clasicus/Diplom/0001.jpg

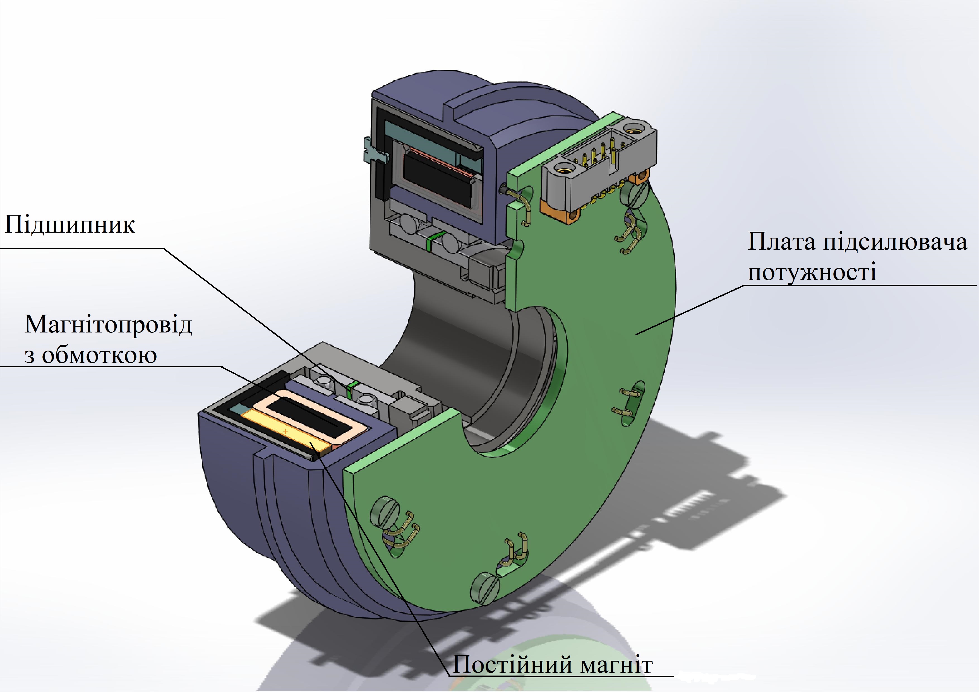
0001.jpg
