clasicus/Diplom/ВЕДОМОСТЬ.docx

ВІДОМІСТЬ ДИПЛОМНОГО ПРОЕКТУ

№ з/п | Формат | | Позначення | | | Найменування | | | Кількість листів | | Примітка
1 | А4 | | | | | Завдання на дипломний проект | | | 3
2 | А4 | | ДК61с.466452.001 ПЗ | | | Автоматична фотометрична система. Пояснювальна записка | | | 75
3 | А3 | | ДК61с.466452.001 Є1 | | | Автоматична фотометрична система. Схема ділення структурна | | | 1
4 | А2 | | ДК61с.466345.001 Е1 | | | Блок вимірювання. Схема електрична структурна | | | 1
5 | А2 | | ДК61с.466345.001 Е3 | | | Блок вимірювання. Схема електрична принципова | | | 1
6 | А4 | | ДК61с.466345.001 ПЕ3 | | | Блок вимірювання. Перелік елементів | | | 3
7 | А3 | | ДК61с.466449.001 Е3 | | | Блок керування. Схема електрична принципова | | | 1
8 | А4 | | ДК61с.466449.001 ПЕ3 | | | Блок керування. Перелік елементів | | | 1
9 | А1 | | ДК61с.758735.001 | | | Плата друкована | | | 1
10 | А1 | | ДК61с.758723.001 | | | Плата друкована | | | 1
11 | А1 | | ДК61с.750706.001 СК | | | Плата. Складальне креслення | | | 1
12 | А4 | | ДК61с.750706.001 СП | | | Плата. Специфікація | | | 3
13 | А1 | | ДК61с.750706.002 СК | | | Плата. Складальне креслення | | | 1
14 | А4 | | ДК61с.750706.002 СП | | | Плата. Специфікація | | | 1
15 | А1 | | ДК61с.735591.001 | | | Кришка | | | 1
16 | А1 | | ДК61с.741124.001 | | | Деталь | | | 1
17 | А1 | | ДК61с.750706.003 СК | | | Корпус. Складальне креслення. | | | 1
18 | А4 | | ДК61с.750706.003 СП | | | Корпус. Специфікація | | | 1
| | ПІБ | | Підп. | Дата
Розробн. | | Адаменко І.О. | | | | | Відомість дипломного проекту | Лист | | Листів
Керівн. | | Губар В.Г. | | | | | | 1 | | 1
Консульт. | | | | | | | | НТУУ «КПІ ім. І.Сікорського» Каф. КЕОА Гр. ДК-61с
Н.контр. | | Лисенко О.І.
