clasicus/Diplom/ДИПЛОМ/Altium/Документация/ecs-3961_3963.pdf

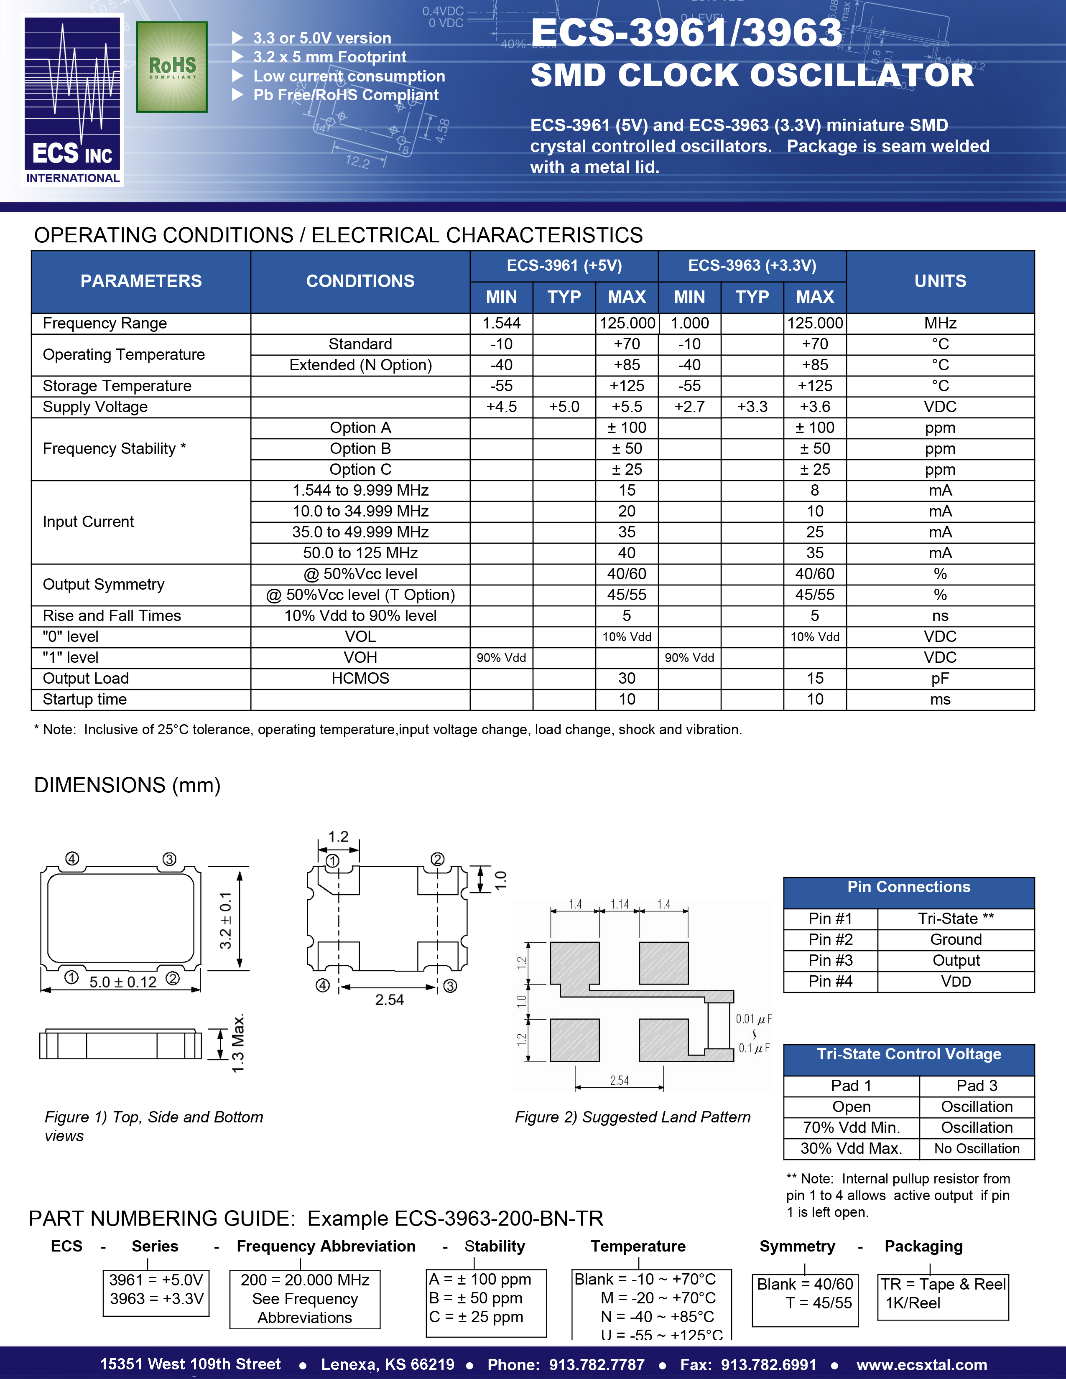
[picture p29: page 1]
