clasicus/Diplom/ДИПЛОМ/Altium/Документация/Папка/АЧАД.524656.003АСК_2/АЧАД.52хххх.ххх_Э3.pdf

Лист Инв.№ подл. Подп.и дата Взам.инв.№ Инв.№ дубл. Справ.№ Перв.примен. | Лит. | Масштаб Подп. и дата

Формат A4

| | | | | АЧАД.52хххх.ххх Э3
| | | | | Двигун СХЕМА ЕЛЕКТРИЧНА ПРИНЦИПОВА | | Масса
Изм. | Лист | № докум. | Подп. | Дата
Разраб. | | Ільницька ЛЛ
| | Пров. | Бондарчук ПС
Т.контр. | | | | | | Листов 1
Нач.сект. | | | | | ТОВ "Радіонікс"
Н.контр.
Утв.

### 1 АЧАД.52хххх.ххх

Копировал

Коло | Конт.
XS1 | A
+ | MA1

Поз.
обозна- | Наименование
чение
Кол. | Примечание
