clasicus/Diplom/ААЭД.521366.002 СБ Двигун.JPG

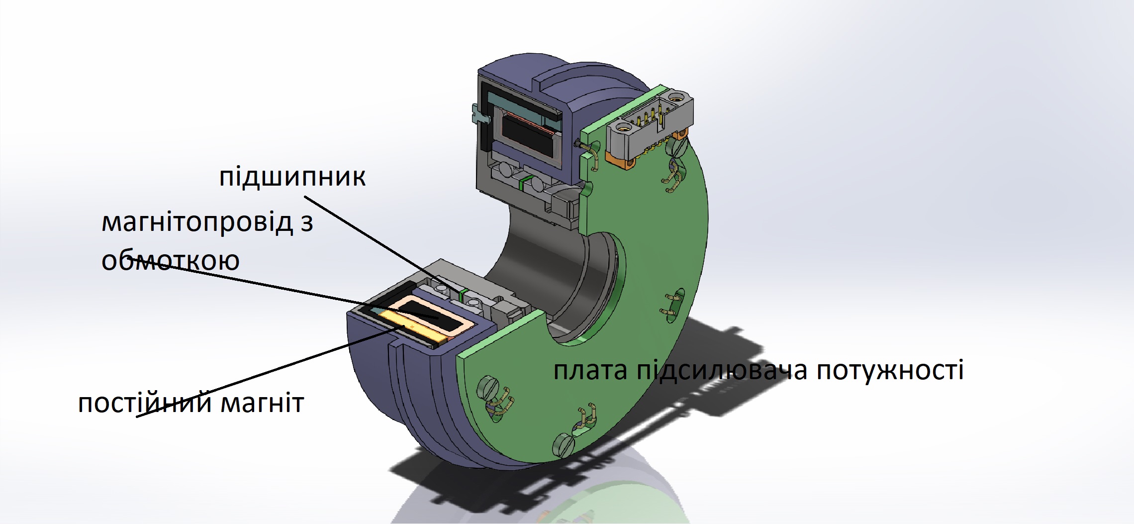
ААЭД.521366.002 СБ Двигун.JPG
