clasicus/Diplom/ДИПЛОМ/Структурка.jpg

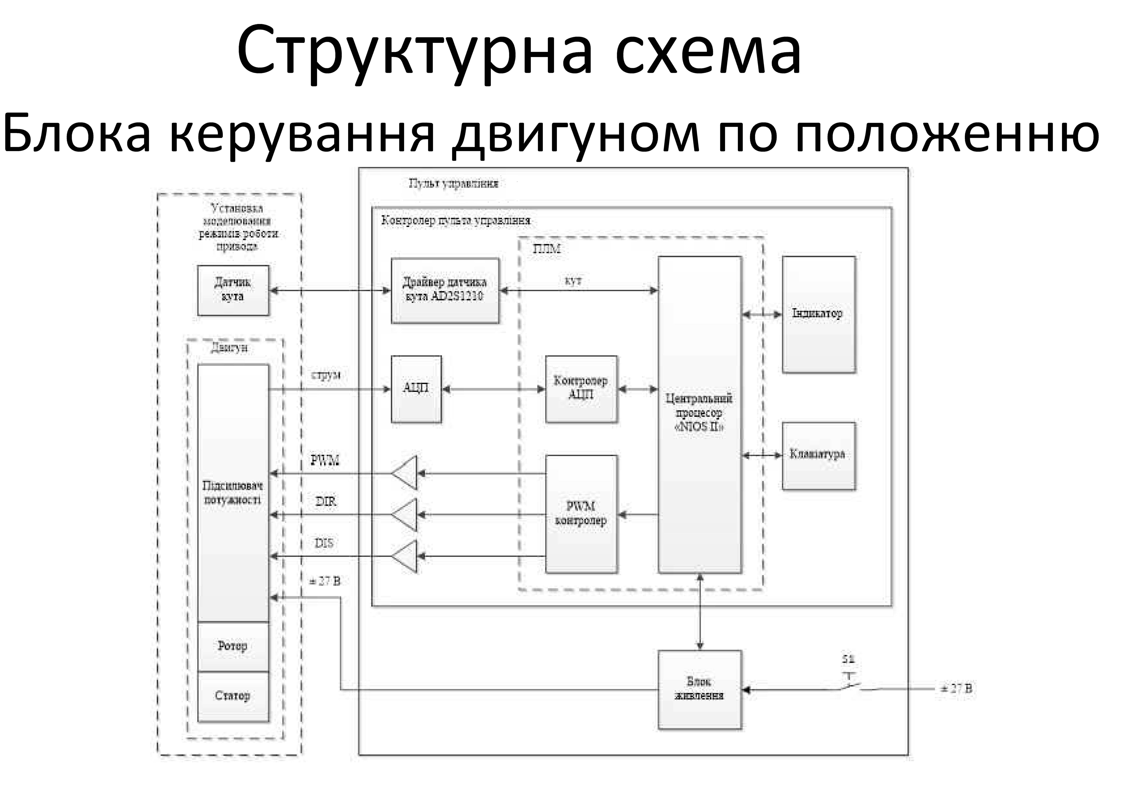
ДИПЛОМ/Структурка.jpg
