clasicus/Diplom/лак.jpg

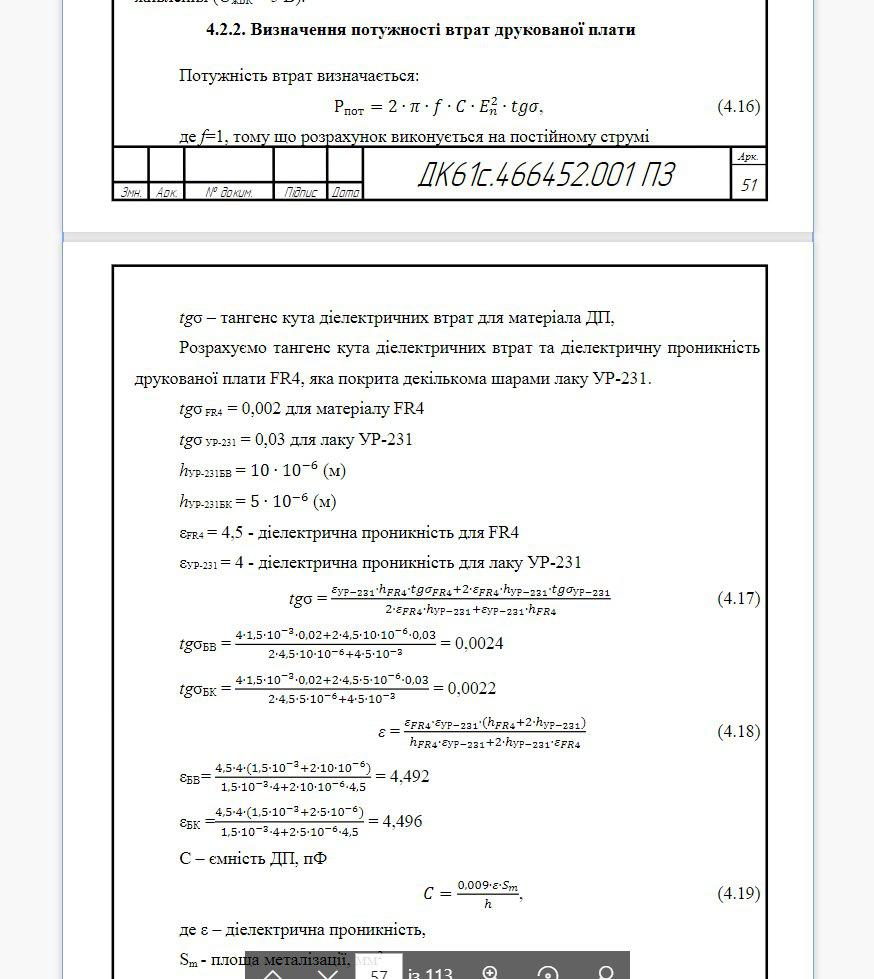
лак.jpg
