clasicus/Diplom/Структура.jpg

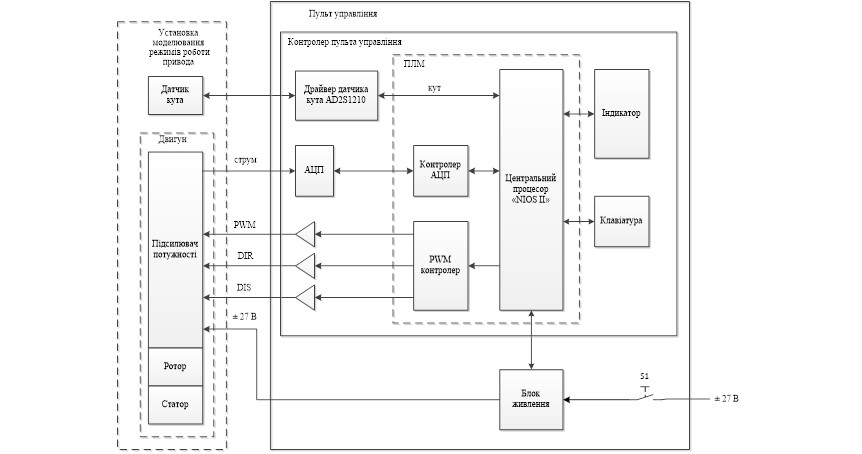
Структура.jpg
