clasicus/Diplom/ДИПЛОМ/Altium/step/B2B-XH-A.STEP

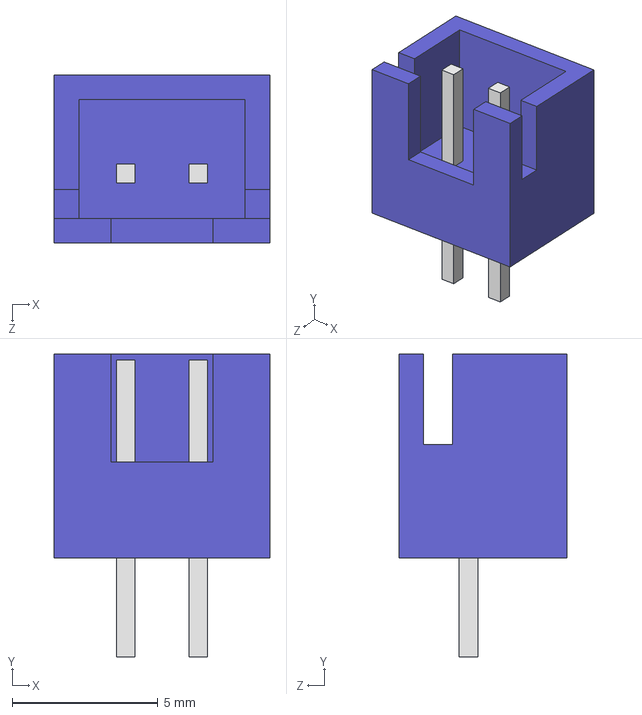
[picture p34: CAD file, 2018-06-04]
ДИПЛОМ/Altium/step/B2B-XH-A.STEP
7.40 x 10.4 x 5.75 mm
