clasicus/Diplom/ДИПЛОМ/Altium/step/CONN_5747845-4.step

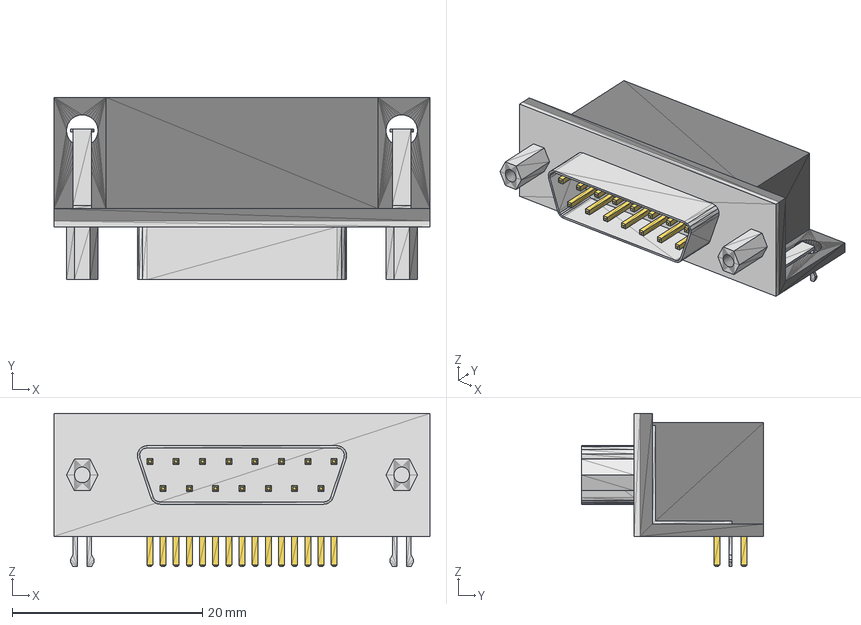
[picture p35: CAD file, 2018-06-04]
ДИПЛОМ/Altium/step/CONN_5747845-4.step
39.5 x 19.2 x 16.1 mm
