clasicus/Diplom/ДИПЛОМ/Altium/step/connector_a-df_09_a_kg-t2.stp

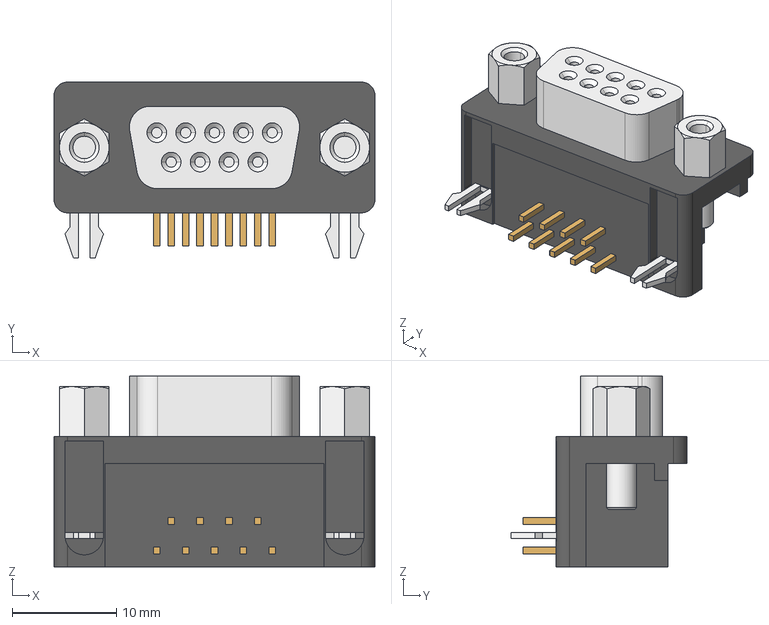
[picture p36: CAD file, 2018-06-04]
ДИПЛОМ/Altium/step/connector_a-df_09_a_kg-t2.stp
30.8 x 16.9 x 18.3 mm
