clasicus/Diplom/ДИПЛОМ/Altium/step/m80-5101042_asm.stp

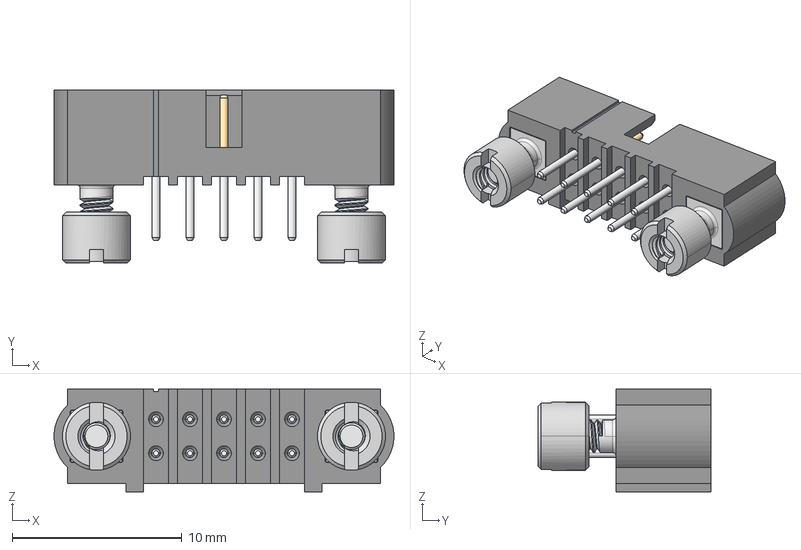
[picture p37: CAD file, 2018-06-04]
ДИПЛОМ/Altium/step/m80-5101042_asm.stp
20.0 x 10.2 x 6.05 mm
M80-2702098
M80-0200049 x 10
M80-211 x 2
M80-213 x 2
