clasicus/Diplom/(list of files, cad)

Other CAD files:
ДИПЛОМ/ДК41.758726.001 Плата друкована.dwg
ДИПЛОМ/Структурка.dwg
ДИПЛОМ/ДК41.750706.001 СК Плата. Складальне креслення.dwg
ДИПЛОМ/Сборка.DWG
Controller_ASK2/AD7687/simulation/modelsim/altera_reserved_qsys_cpu_ASK2/altera_avalon_sc_fifo/verilog.psm
Controller_ASK2/AD7687/simulation/modelsim/altera_reserved_qsys_cpu_ASK2/altera_merlin_arb_adder/verilog.psm
Controller_ASK2/AD7687/simulation/modelsim/altera_reserved_qsys_cpu_ASK2/altera_merlin_arbitrator/verilog.psm
Controller_ASK2/AD7687/simulation/modelsim/altera_reserved_qsys_cpu_ASK2/altera_merlin_burst_uncompressor/verilog.psm
Controller_ASK2/AD7687/simulation/modelsim/altera_reserved_qsys_cpu_ASK2/altera_merlin_master_agent/verilog.psm
Controller_ASK2/AD7687/simulation/modelsim/altera_reserved_qsys_cpu_ASK2/altera_merlin_master_translator/verilog.psm
Controller_ASK2/AD7687/simulation/modelsim/altera_reserved_qsys_cpu_ASK2/altera_merlin_slave_agent/verilog.psm
Controller_ASK2/AD7687/simulation/modelsim/altera_reserved_qsys_cpu_ASK2/altera_merlin_slave_translator/verilog.psm
Controller_ASK2/AD7687/simulation/modelsim/altera_reserved_qsys_cpu_ASK2/altera_merlin_traffic_limiter/verilog.psm
Controller_ASK2/AD7687/simulation/modelsim/altera_reserved_qsys_cpu_ASK2/altera_reset_controller/verilog.psm
Controller_ASK2/AD7687/simulation/modelsim/altera_reserved_qsys_cpu_ASK2/altera_reset_synchronizer/verilog.psm
Controller_ASK2/AD7687/simulation/modelsim/altera_reserved_qsys_cpu_ASK2/cpu_@a@s@k2/verilog.psm
Controller_ASK2/AD7687/simulation/modelsim/altera_reserved_qsys_cpu_ASK2/cpu_@a@s@k2_addr_router/verilog.psm
Controller_ASK2/AD7687/simulation/modelsim/altera_reserved_qsys_cpu_ASK2/cpu_@a@s@k2_addr_router_001/verilog.psm
Controller_ASK2/AD7687/simulation/modelsim/altera_reserved_qsys_cpu_ASK2/cpu_@a@s@k2_addr_router_001_default_decode/verilog.psm
Controller_ASK2/AD7687/simulation/modelsim/altera_reserved_qsys_cpu_ASK2/cpu_@a@s@k2_addr_router_default_decode/verilog.psm
Controller_ASK2/AD7687/simulation/modelsim/altera_reserved_qsys_cpu_ASK2/cpu_@a@s@k2_cmd_xbar_demux/verilog.psm
Controller_ASK2/AD7687/simulation/modelsim/altera_reserved_qsys_cpu_ASK2/cpu_@a@s@k2_cmd_xbar_demux_001/verilog.psm
Controller_ASK2/AD7687/simulation/modelsim/altera_reserved_qsys_cpu_ASK2/cpu_@a@s@k2_cmd_xbar_mux/verilog.psm
Controller_ASK2/AD7687/simulation/modelsim/altera_reserved_qsys_cpu_ASK2/cpu_@a@s@k2_id_router/verilog.psm
Controller_ASK2/AD7687/simulation/modelsim/altera_reserved_qsys_cpu_ASK2/cpu_@a@s@k2_id_router_002/verilog.psm
Controller_ASK2/AD7687/simulation/modelsim/altera_reserved_qsys_cpu_ASK2/cpu_@a@s@k2_id_router_002_default_decode/verilog.psm
Controller_ASK2/AD7687/simulation/modelsim/altera_reserved_qsys_cpu_ASK2/cpu_@a@s@k2_id_router_default_decode/verilog.psm
Controller_ASK2/AD7687/simulation/modelsim/altera_reserved_qsys_cpu_ASK2/cpu_@a@s@k2_irq_mapper/verilog.psm
Controller_ASK2/AD7687/simulation/modelsim/altera_reserved_qsys_cpu_ASK2/cpu_@a@s@k2_jtag_uart_0/verilog.psm
Controller_ASK2/AD7687/simulation/modelsim/altera_reserved_qsys_cpu_ASK2/cpu_@a@s@k2_jtag_uart_0_scfifo_r/verilog.psm
Controller_ASK2/AD7687/simulation/modelsim/altera_reserved_qsys_cpu_ASK2/cpu_@a@s@k2_jtag_uart_0_scfifo_w/verilog.psm
Controller_ASK2/AD7687/simulation/modelsim/altera_reserved_qsys_cpu_ASK2/cpu_@a@s@k2_jtag_uart_0_sim_scfifo_r/verilog.psm
Controller_ASK2/AD7687/simulation/modelsim/altera_reserved_qsys_cpu_ASK2/cpu_@a@s@k2_jtag_uart_0_sim_scfifo_w/verilog.psm
Controller_ASK2/AD7687/simulation/modelsim/altera_reserved_qsys_cpu_ASK2/cpu_@a@s@k2_onchip_memory2_0/verilog.psm
Controller_ASK2/AD7687/simulation/modelsim/altera_reserved_qsys_cpu_ASK2/cpu_@a@s@k2_pio_@a1_@a0/verilog.psm
Controller_ASK2/AD7687/simulation/modelsim/altera_reserved_qsys_cpu_ASK2/cpu_@a@s@k2_pio_@i_max/verilog.psm
Controller_ASK2/AD7687/simulation/modelsim/altera_reserved_qsys_cpu_ASK2/cpu_@a@s@k2_pio_@s@d@o_@a@d@c/verilog.psm
Controller_ASK2/AD7687/simulation/modelsim/altera_reserved_qsys_cpu_ASK2/cpu_@a@s@k2_pio_angle/verilog.psm
Controller_ASK2/AD7687/simulation/modelsim/altera_reserved_qsys_cpu_ASK2/cpu_@a@s@k2_pio_keyboard_@s@w6_@s@w1/verilog.psm
Controller_ASK2/AD7687/simulation/modelsim/altera_reserved_qsys_cpu_ASK2/cpu_@a@s@k2_pio_lcd_control/verilog.psm
Controller_ASK2/AD7687/simulation/modelsim/altera_reserved_qsys_cpu_ASK2/cpu_@a@s@k2_pio_lcd_data/verilog.psm
Controller_ASK2/AD7687/simulation/modelsim/altera_reserved_qsys_cpu_ASK2/cpu_@a@s@k2_pio_res_n@s@o@e/verilog.psm
Controller_ASK2/AD7687/simulation/modelsim/altera_reserved_qsys_cpu_ASK2/cpu_@a@s@k2_pio_res_n@wr/verilog.psm
Controller_ASK2/AD7687/simulation/modelsim/altera_reserved_qsys_cpu_ASK2/cpu_@a@s@k2_rsp_xbar_demux/verilog.psm
Controller_ASK2/AD7687/simulation/modelsim/altera_reserved_qsys_cpu_ASK2/cpu_@a@s@k2_rsp_xbar_demux_002/verilog.psm
Controller_ASK2/AD7687/simulation/modelsim/altera_reserved_qsys_cpu_ASK2/cpu_@a@s@k2_rsp_xbar_mux/verilog.psm
Controller_ASK2/AD7687/simulation/modelsim/altera_reserved_qsys_cpu_ASK2/cpu_@a@s@k2_rsp_xbar_mux_001/verilog.psm
Controller_ASK2/AD7687/simulation/modelsim/altera_reserved_qsys_cpu_ASK2/cpu_@a@s@k2_sysid_qsys_0/verilog.psm
Controller_ASK2/AD7687/simulation/modelsim/rtl_work/@a@d7687/verilog.psm
Controller_ASK2/AD7687/simulation/modelsim/rtl_work/@a@d7687_vlg_tst/verilog.psm
Controller_ASK2/AD7687/simulation/modelsim/rtl_work/@r@e@s@t_@global/verilog.psm
Controller_ASK2/AD7687/simulation/modelsim/rtl_work/pll0/syn.psm
Controller_ASK2/AD7687/simulation/modelsim/rtl_work/pll0_altpll/verilog.psm
Controller_ASK2/AD7687/simulation/modelsim/rtl_work/pwm_ver/verilog.psm
Controller_ASK2/PWM_ver/simulation/modelsim/rtl_work/pwm_ver/verilog.psm
Controller_ASK2/PWM_ver/simulation/modelsim/rtl_work/pwm_ver_vlg_tst/verilog.psm
Controller_ASK2/SYS_REST/simulation/modelsim/rtl_work/@s@y@s_@r@e@s@t/verilog.psm
Controller_ASK2/SYS_REST/simulation/modelsim/rtl_work/@s@y@s_@r@e@s@t_vlg_tst/verilog.psm
Controller_ASK2/simulation/modelsim/gate_work/@a@d7687_vlg_tst/verilog.psm
ДИПЛОМ/ДК41.750706.001 СК Плата.Складальне креслення.dwg
