clasicus/Diplom/Controller_ASK2/test_bsp/summary.html

### BSP Description

BSP Type: | hal
SOPC Design File: | D:\work\RADIONIX\KOORDINATOR\ALTERA_13\Controller_ASK2\cpu_ASK2.sopcinfo
Quartus JDI File: | default
CPU: | nios2_qsys_0
BSP Settings File: | .\settings.bsp
BSP Version: | default
BSP Generated On: | 17.05.2018 15:47:44
BSP Generated Timestamp: | 1526561264469
BSP Generated Location: | D:\work\RADIONIX\KOORDINATOR\ALTERA_13\Controller_ASK2\test_bsp

### Nios II Memory Map

Slave Descriptor | Address Range | Size | Attributes
jtag_uart_0 | 0x000050E8 - 0x000050EF | 8 | printable
sysid_qsys_0 | 0x000050E0 - 0x000050E7 | 8
pio_angle | 0x000050D0 - 0x000050DF | 16
pio_lcd_data | 0x000050C0 - 0x000050CF | 16
pio_lcd_control | 0x000050B0 - 0x000050BF | 16
pio_res_nWr | 0x000050A0 - 0x000050AF | 16
pio_res_nRd | 0x00005090 - 0x0000509F | 16
pio_res_nSample | 0x00005080 - 0x0000508F | 16
pio_res_nSOE | 0x00005070 - 0x0000507F | 16
pio_res_nCS | 0x00005060 - 0x0000506F | 16
pio_A1_A0 | 0x00005050 - 0x0000505F | 16
pio_keyboard_SW6_SW1 | 0x00005040 - 0x0000504F | 16
pio_SDO_ADC | 0x00005030 - 0x0000503F | 16
pio_I_max | 0x00005020 - 0x0000502F | 16
pio_PWM_IN | 0x00005010 - 0x0000501F | 16
pio_LED2_LED1 | 0x00005000 - 0x0000500F | 16
onchip_memory2_0 | 0x00002000 - 0x00003F9F | 8096 | memory

### Linker Regions

Region | Address Range | Size | Memory | Offset

### Linker Section Mappings

Section | Region
.text | onchip_memory2_0
.rodata | onchip_memory2_0
.rwdata | onchip_memory2_0
.bss | onchip_memory2_0
.heap | onchip_memory2_0
.stack | onchip_memory2_0

### Settings

Setting Name: | altera_avalon_jtag_uart_driver.enable_jtag_uart_ignore_fifo_full_error
Identifier: | ALTERA_AVALON_JTAG_UART_IGNORE_FIFO_FULL_ERROR
Default Value: | false
Value: | false
Type: | BooleanDefineOnly
Destination: | public_mk_define
Description: | Enable JTAG UART driver to recover when host is inactive causing buffer to full without returning error. Printf will not fail with this recovery.
Restrictions: | none

Setting Name: | altera_avalon_jtag_uart_driver.enable_small_driver
Identifier: | ALTERA_AVALON_JTAG_UART_SMALL
Default Value: | false
Value: | false
Type: | BooleanDefineOnly
Destination: | public_mk_define
Description: | Small-footprint (polled mode) driver
Restrictions: | none

Setting Name: | hal.custom_newlib_flags
Identifier: | CUSTOM_NEWLIB_FLAGS
Default Value: | none
Value: | none
Type: | UnquotedString
Destination: | public_mk_define
Description: | Build a custom version of newlib with the specified space-separated compiler flags.
Restrictions: | The custom newlib build will be placed in the &lt;bsp root>/newlib directory, and will be used only for applications that utilize this BSP.

Setting Name: | hal.enable_c_plus_plus
Identifier: | ALT_NO_C_PLUS_PLUS
Default Value: | 1
Value: | 0
Type: | Boolean
Destination: | public_mk_define
Description: | Enable support for a subset of the C++ language. This option increases code footprint by adding support for C++ constructors. Certain features, such as multiple inheritance and exceptions are not supported. If false, adds -DALT_NO_C_PLUS_PLUS to ALT_CPPFLAGS in public.mk, and reduces code footprint.
Restrictions: | none

Setting Name: | hal.enable_clean_exit
Identifier: | ALT_NO_CLEAN_EXIT
Default Value: | 1
Value: | 0
Type: | Boolean
Destination: | public_mk_define
Description: | When your application exits, close file descriptors, call C++ destructors, etc. Code footprint can be reduced by disabling clean exit. If disabled, adds -DALT_NO_CLEAN_EXIT to ALT_CPPFLAGS and -Wl,--defsym, exit=_exit to ALT_LDFLAGS in public.mk.
Restrictions: | none

Setting Name: | hal.enable_exit
Identifier: | ALT_NO_EXIT
Default Value: | 1
Value: | 0
Type: | Boolean
Destination: | public_mk_define
Description: | Add exit() support. This option increases code footprint if your "main()" routine does "return" or call "exit()". If false, adds -DALT_NO_EXIT to ALT_CPPFLAGS in public.mk, and reduces footprint
Restrictions: | none

Setting Name: | hal.enable_gprof
Identifier: | ALT_PROVIDE_GMON
Default Value: | 0
Value: | 0
Type: | Boolean
Destination: | public_mk_define
Description: | Causes code to be compiled with gprof profiling enabled and the application ELF to be linked with the GPROF library. If true, adds -DALT_PROVIDE_GMON to ALT_CPPFLAGS and -pg to ALT_CFLAGS in public.mk.
Restrictions: | none

Setting Name: | hal.enable_instruction_related_exceptions_api
Identifier: | ALT_INCLUDE_INSTRUCTION_RELATED_EXCEPTION_API
Default Value: | false
Value: | false
Type: | BooleanDefineOnly
Destination: | system_h_define
Description: | Enables API for registering handlers to service instruction-related exceptions. Enabling this setting increases the size of the exception entry code.
Restrictions: | These exception types can be generated if various processor options are enabled, such as the MMU, MPU, or other advanced exception types.

Setting Name: | hal.enable_lightweight_device_driver_api
Identifier: | ALT_USE_DIRECT_DRIVERS
Default Value: | 0
Value: | 1
Type: | Boolean
Destination: | public_mk_define
Description: | Enables lightweight device driver API. This reduces code and data footprint by removing the HAL layer that maps device names (e.g. /dev/uart0) to file descriptors. Instead, driver routines are called directly. The open(), close(), and lseek() routines will always fail if called. The read(), write(), fstat(), ioctl(), and isatty() routines only work for the stdio devices. If true, adds -DALT_USE_DIRECT_DRIVERS to ALT_CPPFLAGS in public.mk.
Restrictions: | The Altera Host and read-only ZIP file systems can't be used if hal.enable_lightweight_device_driver_api is true.

Setting Name: | hal.enable_mul_div_emulation
Identifier: | ALT_NO_INSTRUCTION_EMULATION
Default Value: | 0
Value: | 0
Type: | Boolean
Destination: | public_mk_define
Description: | Adds code to emulate multiply and divide instructions in case they are executed but aren't present in the CPU. Normally this isn't required because the compiler won't use multiply and divide instructions that aren't present in the CPU. If false, adds -DALT_NO_INSTRUCTION_EMULATION to ALT_CPPFLAGS in public.mk.
Restrictions: | none

Setting Name: | hal.enable_reduced_device_drivers
Identifier: | ALT_USE_SMALL_DRIVERS
Default Value: | 0
Value: | 1
Type: | Boolean
Destination: | public_mk_define

Description:

Certain drivers are compiled with reduced functionality to reduce code footprint. Not all drivers observe this setting. The altera_avalon_uart and altera_avalon_jtag_uart drivers switch from interrupt-driven to polled operation. CAUTION: Several device drivers are disabled entirely. These include the altera_avalon_cfi_flash, altera_avalon_epcs_flash_controller, and altera_avalon_lcd_16207 drivers. This can result in certain API (HAL flash access routines) to fail. You can define a symbol provided by each driver to prevent it from being removed. If true, adds -DALT_USE_SMALL_DRIVERS to ALT_CPPFLAGS in public.mk.
Restrictions: | none

Setting Name: | hal.enable_runtime_stack_checking
Identifier: | ALT_STACK_CHECK
Default Value: | 0
Value: | 0
Type: | Boolean
Destination: | public_mk_define
Description: | Turns on HAL runtime stack checking feature. Enabling this setting causes additional code to be placed into each subroutine call to generate an exception if a stack collision occurs with the heap or statically allocated data. If true, adds -DALT_STACK_CHECK and -mstack-check to ALT_CPPFLAGS in public.mk.
Restrictions: | none

Setting Name: | hal.enable_sim_optimize
Identifier: | ALT_SIM_OPTIMIZE
Default Value: | 0
Value: | 0
Type: | Boolean
Destination: | public_mk_define
Description: | The BSP is compiled with optimizations to speedup HDL simulation such as initializing the cache, clearing the .bss section, and skipping long delay loops. If true, adds -DALT_SIM_OPTIMIZE to ALT_CPPFLAGS in public.mk.
Restrictions: | When this setting is true, the BSP shouldn't be used to build applications that are expected to run real hardware.

Setting Name: | hal.enable_small_c_library
Identifier: | NONE
Default Value: | 0
Value: | 1
Type: | Boolean
Destination: | public_mk_define
Description: | Causes the small newlib (C library) to be used. This reduces code and data footprint at the expense of reduced functionality. Several newlib features are removed such as floating-point support in printf(), stdin input routines, and buffered I/O. The small C library is not compatible with Micrium MicroC/OS-II. If true, adds -msmallc to ALT_LDFLAGS in public.mk.
Restrictions: | none

Setting Name: | hal.enable_sopc_sysid_check
Identifier: | NONE
Default Value: | 1
Value: | 1
Type: | Boolean
Destination: | public_mk_define

Description:

Enable SOPC Builder System ID. If a System ID SOPC Builder component is connected to the CPU associated with this BSP, it will be enabled in the creation of command-line arguments to download an ELF to the target. Otherwise, system ID and timestamp values are left out of public.mk for application Makefile "download-elf" target definition. With the system ID check disabled, the Nios II EDS tools will not automatically ensure that the application .elf file (and BSP it is linked against) corresponds to the hardware design on the target. If false, adds --accept-bad-sysid to SOPC_SYSID_FLAG in public.mk.
Restrictions: | none

Setting Name: | hal.linker.allow_code_at_reset
Identifier: | ALT_ALLOW_CODE_AT_RESET
Default Value: | 0
Value: | 1
Type: | Boolean
Destination: | none
Description: | Indicates if initialization code is allowed at the reset address. If true, defines the macro ALT_ALLOW_CODE_AT_RESET in linker.h.
Restrictions: | If true, defines the macro ALT_ALLOW_CODE_AT_RESET in linker.h. This setting is typically false if an external bootloader (e.g. flash bootloader) is present.

Setting Name: | hal.linker.enable_alt_load
Identifier: | NONE
Default Value: | 0
Value: | 1
Type: | Boolean
Destination: | none
Description: | Enables the alt_load() facility. The alt_load() facility copies sections from the .text memory into RAM. If true, this setting sets up the VMA/LMA of sections in linker.x to allow them to be loaded into the .text memory.
Restrictions: | This setting is typically false if an external bootloader (e.g. flash bootloader) is present.

Setting Name: | hal.linker.enable_alt_load_copy_exceptions
Identifier: | NONE
Default Value: | 0
Value: | 0
Type: | Boolean
Destination: | none
Description: | Causes the alt_load() facility to copy the .exceptions section. If true, this setting defines the macro ALT_LOAD_COPY_EXCEPTIONS in linker.h.
Restrictions: | none

Setting Name: | hal.linker.enable_alt_load_copy_rodata
Identifier: | NONE
Default Value: | 0
Value: | 0
Type: | Boolean
Destination: | none
Description: | Causes the alt_load() facility to copy the .rodata section. If true, this setting defines the macro ALT_LOAD_COPY_RODATA in linker.h.
Restrictions: | none

Setting Name: | hal.linker.enable_alt_load_copy_rwdata
Identifier: | NONE
Default Value: | 0
Value: | 1
Type: | Boolean
Destination: | none
Description: | Causes the alt_load() facility to copy the .rwdata section. If true, this setting defines the macro ALT_LOAD_COPY_RWDATA in linker.h.
Restrictions: | none

Setting Name: | hal.linker.enable_exception_stack
Identifier: | NONE
Default Value: | 0
Value: | 0
Type: | Boolean
Destination: | none
Description: | Enables use of a separate exception stack. If true, defines the macro ALT_EXCEPTION_STACK in linker.h, adds a memory region called exception_stack to linker.x, and provides the symbols __alt_exception_stack_pointer and __alt_exception_stack_limit in linker.x.
Restrictions: | The hal.linker.exception_stack_size and hal.linker.exception_stack_memory_region_name settings must also be valid. This setting must be false for MicroC/OS-II BSPs. The exception stack can be used to improve interrupt and other exception performance if the EIC is *not* used.

Setting Name: | hal.linker.enable_interrupt_stack
Identifier: | NONE
Default Value: | 0
Value: | 0
Type: | Boolean
Destination: | none
Description: | Enables use of a separate interrupt stack. If true, defines the macro ALT_INTERRUPT_STACK in linker.h, adds a memory region called interrupt_stack to linker.x, and provides the symbols __alt_interrupt_stack_pointer and __alt_interrupt_stack_limit in linker.x.
Restrictions: | The hal.linker.interrupt_stack_size and hal.linker.interrupt_stack_memory_region_name settings must also be valid. This setting must be false for MicroC/OS-II BSPs. Only enable if the EIC is used exclusively. The exception stack can be used to improve interrupt and other exception performance if the EIC is *not* used.

Setting Name: | hal.linker.exception_stack_memory_region_name
Identifier: | NONE
Default Value: | none
Value: | onchip_memory2_0
Type: | UnquotedString
Destination: | none
Description: | Name of the existing memory region that will be divided up to create the 'exception_stack' memory region. The selected region name will be adjusted automatically when the BSP is generated to create the 'exception_stack' memory region.
Restrictions: | Only used if hal.linker.enable_exception_stack is true.

Setting Name: | hal.linker.exception_stack_size
Identifier: | NONE
Default Value: | 1024
Value: | 1024
Type: | DecimalNumber
Destination: | none
Description: | Size of the exception stack in bytes.
Restrictions: | Only used if hal.linker.enable_exception_stack is true.

Setting Name: | hal.linker.interrupt_stack_memory_region_name
Identifier: | NONE
Default Value: | none
Value: | onchip_memory2_0
Type: | UnquotedString
Destination: | none
Description: | Name of the existing memory region that will be divided up to create the 'interrupt_stack' memory region. The selected region name will be adjusted automatically when the BSP is generated to create the 'interrupt_stack' memory region.
Restrictions: | Only used if hal.linker.enable_interrupt_stack is true.

Setting Name: | hal.linker.interrupt_stack_size
Identifier: | NONE
Default Value: | 1024
Value: | 1024
Type: | DecimalNumber
Destination: | none
Description: | Size of the interrupt stack in bytes.
Restrictions: | Only used if hal.linker.enable_interrupt_stack is true.

Setting Name: | hal.log_flags
Identifier: | ALT_LOG_FLAGS
Default Value: | 0
Value: | 0
Type: | DecimalNumber
Destination: | public_mk_define
Description: | The value is assigned to ALT_LOG_FLAGS in the generated public.mk. See hal.log_port setting description. Values can be -1 through 3.
Restrictions: | hal.log_port must be set for this to be used.

Setting Name: | hal.log_port
Identifier: | NONE
Default Value: | none
Value: | none
Type: | UnquotedString
Destination: | public_mk_define
Description: | Slave descriptor of debug logging character-mode device. If defined, it enables extra debug messages in the HAL source. This setting is used by the ALT_LOG_PORT family of defines in system.h.
Restrictions: | none

Setting Name: | hal.make.ar
Identifier: | AR
Default Value: | nios2-elf-ar
Value: | nios2-elf-ar
Type: | UnquotedString
Destination: | makefile_variable
Description: | Archiver command. Creates library files.
Restrictions: | none

Setting Name: | hal.make.ar_post_process
Identifier: | AR_POST_PROCESS
Default Value: | none
Value: | none
Type: | UnquotedString
Destination: | makefile_variable
Description: | Command executed after archiver execution.
Restrictions: | none

Setting Name: | hal.make.ar_pre_process
Identifier: | AR_PRE_PROCESS
Default Value: | none
Value: | none
Type: | UnquotedString
Destination: | makefile_variable
Description: | Command executed before archiver execution.
Restrictions: | none

Setting Name: | hal.make.as
Identifier: | AS
Default Value: | nios2-elf-gcc
Value: | nios2-elf-gcc
Type: | UnquotedString
Destination: | makefile_variable
Description: | Assembler command. Note that CC is used for .S files.
Restrictions: | none

Setting Name: | hal.make.as_post_process
Identifier: | AS_POST_PROCESS
Default Value: | none
Value: | none
Type: | UnquotedString
Destination: | makefile_variable
Description: | Command executed after each assembly file is compiled.
Restrictions: | none

Setting Name: | hal.make.as_pre_process
Identifier: | AS_PRE_PROCESS
Default Value: | none
Value: | none
Type: | UnquotedString
Destination: | makefile_variable
Description: | Command executed before each assembly file is compiled.
Restrictions: | none

Setting Name: | hal.make.bsp_arflags
Identifier: | BSP_ARFLAGS
Default Value: | -src
Value: | -src
Type: | UnquotedString
Destination: | makefile_variable
Description: | Custom flags only passed to the archiver. This content of this variable is directly passed to the archiver rather than the more standard "ARFLAGS". The reason for this is that GNU Make assumes some default content in ARFLAGS. This setting defines the value of BSP_ARFLAGS in Makefile.
Restrictions: | none

Setting Name: | hal.make.bsp_asflags
Identifier: | BSP_ASFLAGS
Default Value: | -Wa,-gdwarf2
Value: | -Wa,-gdwarf2
Type: | UnquotedString
Destination: | makefile_variable
Description: | Custom flags only passed to the assembler. This setting defines the value of BSP_ASFLAGS in Makefile.
Restrictions: | none

Setting Name: | hal.make.bsp_cflags_debug
Identifier: | BSP_CFLAGS_DEBUG
Default Value: | -g
Value: | -g
Type: | UnquotedString
Destination: | makefile_variable
Description: | C/C++ compiler debug level. '-g' provides the default set of debug symbols typically required to debug a typical application. Omitting '-g' removes debug symbols from the ELF. This setting defines the value of BSP_CFLAGS_DEBUG in Makefile.
Restrictions: | none

Setting Name: | hal.make.bsp_cflags_defined_symbols
Identifier: | BSP_CFLAGS_DEFINED_SYMBOLS
Default Value: | none
Value: | none
Type: | UnquotedString
Destination: | makefile_variable
Description: | Preprocessor macros to define. A macro definition in this setting has the same effect as a "#define" in source code. Adding "-DALT_DEBUG" to this setting has the same effect as "#define ALT_DEBUG" in a souce file. Adding "-DFOO=1" to this setting is equivalent to the macro "#define FOO 1" in a source file. Macros defined with this setting are applied to all .S, .c, and C++ files in the BSP. This setting defines the value of BSP_CFLAGS_DEFINED_SYMBOLS in the BSP Makefile.
Restrictions: | none

Setting Name: | hal.make.bsp_cflags_optimization
Identifier: | BSP_CFLAGS_OPTIMIZATION
Default Value: | -O0
Value: | '-Os'
Type: | UnquotedString
Destination: | makefile_variable
Description: | C/C++ compiler optimization level. "-O0" = no optimization,"-O2" = "normal" optimization, etc. "-O0" is recommended for code that you want to debug since compiler optimization can remove variables and produce non-sequential execution of code while debugging. This setting defines the value of BSP_CFLAGS_OPTIMIZATION in Makefile.
Restrictions: | none

Setting Name: | hal.make.bsp_cflags_undefined_symbols
Identifier: | BSP_CFLAGS_UNDEFINED_SYMBOLS
Default Value: | none
Value: | none
Type: | UnquotedString
Destination: | makefile_variable
Description: | Preprocessor macros to undefine. Undefined macros are similar to defined macros, but replicate the "#undef" directive in source code. To undefine the macro FOO use the syntax "-u FOO" in this setting. This is equivalent to "#undef FOO" in a source file. Note: the syntax differs from macro definition (there is a space, i.e. "-u FOO" versus "-DFOO"). Macros defined with this setting are applied to all .S, .c, and C++ files in the BSP. This setting defines the value of BSP_CFLAGS_UNDEFINED_SYMBOLS in the BSP Makefile.
Restrictions: | none

Setting Name: | hal.make.bsp_cflags_user_flags
Identifier: | BSP_CFLAGS_USER_FLAGS
Default Value: | none
Value: | none
Type: | UnquotedString
Destination: | makefile_variable
Description: | Custom flags passed to the compiler when compiling C, C++, and .S files. This setting defines the value of BSP_CFLAGS_USER_FLAGS in Makefile.
Restrictions: | none

Setting Name: | hal.make.bsp_cflags_warnings
Identifier: | BSP_CFLAGS_WARNINGS
Default Value: | -Wall
Value: | -Wall
Type: | UnquotedString
Destination: | makefile_variable
Description: | C/C++ compiler warning level. "-Wall" is commonly used.This setting defines the value of BSP_CFLAGS_WARNINGS in Makefile.
Restrictions: | none

Setting Name: | hal.make.bsp_cxx_flags
Identifier: | BSP_CXXFLAGS
Default Value: | none
Value: | none
Type: | UnquotedString
Destination: | makefile_variable
Description: | Custom flags only passed to the C++ compiler. This setting defines the value of BSP_CXXFLAGS in Makefile.
Restrictions: | none

Setting Name: | hal.make.bsp_inc_dirs
Identifier: | BSP_INC_DIRS
Default Value: | none
Value: | none
Type: | UnquotedString
Destination: | makefile_variable
Description: | Space separated list of extra include directories to scan for header files. Directories are relative to the top-level BSP directory. The -I prefix's added by the makefile so don't add it here. This setting defines the value of BSP_INC_DIRS in Makefile.
Restrictions: | none

Setting Name: | hal.make.build_post_process
Identifier: | BUILD_POST_PROCESS
Default Value: | none
Value: | none
Type: | UnquotedString
Destination: | makefile_variable
Description: | Command executed after BSP built.
Restrictions: | none

Setting Name: | hal.make.build_pre_process
Identifier: | BUILD_PRE_PROCESS
Default Value: | none
Value: | none
Type: | UnquotedString
Destination: | makefile_variable
Description: | Command executed before BSP built.
Restrictions: | none

Setting Name: | hal.make.cc
Identifier: | CC
Default Value: | nios2-elf-gcc -xc
Value: | nios2-elf-gcc -xc
Type: | UnquotedString
Destination: | makefile_variable
Description: | C compiler command.
Restrictions: | none

Setting Name: | hal.make.cc_post_process
Identifier: | CC_POST_PROCESS
Default Value: | none
Value: | none
Type: | UnquotedString
Destination: | makefile_variable
Description: | Command executed after each .c/.S file is compiled.
Restrictions: | none

Setting Name: | hal.make.cc_pre_process
Identifier: | CC_PRE_PROCESS
Default Value: | none
Value: | none
Type: | UnquotedString
Destination: | makefile_variable
Description: | Command executed before each .c/.S file is compiled.
Restrictions: | none

Setting Name: | hal.make.cxx
Identifier: | CXX
Default Value: | nios2-elf-gcc -xc++
Value: | nios2-elf-gcc -xc++
Type: | UnquotedString
Destination: | makefile_variable
Description: | C++ compiler command.
Restrictions: | none

Setting Name: | hal.make.cxx_post_process
Identifier: | CXX_POST_PROCESS
Default Value: | none
Value: | none
Type: | UnquotedString
Destination: | makefile_variable
Description: | Command executed before each C++ file is compiled.
Restrictions: | none

Setting Name: | hal.make.cxx_pre_process
Identifier: | CXX_PRE_PROCESS
Default Value: | none
Value: | none
Type: | UnquotedString
Destination: | makefile_variable
Description: | Command executed before each C++ file is compiled.
Restrictions: | none

Setting Name: | hal.make.ignore_system_derived.big_endian
Identifier: | NONE
Default Value: | 0
Value: | 0
Type: | Boolean
Destination: | public_mk_define
Description: | Enable BSP generation to query if SOPC system is big endian. If true ignores export of 'ALT_CFLAGS += -EB' to public.mk if big endian system. If true ignores export of 'ALT_CFLAGS += -EL' if little endian system.
Restrictions: | none

Setting Name: | hal.make.ignore_system_derived.debug_core_present
Identifier: | NONE
Default Value: | 0
Value: | 0
Type: | Boolean
Destination: | public_mk_define
Description: | Enable BSP generation to query if SOPC system has a debug core present. If true ignores export of 'CPU_HAS_DEBUG_CORE = 1' to public.mk if a debug core is found in the system. If true ignores export of 'CPU_HAS_DEBUG_CORE = 0' if no debug core is found in the system.
Restrictions: | none

Setting Name: | hal.make.ignore_system_derived.fpu_present
Identifier: | NONE
Default Value: | 0
Value: | 0
Type: | Boolean
Destination: | public_mk_define
Description: | Enable BSP generation to query if SOPC system has FPU present. If true ignores export of 'ALT_CFLAGS += -mhard-float' to public.mk if FPU is found in the system. If true ignores export of 'ALT_CFLAGS += -mhard-soft' if FPU is not found in the system.
Restrictions: | none

Setting Name: | hal.make.ignore_system_derived.hardware_divide_present
Identifier: | NONE
Default Value: | 0
Value: | 0
Type: | Boolean
Destination: | public_mk_define
Description: | Enable BSP generation to query if SOPC system has hardware divide present. If true ignores export of 'ALT_CFLAGS += -mno-hw-div' to public.mk if no division is found in system. If true ignores export of 'ALT_CFLAGS += -mhw-div' if division is found in the system.
Restrictions: | none

Setting Name: | hal.make.ignore_system_derived.hardware_fp_cust_inst_divider_present
Identifier: | NONE
Default Value: | 0
Value: | 0
Type: | Boolean
Destination: | public_mk_define
Description: | Enable BSP generation to query if SOPC system floating point custom instruction with a divider is present. If true ignores export of 'ALT_CFLAGS += -mcustom-fpu-cfg=60-2' and 'ALT_LDFLAGS += -mcustom-fpu-cfg=60-2' to public.mk if the custom instruction is found in the system.
Restrictions: | none

Setting Name: | hal.make.ignore_system_derived.hardware_fp_cust_inst_no_divider_present
Identifier: | NONE
Default Value: | 0
Value: | 0
Type: | Boolean
Destination: | public_mk_define
Description: | Enable BSP generation to query if SOPC system floating point custom instruction without a divider is present. If true ignores export of 'ALT_CFLAGS += -mcustom-fpu-cfg=60-1' and 'ALT_LDFLAGS += -mcustom-fpu-cfg=60-1' to public.mk if the custom instruction is found in the system.
Restrictions: | none

Setting Name: | hal.make.ignore_system_derived.hardware_multiplier_present
Identifier: | NONE
Default Value: | 0
Value: | 0
Type: | Boolean
Destination: | public_mk_define
Description: | Enable BSP generation to query if SOPC system has multiplier present. If true ignores export of 'ALT_CFLAGS += -mno-hw-mul' to public.mk if no multiplier is found in the system. If true ignores export of 'ALT_CFLAGS += -mhw-mul' if multiplier is found in the system.
Restrictions: | none

Setting Name: | hal.make.ignore_system_derived.hardware_mulx_present
Identifier: | NONE
Default Value: | 0
Value: | 0
Type: | Boolean
Destination: | public_mk_define
Description: | Enable BSP generation to query if SOPC system has hardware mulx present. If true ignores export of 'ALT_CFLAGS += -mno-hw-mulx' to public.mk if no mulx is found in the system. If true ignores export of 'ALT_CFLAGS += -mhw-mulx' if mulx is found in the system.
Restrictions: | none

Setting Name: | hal.make.ignore_system_derived.sopc_simulation_enabled
Identifier: | NONE
Default Value: | 0
Value: | 0
Type: | Boolean
Destination: | public_mk_define
Description: | Enable BSP generation to query if SOPC system has simulation enabled. If true ignores export of 'ELF_PATCH_FLAG += --simulation_enabled' to public.mk.
Restrictions: | none

Setting Name: | hal.make.ignore_system_derived.sopc_system_base_address
Identifier: | NONE
Default Value: | 0
Value: | 0
Type: | Boolean
Destination: | public_mk_define
Description: | Enable BSP generation to query SOPC system for system ID base address. If true ignores export of 'SOPC_SYSID_FLAG += --sidp=<address>' and 'ELF_PATCH_FLAG += --sidp=<address>' to public.mk.
Restrictions: | none

Setting Name: | hal.make.ignore_system_derived.sopc_system_id
Identifier: | NONE
Default Value: | 0
Value: | 0
Type: | Boolean
Destination: | public_mk_define
Description: | Enable BSP generation to query SOPC system for system ID. If true ignores export of 'SOPC_SYSID_FLAG += --id=<sysid>' and 'ELF_PATCH_FLAG += --id=<sysid>' to public.mk.
Restrictions: | none

Setting Name: | hal.make.ignore_system_derived.sopc_system_timestamp
Identifier: | NONE
Default Value: | 0
Value: | 0
Type: | Boolean
Destination: | public_mk_define
Description: | Enable BSP generation to query SOPC system for system timestamp. If true ignores export of 'SOPC_SYSID_FLAG += --timestamp=<timestamp>' and 'ELF_PATCH_FLAG += --timestamp=<timestamp>' to public.mk.
Restrictions: | none

Setting Name: | hal.make.rm
Identifier: | RM
Default Value: | rm -f
Value: | rm -f
Type: | UnquotedString
Destination: | makefile_variable
Description: | Command used to remove files during 'clean' target.
Restrictions: | none

Setting Name: | hal.max_file_descriptors
Identifier: | ALT_MAX_FD
Default Value: | 32
Value: | 4
Type: | DecimalNumber
Destination: | system_h_define
Description: | Determines the number of file descriptors statically allocated. This setting defines the value of ALT_MAX_FD in system.h.
Restrictions: | If hal.enable_lightweight_device_driver_api is true, there are no file descriptors so this setting is ignored. If hal.enable_lightweight_device_driver_api is false, this setting must be at least 4 because HAL needs a file descriptor for /dev/null, /dev/stdin, /dev/stdout, and /dev/stderr.

Setting Name: | hal.stderr
Identifier: | NONE
Default Value: | none
Value: | jtag_uart_0
Type: | UnquotedString
Destination: | system_h_define
Description: | Slave descriptor of STDERR character-mode device. This setting is used by the ALT_STDERR family of defines in system.h.
Restrictions: | none

Setting Name: | hal.stdin
Identifier: | NONE
Default Value: | none
Value: | jtag_uart_0
Type: | UnquotedString
Destination: | system_h_define
Description: | Slave descriptor of STDIN character-mode device. This setting is used by the ALT_STDIN family of defines in system.h.
Restrictions: | none

Setting Name: | hal.stdout
Identifier: | NONE
Default Value: | none
Value: | jtag_uart_0
Type: | UnquotedString
Destination: | system_h_define
Description: | Slave descriptor of STDOUT character-mode device. This setting is used by the ALT_STDOUT family of defines in system.h.
Restrictions: | none

Setting Name: | hal.sys_clk_timer
Identifier: | ALT_SYS_CLK
Default Value: | none
Value: | none
Type: | UnquotedString
Destination: | system_h_define
Description: | Slave descriptor of the system clock timer device. This device provides a periodic interrupt ("tick") and is typically required for RTOS use. This setting defines the value of ALT_SYS_CLK in system.h.
Restrictions: | none

Setting Name: | hal.timestamp_timer
Identifier: | ALT_TIMESTAMP_CLK
Default Value: | none
Value: | none
Type: | UnquotedString
Destination: | system_h_define
Description: | Slave descriptor of timestamp timer device. This device is used by Altera HAL timestamp drivers for high-resolution time measurement. This setting defines the value of ALT_TIMESTAMP_CLK in system.h.
Restrictions: | none
