clasicus/Diplom/ДИПЛОМ/ДК41.468224.001 Е3 Блок керування двигуном.pdf

## FPGA

## FPGA

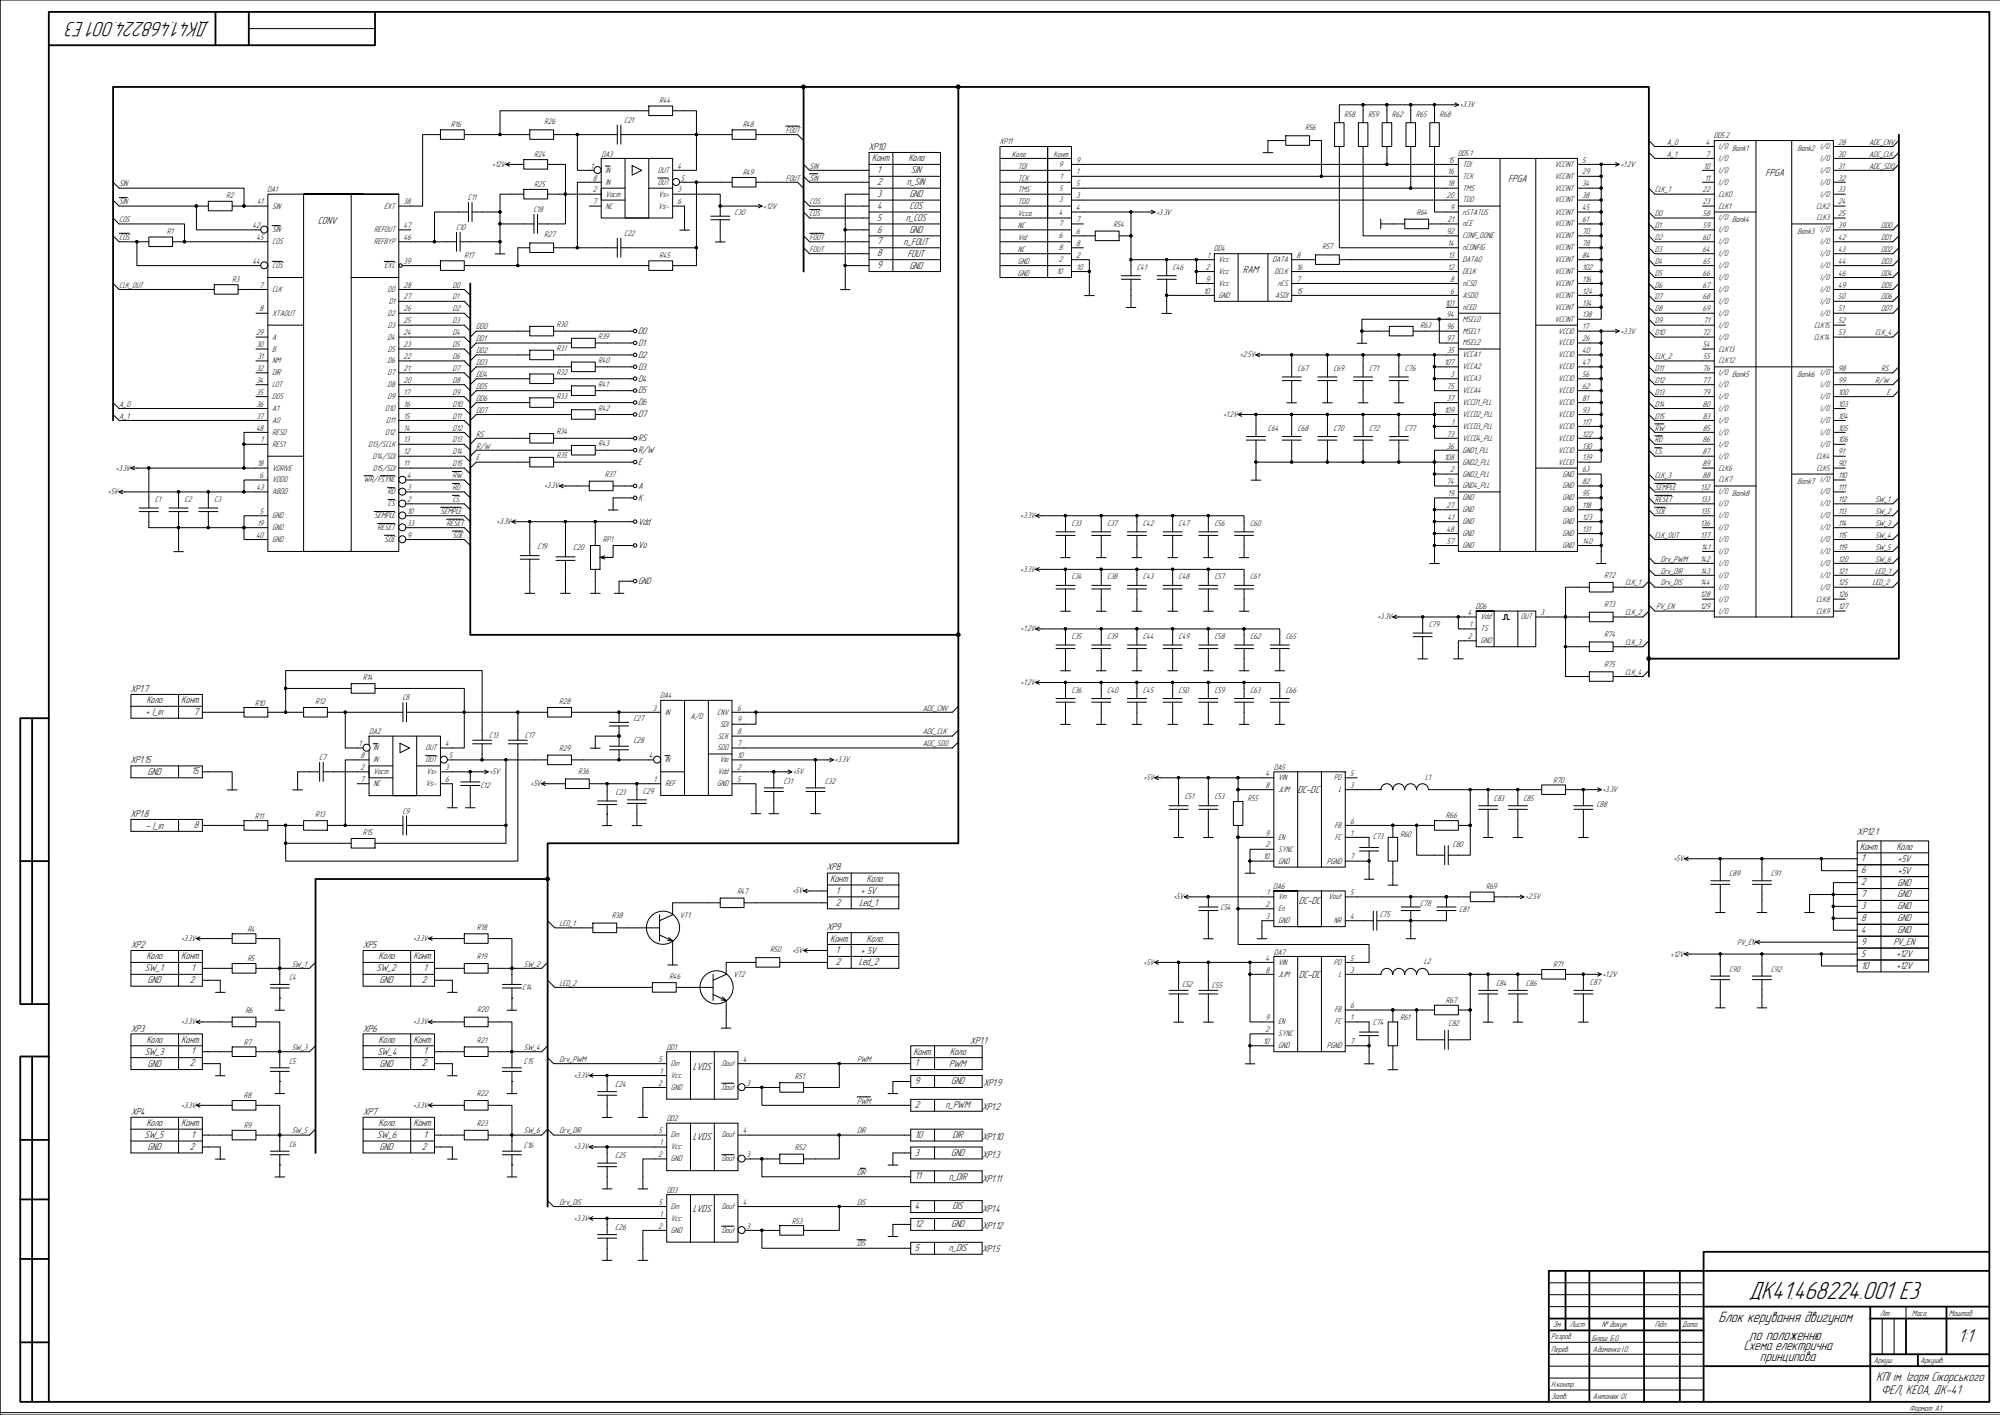
[picture p38: page 1]

6 | +5V
2 | GND

4 | GND

КПІ ім. Ігоря Сікорського
ФЕЛ, КЕОА, ДК-41
