clasicus/Diplom/ДИПЛОМ/Altium/Документация/Папка/АСК_2/АСК_2/АСК_2.PDF

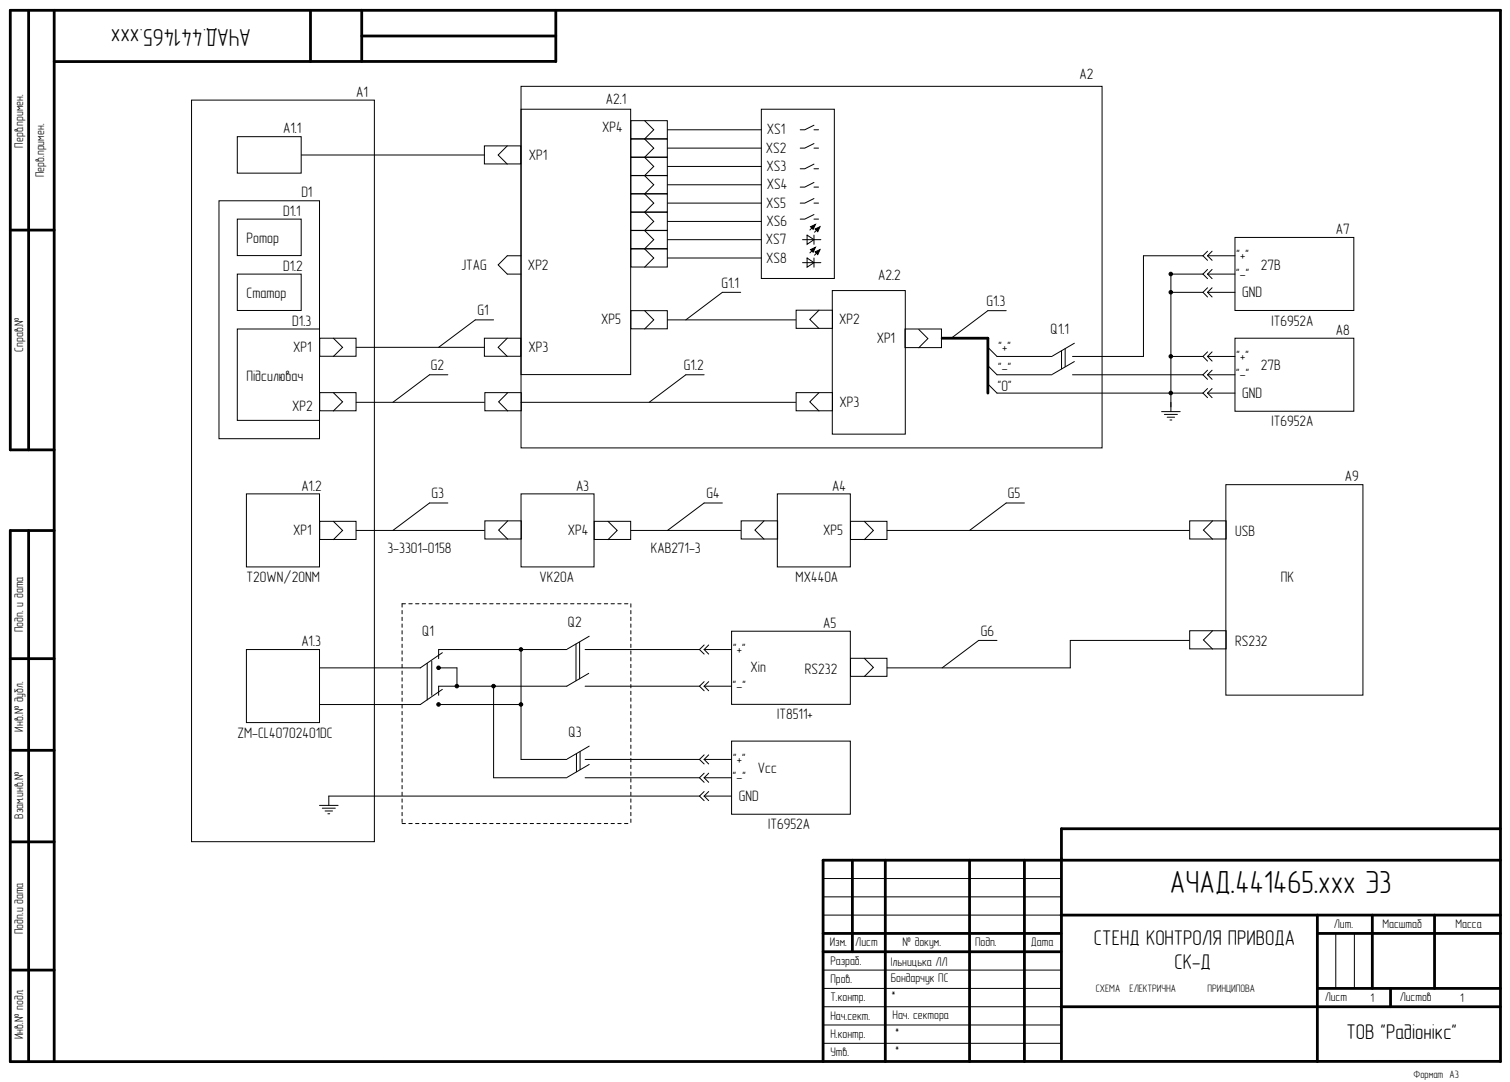
[picture p39: page 1]

Инв.№ подл. Подп.и дата Взам.инв.№ Инв.№ дубл. Подп. и дата

АЧАД.441465.ххх Э3

СТЕНД КОНТРОЛЯ ПРИВОДА СК-Д СХЕМА ЕЛЕКТРИЧНА ПРИНЦИПОВА | Лит. | Масштаб | Масса
Изм. | Лист | № докум. | Подп. | Дата
Разраб. | | Ільницька ЛЛ
Пров. | | Бондарчук ПС
Т.контр. | * | | | | Лист | Листов
Нач.сект. | Нач. сектора | | | | ТОВ "Радіонікс"
Н.контр.
Утв.

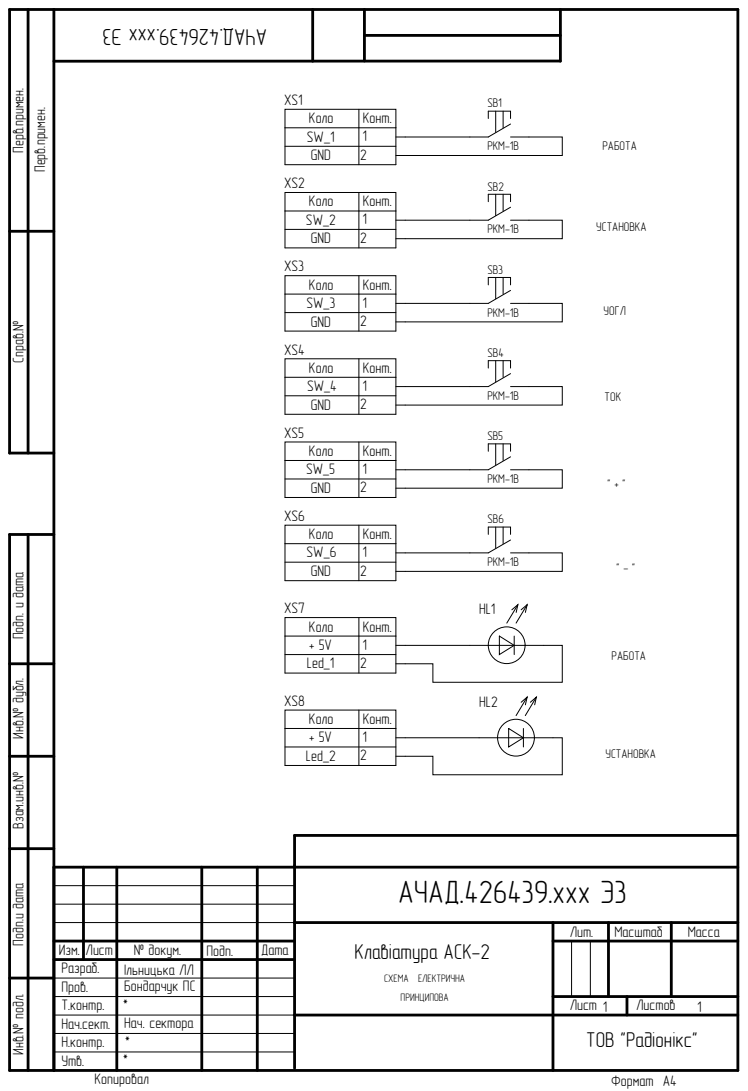
[picture p40: page 2]

Инв.№ подл. Подп.и дата Взам.инв.№ Инв.№ дубл. Справ.№ Перв.примен.

Коло | Конт.
SW_1 | 1
GND | 2

SW_2 | 1

SW_3 | 1

SW_4 | 1

SW_5 | 1

SW_6 | 1

+ 5V | 1
Led_1 | 2

Led_2 | 2

АЧАД.426439.xxx Э3

Клавіатура АСК-2 СХЕМА ЕЛЕКТРИЧНА ПРИНЦИПОВА | Лит. | Масштаб | Масса
Изм. | Лист | № докум. | Подп. | Дата
Разраб. | | Ільницька ЛЛ
Пров. | Бондарчук ПС
Т.контр.
Нач.сект. | Нач. сектора | | | | ТОВ "Радіонікс"

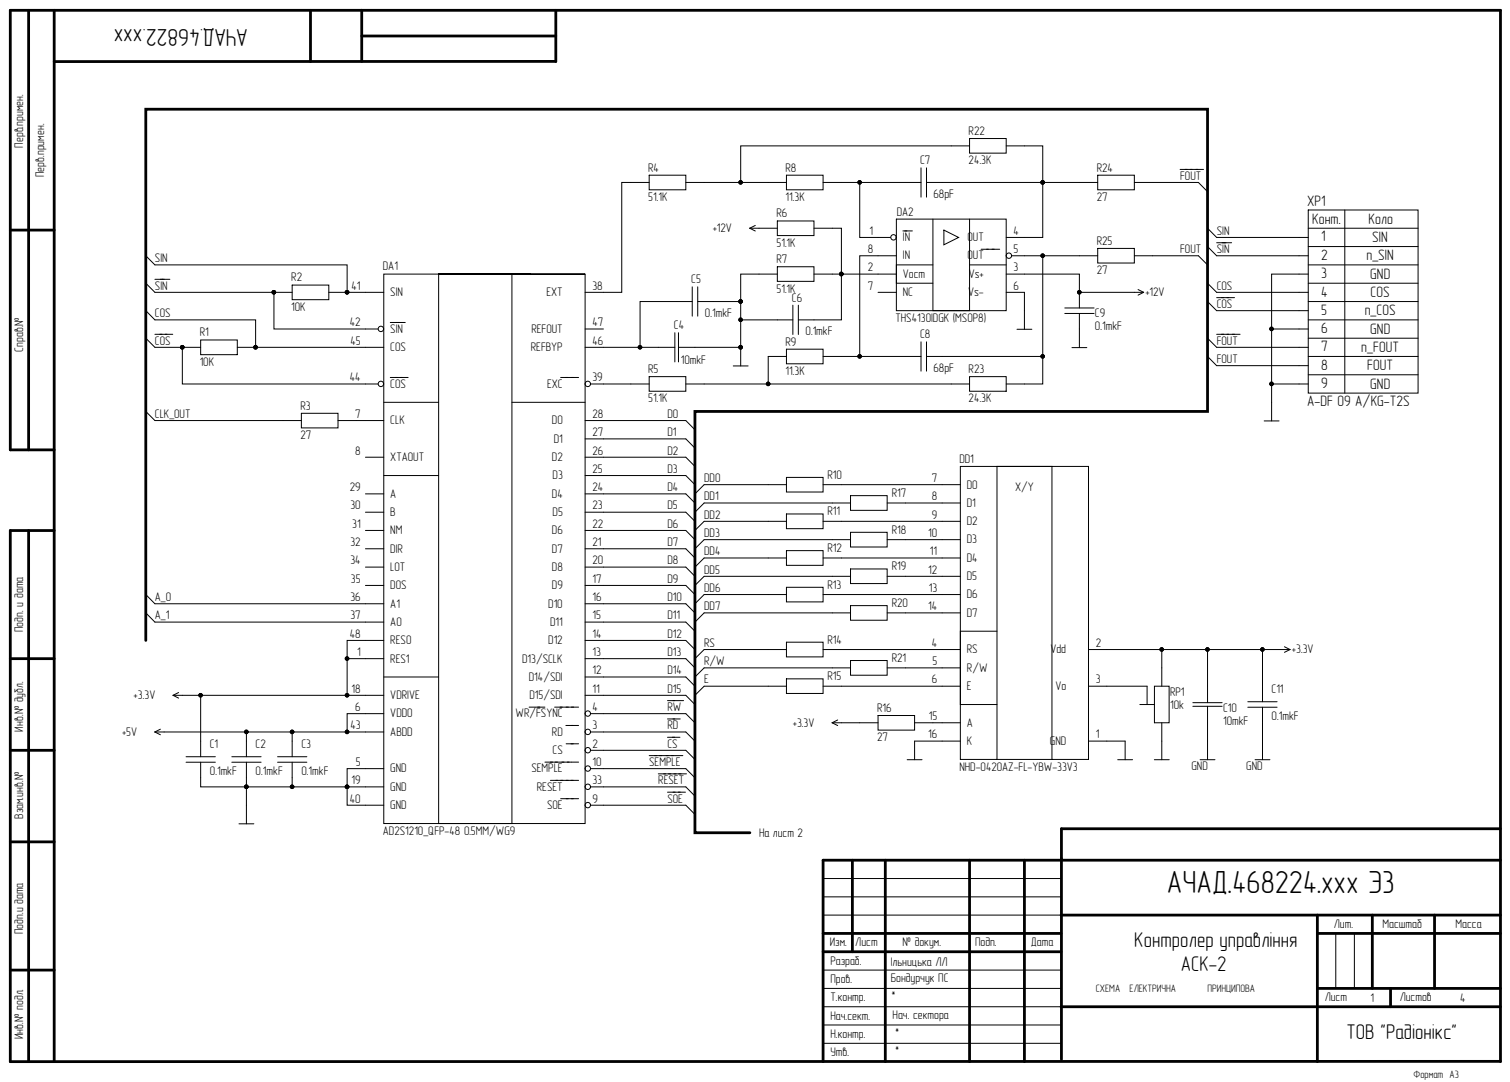
[picture p41: page 3]

OUT | 6 NC

n_SIN

R1 | COS 45

n_FOUT

RES1 | D4

NM 31 | D6
DIR 32 | D7
LOT 34 | D8
DOS 35 | D9
A1 36 | D10

Инв.№ подл. Подп.и дата Взам.инв.№ Инв.№ дубл. Подп. и дата

RES0 48 | | D12
1 | | | D13
VDRIVE 18 | | D14

VDD0 GND | | D15

АЧАД .468224.ххх Э 3

Контролер управл іння СХЕМА ЕЛЕКТРИЧНА АСК-2 ПРИНЦИПОВА Ільницька ЛЛ | Лит . | Масштаб | Масса
Изм . | Лист | № докум . | Подп . | Дата
Разраб . .
Т .контр . | | Бондурчук ПС ***
Пров

Нач .сект . | | Нач . сектора | | | | ТОВ "Рад іон ікс "
Н .контр .
Утв .

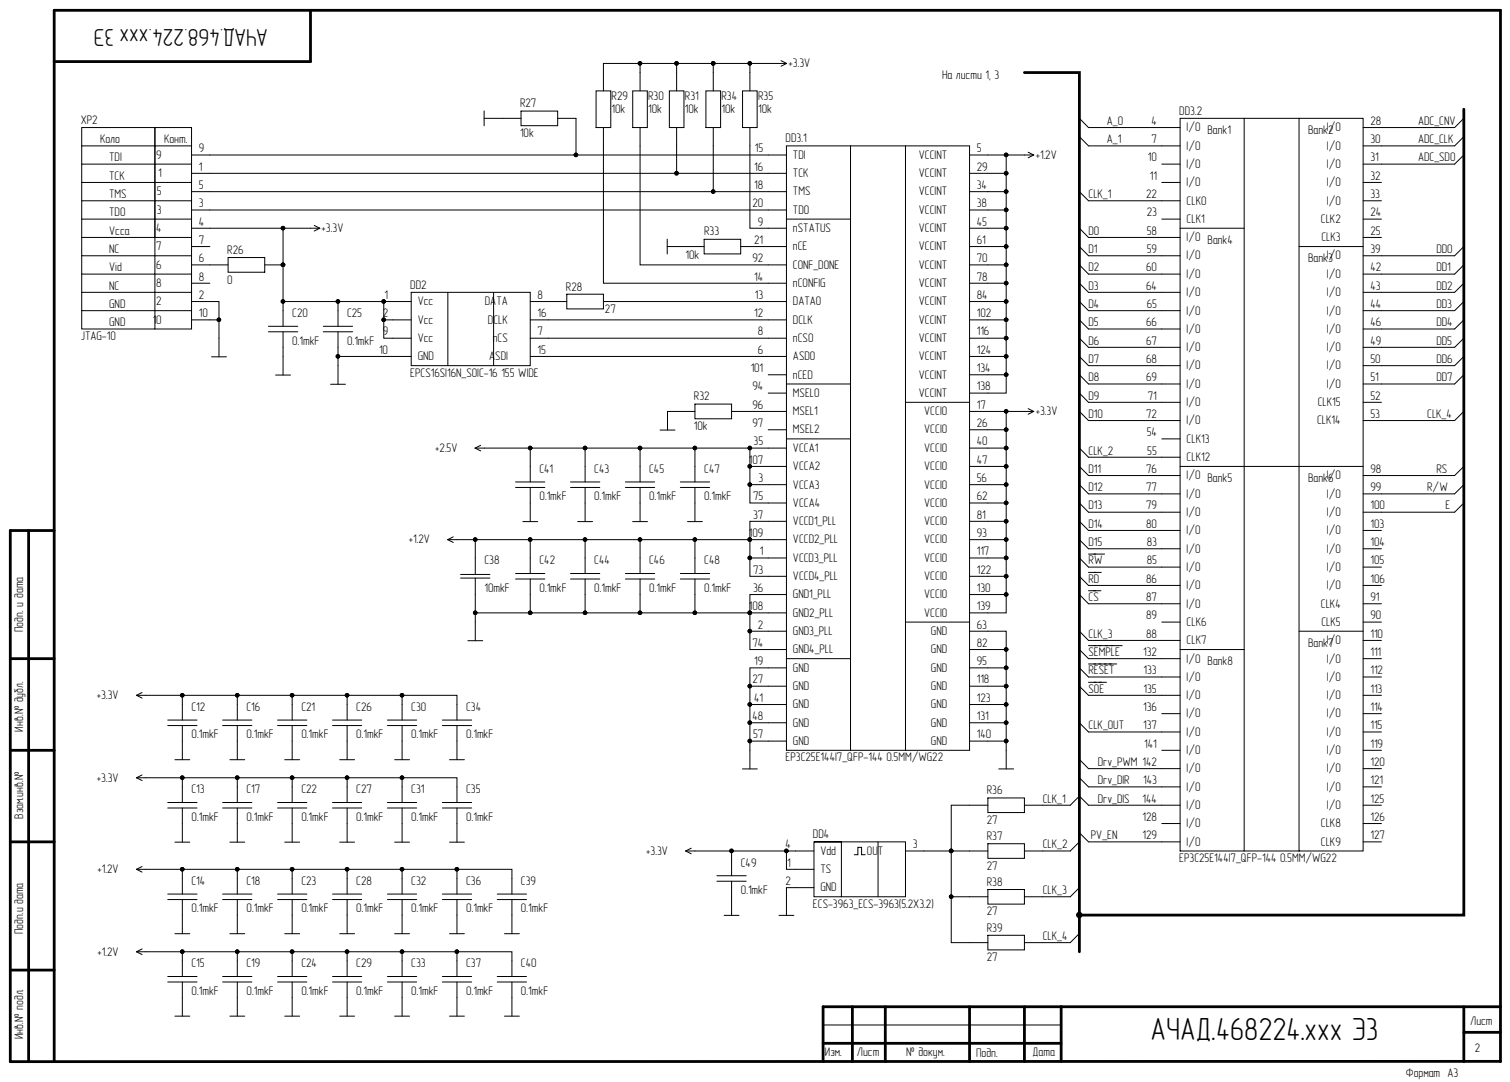
[picture p42: page 4]

TCK | 1
TMS | 5
TD0 | 3

NC | 7
Vid | 6
NC | 8

Инв.№ подл. Подп.и дата Взам.инв.№ Инв.№ дубл.

АЧАД .468224.ххх Э

Изм . | Лист | № докум . | Подп . | Дата

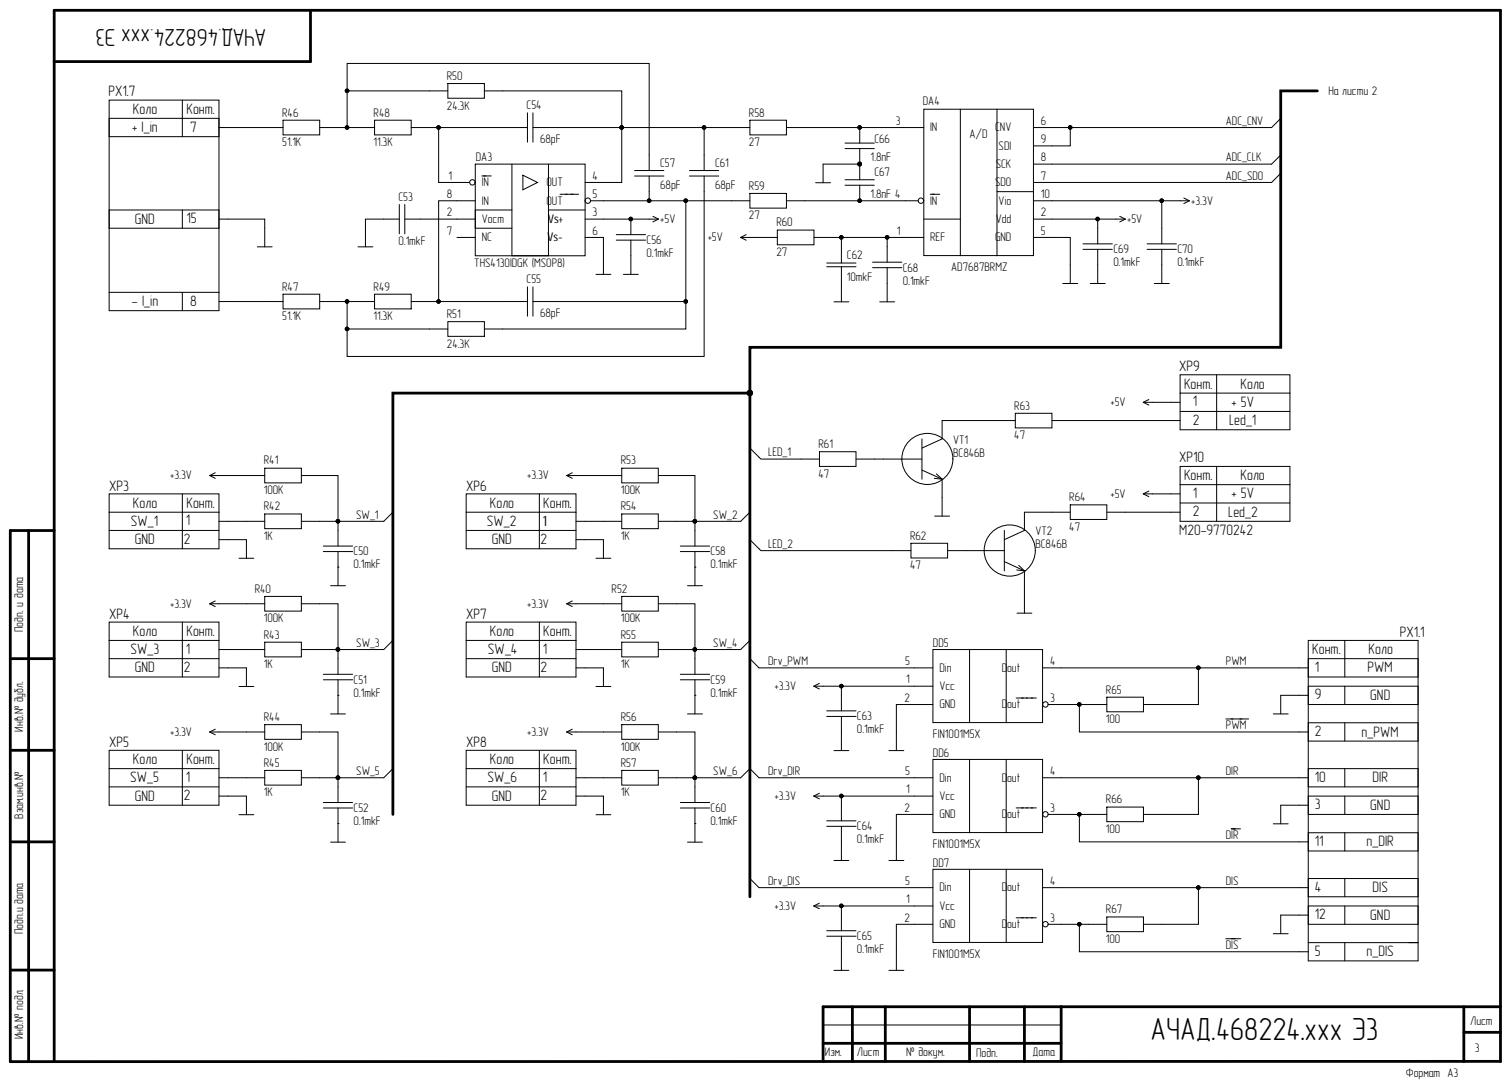
[picture p43: page 5]

Коло | Конт.
+ I_in | 7

Инв.№ подл. Подп.и дата Взам.инв.№ Инв.№ дубл.

9 | GND

PWM

3 | GND

DIR

Dout | 4 Din 5

12 | GND

DIS

5 | n_DIS

АЧАД.468224.ххх Э3

Изм. | Лист | № докум. | Подп. | Дата

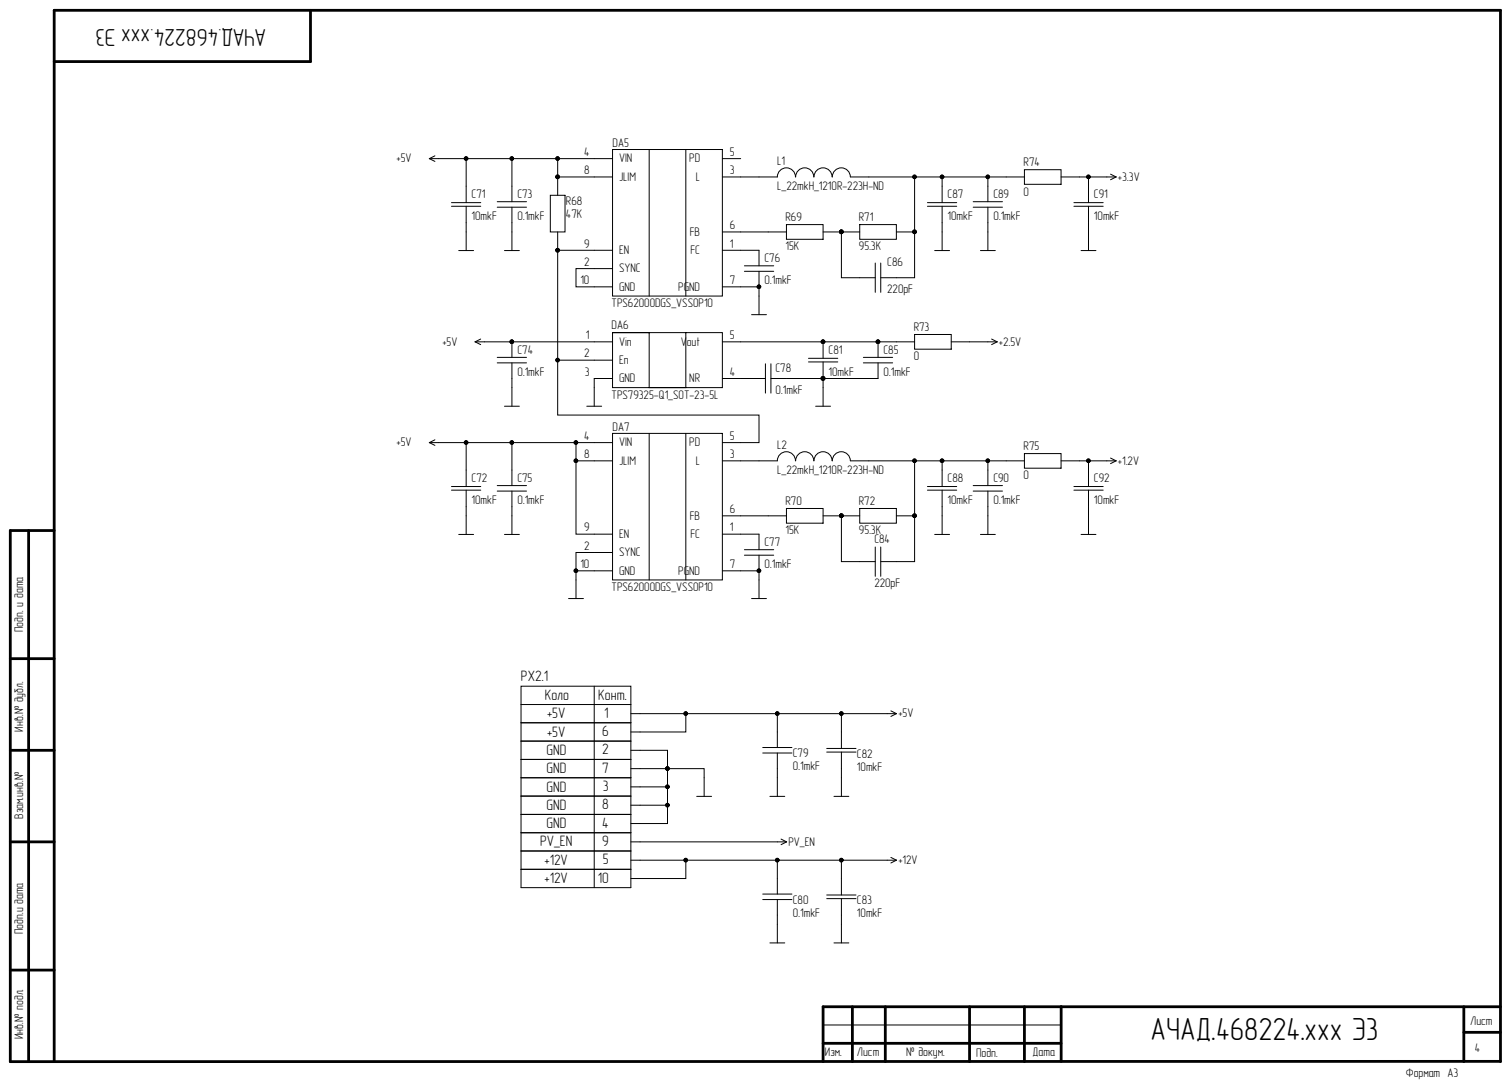
[picture p44: page 6]

Инв.№ подл. Подп.и дата Взам.инв.№ Инв.№ дубл.

Коло | Конт.
+5V | 1
+5V | 6
GND | 2
GND | 7
GND | 3
GND | 8
GND | 4

+12V | 5
+12V | 10

АЧАД.468224.ххх Э3

Изм. | Лист | № докум. | Подп. | Дата

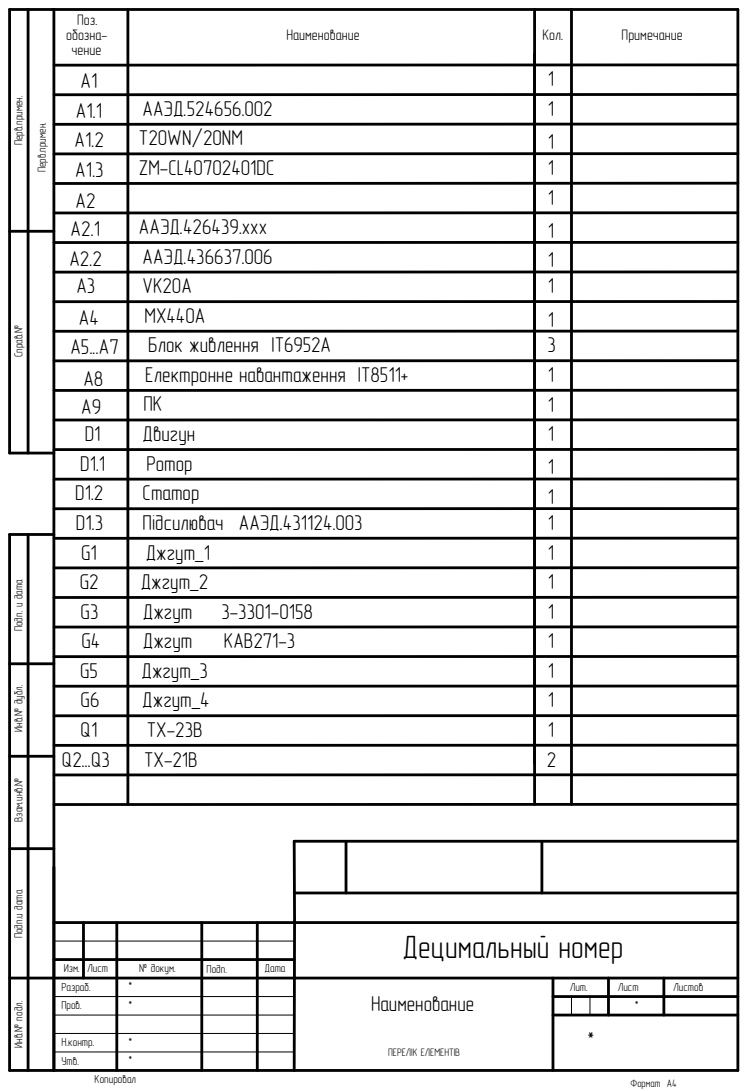
[picture p45: page 7]

Поз. обозна-чение | Наименование | Кол. | Примечание

А1 | | 1
А1.1 | ААЭД.524656.002 | 1
А1.2 | T20WN/20NM | 1
А1.3 | ZM-CL40702401DC | 1
А2 | | 1
А2.1 | ААЭД.426439.ххх | 1
А2.2 | ААЭД.436637.006 | 1
А3 | VK20A | 1
А4 | MX440A | 1
А5...A7 | Блок живлення IT6952A | 3
A8 | Електронне навантаження IT8511+ | 1
A9 | ПК | 1
D1 | Двигун | 1
D1.1 | Ротор | 1
D1.2 | Статор | 1
D1.3 | Підсилювач ААЭД.431124.003 | 1
G1 | Джгут_1 | 1
G2 | Джгут_2 | 1
G3 | Джгут 3-3301-0158 | 1
G4 | Джгут KAB271-3 | 1
G5 | Джгут_3 | 1
G6 | Джгут_4 | 1
Q1 | ТХ-23В | 1
Q2...Q3 | ТХ-21В | 2

Инв.№ подл. Подп.и дата Взам.инв.№ Инв.№ дубл. Справ.№ Перв.примен. Подп. и дата

Децимальный номер

Изм. | Лист | № докум. | Подп. | Дата
Разраб. | * | | Наименование ПЕРЕЛІК ЕЛЕМЕНТІВ | Лит. | Лист | Листов
Пров.
