clasicus/Diplom/ААЭД.521366.002 СБ Двигун.PDF

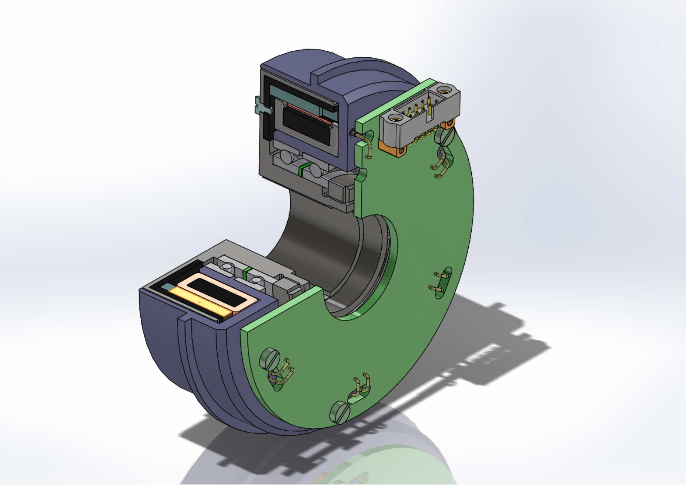
[picture p46: page 1]
