clasicus/Diplom/ДИПЛОМ/ДК41.758826.001 Плата друкована.pdf

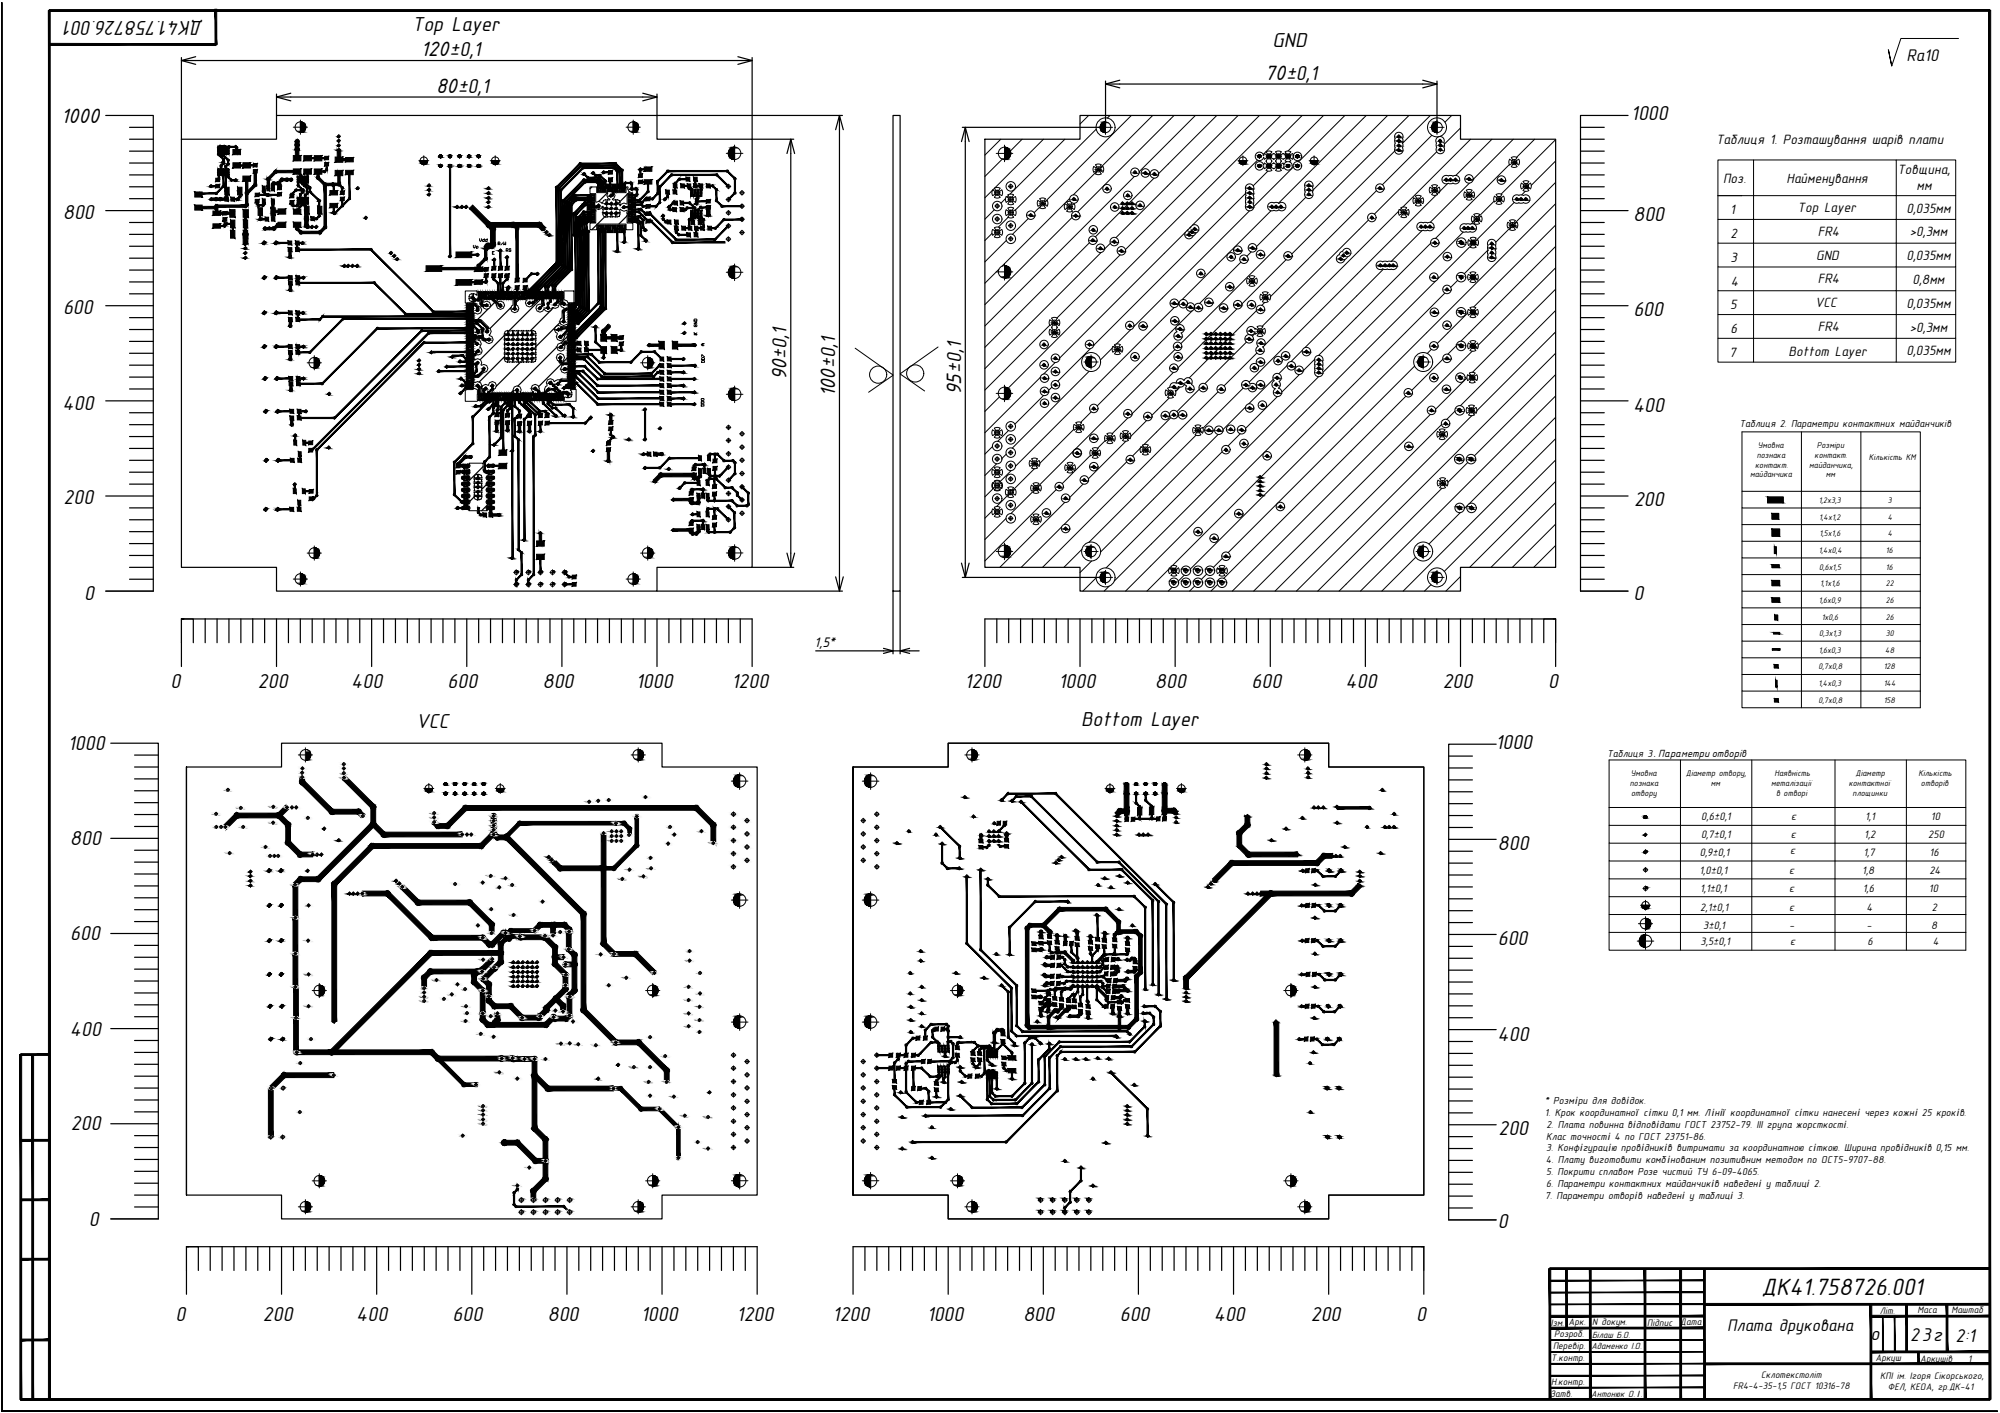
[picture p47: page 1]
Top Layer; GND; VCC; Bottom Layer; Кількість КМ; Діаметр отвору,; в отворі

Таблиця 1. Розташування шарів плати

Таблиця 2. Параметри контактних майданчиків

Таблиця 3 . Параметри отворів

* Розмри для довдок.
1. Крок координатно стки 0,1 мм. Л н координатно стки нанесен через кожн 25 крокв.
2. Плата повинна вдповдати ГОСТ 23752-79. III група жорсткост. Клас точност 4 по ГОСТ 23751-86.

3. Конфгурацю провдникв витримати за координатною сткою. Ширина провдникв 0,15 мм.
4. Плату виготовити комб нованим позитивним методом по ОСТ5-9707-88.
5. Покрити сплавом Розе чистий ТУ 6-09-4065.
6. Параметри контактних майданчикв наведен у таблиц 2.
7. Параметри отворв наведен у таблиц 3.

ДК41.758726.001
Плата друкована | Літ. Маса Маштаб

Ізм. Арк. | N докум. | Підпис | Дата | | о | 2 3 г 2:1
Розроб. | Білаш Б.О.
Перевір. | Адаменко І.О.
Т.контр. | | | | | Аркуш Аркушів 1

Склотекстоліт FR4-4-35-1,5 ГОСТ 10316-78 | КПІ ім. Ігоря Сікорського, ФЕЛ, КЕОА, гр.ДК-41

Н.контр.
Затв. | Антонюк О. І .
