clasicus/Diplom/ДИПЛОМ/Структурка.pdf

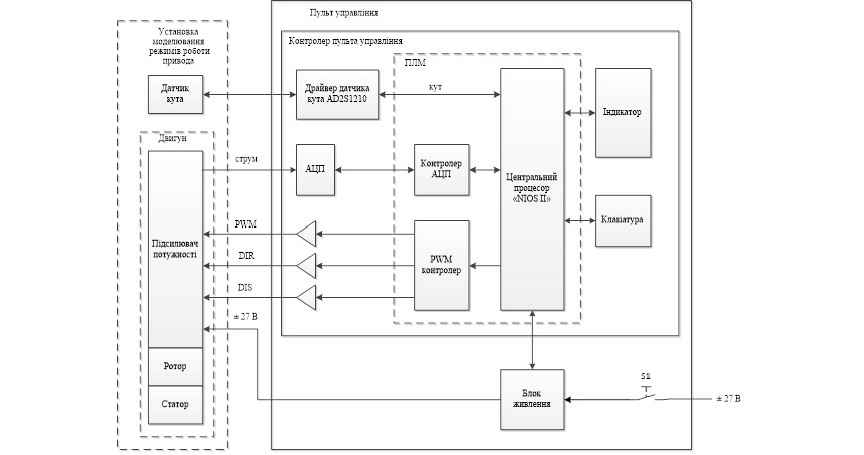
[picture p48: page 1]
