clasicus/Diplom/ДИПЛОМ/ДК41.750706.001 СК Плата. Складальне креслення.pdf

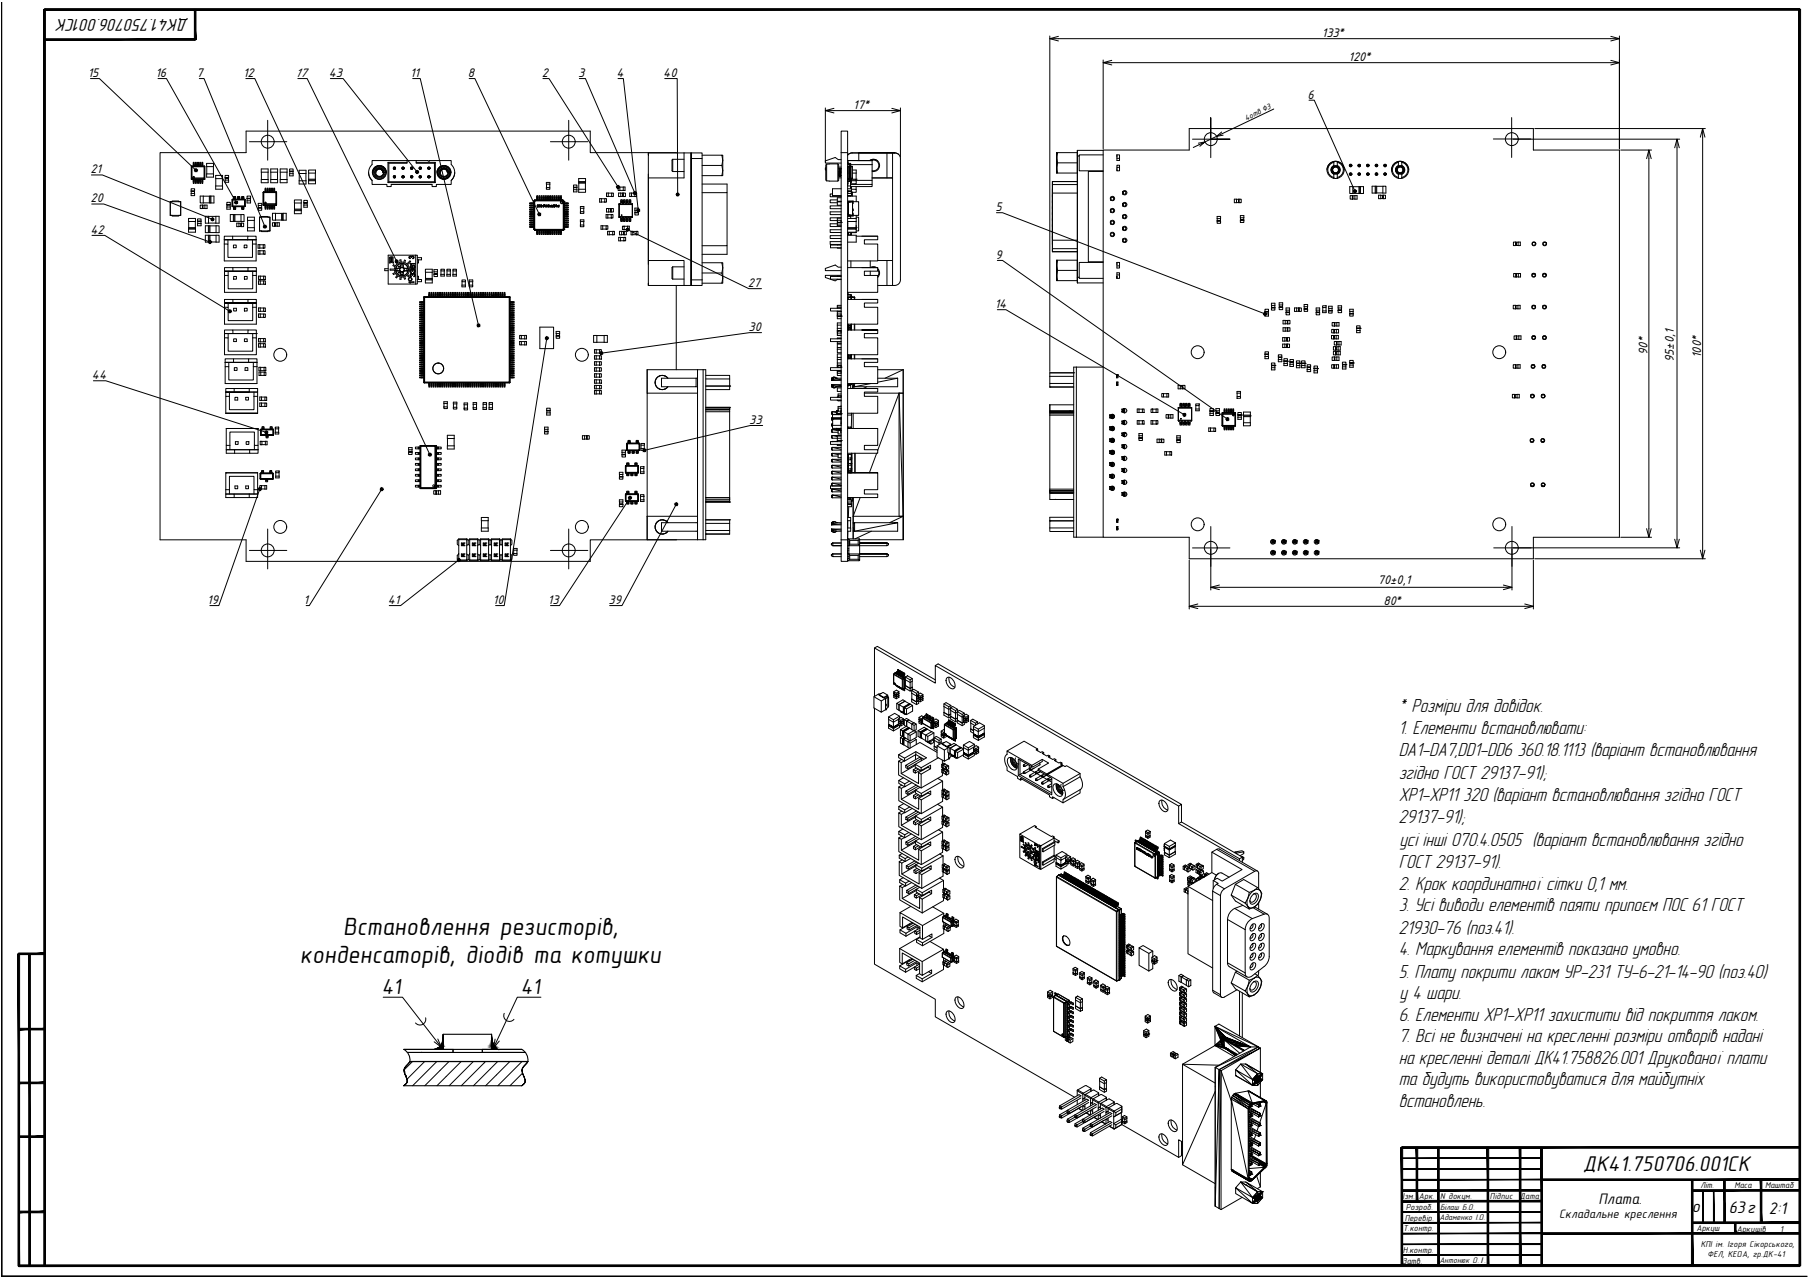
[picture p49: page 1]
4отв ∅3

* Розміри для довідок.
1. Елементи встановлювати:
DA1-DA7,DD1-DD6 360.18.1113 (варіант встановлювання
згідно ГОСТ 29137-91);
XP1-XP11 320 (варіант встановлювання згідно ГОСТ
усі інші 070.4.0505 (варіант встановлювання згідно
ГОСТ 29137-91).
2. Крок координатної сітки 0,1 мм.
3. Усі виводи елементів паяти припоєм ПОС 61 ГОСТ
21930-76 (поз.41).
4. Маркування елементів показано умовно.
5. Плату покрити лаком УР-231 ТУ-6-21-14-90 (поз.40)
у 4 шари.
6. Елементи XP1-XP11 захистити від покриття лаком.
7. Всі не визначені на кресленні розміри отворів надані
на кресленні деталі ДК41.758826.001 Друкованої плати
та будуть використовуватися для майбутніх
встановлень.

Встановлення резисторів,
конденсаторів, діодів та котушки

ДК41.750706.001СК
Плата. Складальне креслення | Літ. Маса Маштаб

Ізм. Арк. | N докум. | Підпис | Дата | | о | 63 г 2:1
Розроб. | Білаш Б.О.
Перевір. | Адаменко І.О.
Т.контр. | | | | | Аркуш Аркушів 1

КПІ ім. Ігоря Сікорського, ФЕЛ, КЕОА, гр.ДК-41

Н.контр.
Затв. | Антонюк О. І .
