clasicus/Diplom/ДИПЛОМ/Altium/Документация/M80-510.pdf

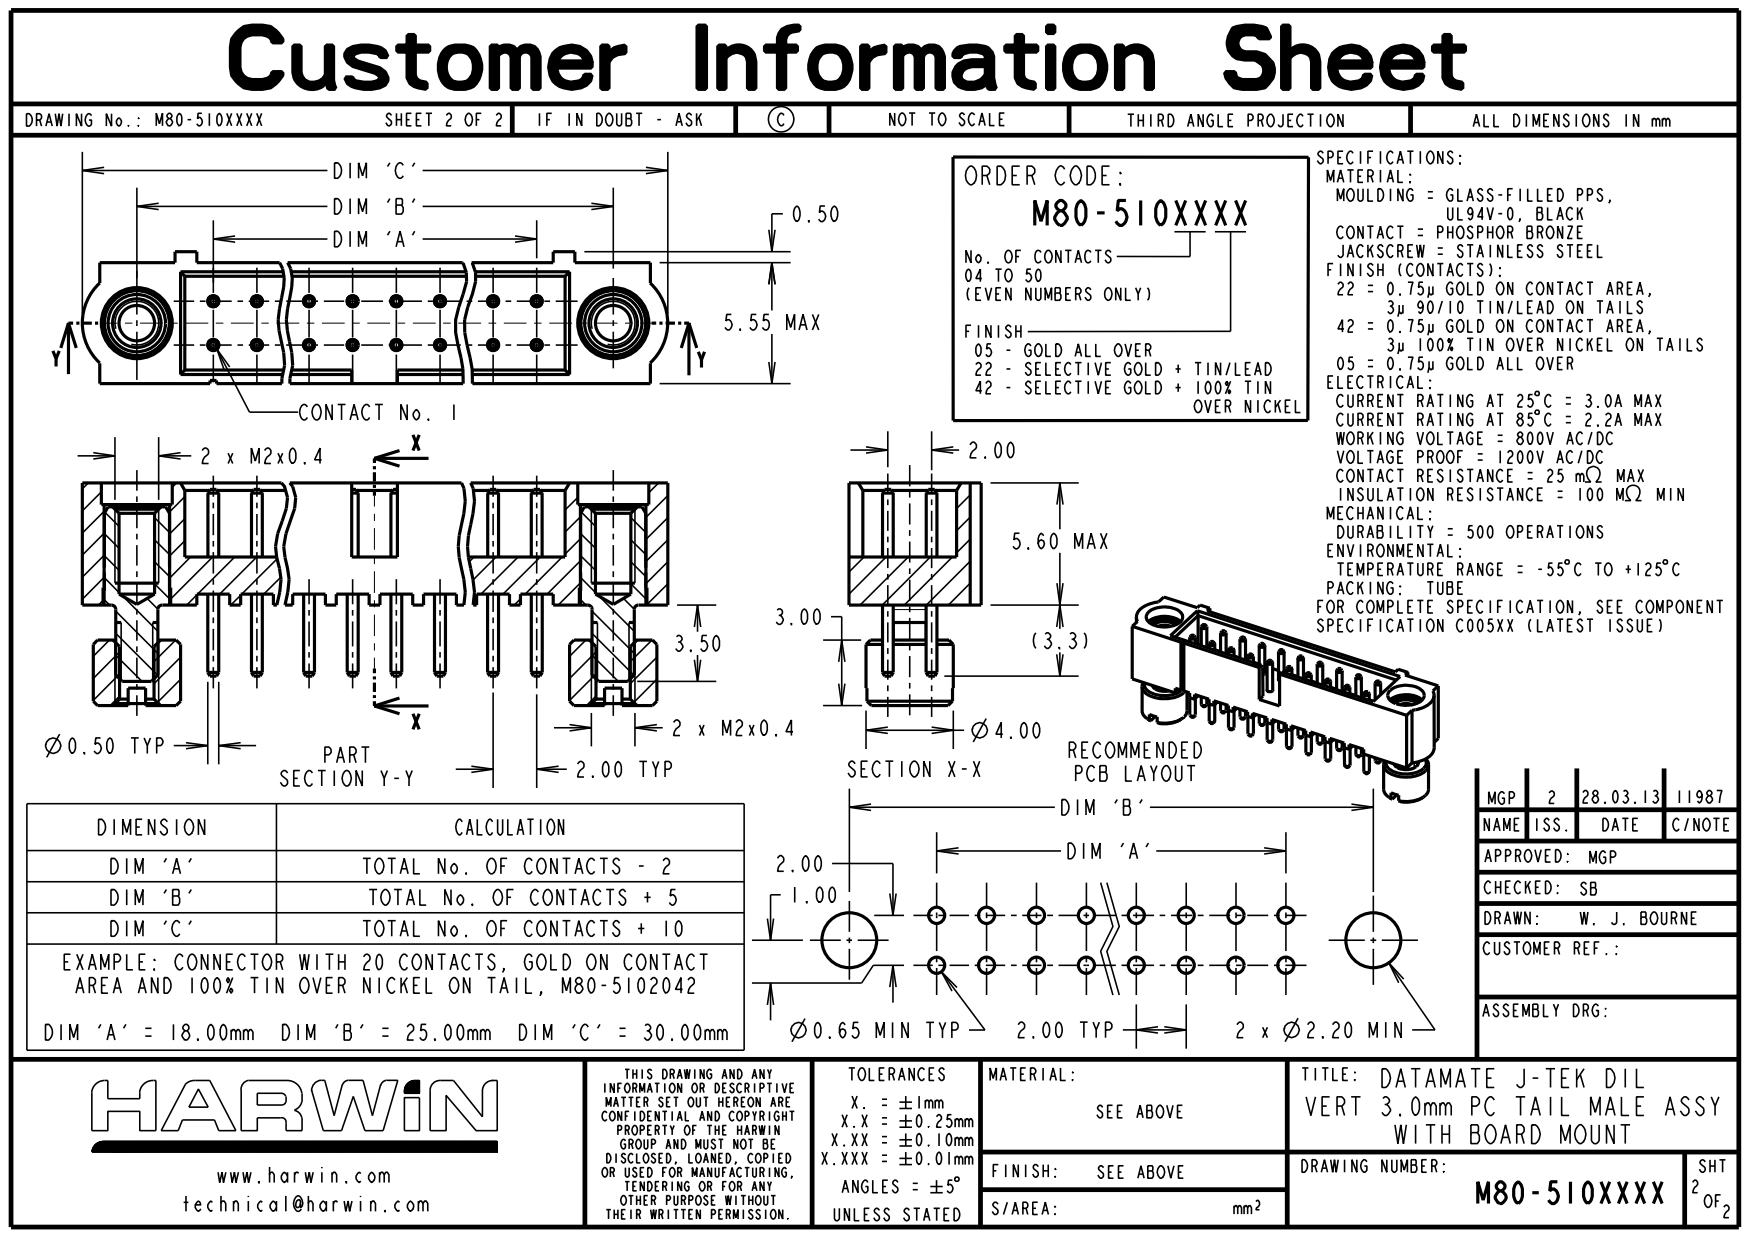
[picture p50: page 1]
