clasicus/Diplom/ДИПЛОМ/Altium/Документация/Папка/АЧАД.524656.003АСК_2/АЧАД.524656.003_Э3.pdf

Нач. сектора Перв.примен.

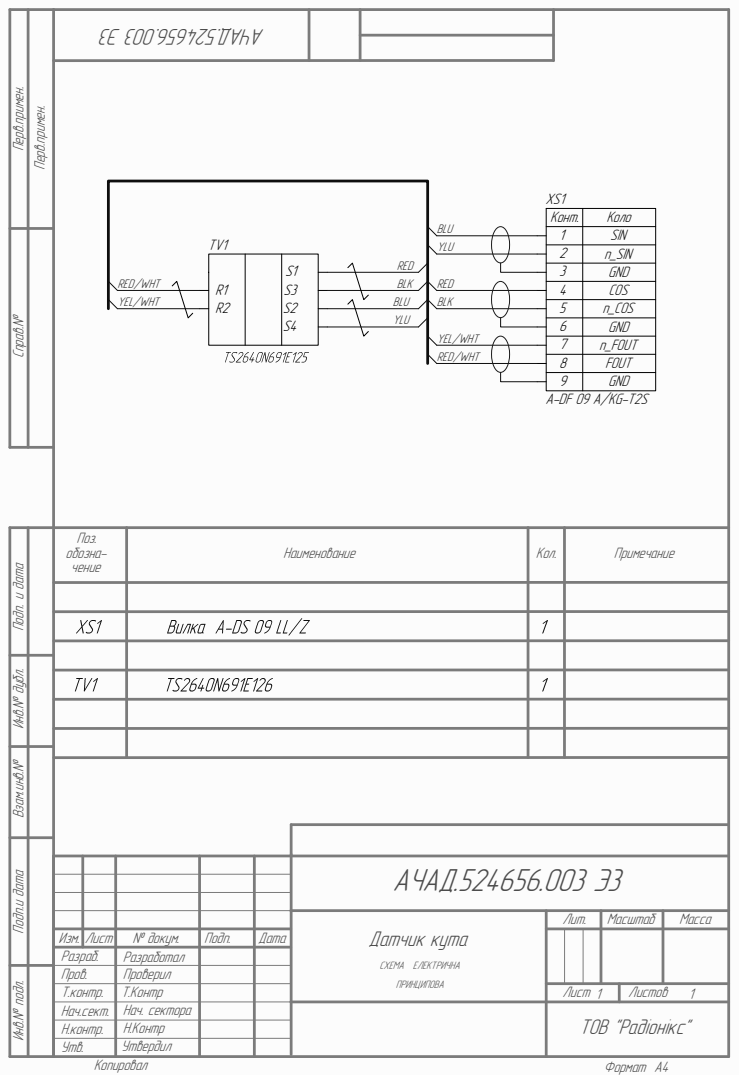
[picture p51: page 1]
Лист Инв.№ подл. Подп.и дата Взам.инв.№ Инв.№ дубл. Справ.№ Перв.примен.; Лит.; Масштаб Подп. и дата; Формат A4; Копировал; Конт.; Коло; SIN n_SIN; COS n_COS; n_FOUT; GND; FOUT; YEL/WHT; RED/WHT; RED BLK BLU YLU; Поз.; обозна-; Наименование; чение; Кол.; Примечание; BLU YLU; RED BLK

АЧАД.524656.003 Э3

Датчик кута СХЕМА ЕЛЕКТРИЧНА ПРИНЦИПОВА | | Масса

Изм. | Лист | № докум. | Подп. | Дата
Разраб. | | Разработал
Пров. | Проверил
Т.контр. | Т.Контр | | | | 1 | Листов 1
Нач.сект. | | | | | ТОВ "Радіонікс"
Н.контр. | Н.Контр
Утв. | Утвердил
