clasicus/Diplom/ДИПЛОМ/Altium/Документация/Папка/АЧАД.524656.003АСК_2/АЧАД.642319.ххх_Э3.pdf

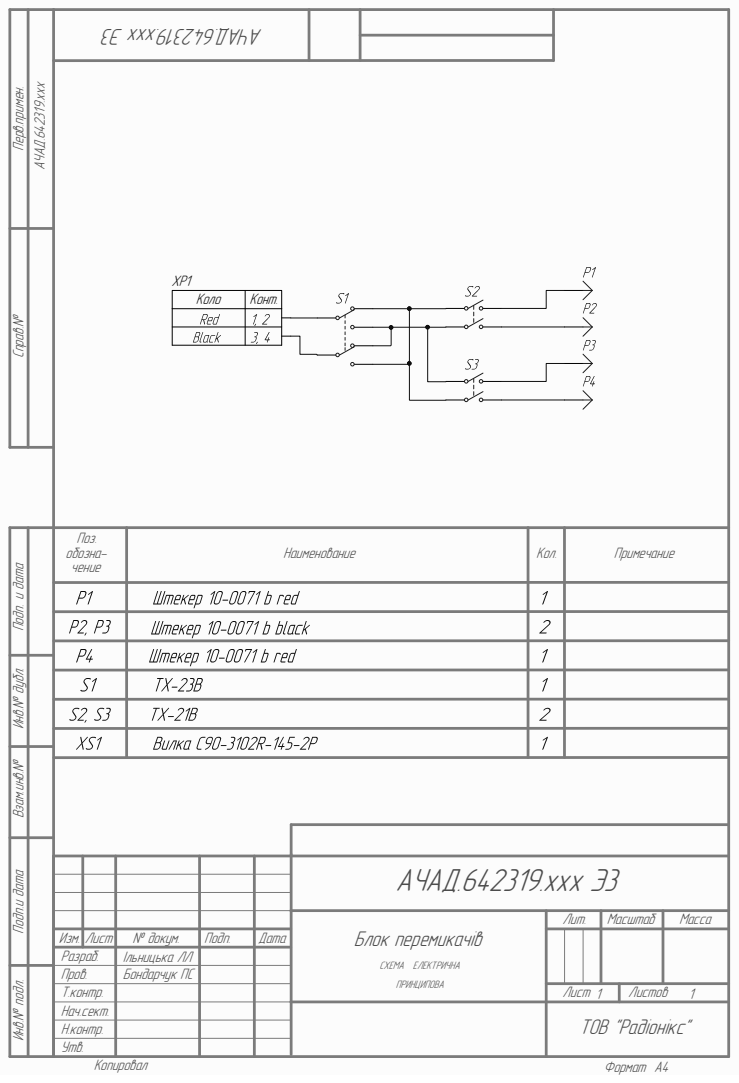
[picture p52: page 1]
Лист Инв.№ подл. Подп.и дата Взам.инв.№ Инв.№ дубл. Справ.№ Перв.примен.; Лит.; Масштаб Подп. и дата; Формат A4; 1 АЧАД.6423¹9.ххх; Копировал; Коло; Конт.; Поз.; обозна-; Наименование; чение; Кол.; Примечание

АЧАД.642319.ххх Э3

Блок перемикачів СХЕМА ЕЛЕКТРИЧНА ПРИНЦИПОВА | | Масса

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
