clasicus/Diplom/(list of files, drawings)

Other design files:
ДИПЛОМ/Altium/Sheet1.SchDoc
ДИПЛОМ/Altium/АСК_2.PrjPcb
ДИПЛОМ/Altium/АСК_2.SCHLIB
ДИПЛОМ/Altium/Документация/Папка/АСК_2/ACK_2_Sheet6.SchDoc
ДИПЛОМ/Altium/Документация/Папка/АСК_2/ACR_2_Sheet7.SchDoc
ДИПЛОМ/Altium/Документация/Папка/АСК_2/Sheet1.SchDoc
ДИПЛОМ/Altium/Документация/Папка/АСК_2/Sheet2.SchDoc
ДИПЛОМ/Altium/Документация/Папка/АСК_2/Sheet3.SchDoc
ДИПЛОМ/Altium/Документация/Папка/АСК_2/Sheet4.SchDoc
ДИПЛОМ/Altium/Документация/Папка/АСК_2/Sheet5.SchDoc
ДИПЛОМ/Altium/Документация/Папка/АСК_2/АСК_2.PrjPcb
ДИПЛОМ/Altium/Документация/Папка/АСК_2/АСК_2_1.SCHLIB
ДИПЛОМ/Altium/Документация/Папка/АЧАД.524656.003АСК_2/АЧАД.52хххх.ххх.SchDoc
ДИПЛОМ/Altium/Документация/Папка/АЧАД.524656.003АСК_2/АЧАД.524656.003.PrjPCB
ДИПЛОМ/Altium/Документация/Папка/АЧАД.524656.003АСК_2/АЧАД.524656.003_Э3.SchDoc
ДИПЛОМ/Altium/Документация/Папка/АЧАД.524656.003АСК_2/АЧАД.642319.ххх_Э3.SchDoc
