clasicus/Diplom/Controller_ASK2/Nios_cpu/cpu_ASK2/synthesis/submodules/cpu_ASK2_addr_router_001.sv

// (C) 2001-2013 Altera Corporation. All rights reserved.
// Your use of Altera Corporation's design tools, logic functions and other 
// software and tools, and its AMPP partner logic functions, and any output 
// files any of the foregoing (including device programming or simulation 
// files), and any associated documentation or information are expressly subject 
// to the terms and conditions of the Altera Program License Subscription 
// Agreement, Altera MegaCore Function License Agreement, or other applicable 
// license agreement, including, without limitation, that your use is for the 
// sole purpose of programming logic devices manufactured by Altera and sold by 
// Altera or its authorized distributors.  Please refer to the applicable 
// agreement for further details.


// (C) 2001-2013 Altera Corporation. All rights reserved.
// Your use of Altera Corporation's design tools, logic functions and other 
// software and tools, and its AMPP partner logic functions, and any output 
// files any of the foregoing (including device programming or simulation 
// files), and any associated documentation or information are expressly subject 
// to the terms and conditions of the Altera Program License Subscription 
// Agreement, Altera MegaCore Function License Agreement, or other applicable 
// license agreement, including, without limitation, that your use is for the 
// sole purpose of programming logic devices manufactured by Altera and sold by 
// Altera or its authorized distributors.  Please refer to the applicable 
// agreement for further details.


// $Id: //acds/rel/13.0/ip/merlin/altera_merlin_router/altera_merlin_router.sv.terp#1 $
// $Revision: #1 $
// $Date: 2013/02/11 $
// $Author: swbranch $

// -------------------------------------------------------
// Merlin Router
//
// Asserts the appropriate one-hot encoded channel based on 
// either (a) the address or (b) the dest id. The DECODER_TYPE
// parameter controls this behaviour. 0 means address decoder,
// 1 means dest id decoder.
//
// In the case of (a), it also sets the destination id.
// -------------------------------------------------------

`timescale 1 ns / 1 ns

module cpu_ASK2_addr_router_001_default_decode
  #(
     parameter DEFAULT_CHANNEL = 1,
               DEFAULT_WR_CHANNEL = -1,
               DEFAULT_RD_CHANNEL = -1,
               DEFAULT_DESTID = 2 
   )
  (output [81 - 77 : 0] default_destination_id,
   output [18-1 : 0] default_wr_channel,
   output [18-1 : 0] default_rd_channel,
   output [18-1 : 0] default_src_channel
  );

  assign default_destination_id = 
    DEFAULT_DESTID[81 - 77 : 0];

  generate begin : default_decode
    if (DEFAULT_CHANNEL == -1) begin
      assign default_src_channel = '0;
    end
    else begin
      assign default_src_channel = 18'b1 << DEFAULT_CHANNEL;
    end
  end
  endgenerate

  generate begin : default_decode_rw
    if (DEFAULT_RD_CHANNEL == -1) begin
      assign default_wr_channel = '0;
      assign default_rd_channel = '0;
    end
    else begin
      assign default_wr_channel = 18'b1 << DEFAULT_WR_CHANNEL;
      assign default_rd_channel = 18'b1 << DEFAULT_RD_CHANNEL;
    end
  end
  endgenerate

endmodule


module cpu_ASK2_addr_router_001
(
    // -------------------
    // Clock & Reset
    // -------------------
    input clk,
    input reset,

    // -------------------
    // Command Sink (Input)
    // -------------------
    input                       sink_valid,
    input  [92-1 : 0]    sink_data,
    input                       sink_startofpacket,
    input                       sink_endofpacket,
    output                      sink_ready,

    // -------------------
    // Command Source (Output)
    // -------------------
    output                          src_valid,
    output reg [92-1    : 0] src_data,
    output reg [18-1 : 0] src_channel,
    output                          src_startofpacket,
    output                          src_endofpacket,
    input                           src_ready
);

    // -------------------------------------------------------
    // Local parameters and variables
    // -------------------------------------------------------
    localparam PKT_ADDR_H = 50;
    localparam PKT_ADDR_L = 36;
    localparam PKT_DEST_ID_H = 81;
    localparam PKT_DEST_ID_L = 77;
    localparam PKT_PROTECTION_H = 85;
    localparam PKT_PROTECTION_L = 83;
    localparam ST_DATA_W = 92;
    localparam ST_CHANNEL_W = 18;
    localparam DECODER_TYPE = 0;

    localparam PKT_TRANS_WRITE = 53;
    localparam PKT_TRANS_READ  = 54;

    localparam PKT_ADDR_W = PKT_ADDR_H-PKT_ADDR_L + 1;
    localparam PKT_DEST_ID_W = PKT_DEST_ID_H-PKT_DEST_ID_L + 1;



    // -------------------------------------------------------
    // Figure out the number of bits to mask off for each slave span
    // during address decoding
    // -------------------------------------------------------
    localparam PAD0 = log2ceil(64'h4000 - 64'h2000); 
    localparam PAD1 = log2ceil(64'h5000 - 64'h4800); 
    localparam PAD2 = log2ceil(64'h5010 - 64'h5000); 
    localparam PAD3 = log2ceil(64'h5020 - 64'h5010); 
    localparam PAD4 = log2ceil(64'h5030 - 64'h5020); 
    localparam PAD5 = log2ceil(64'h5040 - 64'h5030); 
    localparam PAD6 = log2ceil(64'h5050 - 64'h5040); 
    localparam PAD7 = log2ceil(64'h5060 - 64'h5050); 
    localparam PAD8 = log2ceil(64'h5070 - 64'h5060); 
    localparam PAD9 = log2ceil(64'h5080 - 64'h5070); 
    localparam PAD10 = log2ceil(64'h5090 - 64'h5080); 
    localparam PAD11 = log2ceil(64'h50a0 - 64'h5090); 
    localparam PAD12 = log2ceil(64'h50b0 - 64'h50a0); 
    localparam PAD13 = log2ceil(64'h50c0 - 64'h50b0); 
    localparam PAD14 = log2ceil(64'h50d0 - 64'h50c0); 
    localparam PAD15 = log2ceil(64'h50e0 - 64'h50d0); 
    localparam PAD16 = log2ceil(64'h50e8 - 64'h50e0); 
    localparam PAD17 = log2ceil(64'h50f0 - 64'h50e8); 
    // -------------------------------------------------------
    // Work out which address bits are significant based on the
    // address range of the slaves. If the required width is too
    // large or too small, we use the address field width instead.
    // -------------------------------------------------------
    localparam ADDR_RANGE = 64'h50f0;
    localparam RANGE_ADDR_WIDTH = log2ceil(ADDR_RANGE);
    localparam OPTIMIZED_ADDR_H = (RANGE_ADDR_WIDTH > PKT_ADDR_W) ||
                                  (RANGE_ADDR_WIDTH == 0) ?
                                        PKT_ADDR_H :
                                        PKT_ADDR_L + RANGE_ADDR_WIDTH - 1;

    localparam RG = RANGE_ADDR_WIDTH-1;

      wire [PKT_ADDR_W-1 : 0] address = sink_data[OPTIMIZED_ADDR_H : PKT_ADDR_L];

    // -------------------------------------------------------
    // Pass almost everything through, untouched
    // -------------------------------------------------------
    assign sink_ready        = src_ready;
    assign src_valid         = sink_valid;
    assign src_startofpacket = sink_startofpacket;
    assign src_endofpacket   = sink_endofpacket;

    wire [PKT_DEST_ID_W-1:0] default_destid;
    wire [18-1 : 0] default_src_channel;





    cpu_ASK2_addr_router_001_default_decode the_default_decode(
      .default_destination_id (default_destid),
      .default_wr_channel   (),
      .default_rd_channel   (),
      .default_src_channel  (default_src_channel)
    );

    always @* begin
        src_data    = sink_data;
        src_channel = default_src_channel;
        src_data[PKT_DEST_ID_H:PKT_DEST_ID_L] = default_destid;

        // --------------------------------------------------
        // Address Decoder
        // Sets the channel and destination ID based on the address
        // --------------------------------------------------

    // ( 0x2000 .. 0x4000 )
    if ( {address[RG:PAD0],{PAD0{1'b0}}} == 15'h2000   ) begin
            src_channel = 18'b000000000000000010;
            src_data[PKT_DEST_ID_H:PKT_DEST_ID_L] = 2;
    end

    // ( 0x4800 .. 0x5000 )
    if ( {address[RG:PAD1],{PAD1{1'b0}}} == 15'h4800   ) begin
            src_channel = 18'b000000000000000001;
            src_data[PKT_DEST_ID_H:PKT_DEST_ID_L] = 1;
    end

    // ( 0x5000 .. 0x5010 )
    if ( {address[RG:PAD2],{PAD2{1'b0}}} == 15'h5000   ) begin
            src_channel = 18'b100000000000000000;
            src_data[PKT_DEST_ID_H:PKT_DEST_ID_L] = 5;
    end

    // ( 0x5010 .. 0x5020 )
    if ( {address[RG:PAD3],{PAD3{1'b0}}} == 15'h5010   ) begin
            src_channel = 18'b010000000000000000;
            src_data[PKT_DEST_ID_H:PKT_DEST_ID_L] = 6;
    end

    // ( 0x5020 .. 0x5030 )
    if ( {address[RG:PAD4],{PAD4{1'b0}}} == 15'h5020   ) begin
            src_channel = 18'b001000000000000000;
            src_data[PKT_DEST_ID_H:PKT_DEST_ID_L] = 4;
    end

    // ( 0x5030 .. 0x5040 )
    if ( {address[RG:PAD5],{PAD5{1'b0}}} == 15'h5030   ) begin
            src_channel = 18'b000100000000000000;
            src_data[PKT_DEST_ID_H:PKT_DEST_ID_L] = 7;
    end

    // ( 0x5040 .. 0x5050 )
    if ( {address[RG:PAD6],{PAD6{1'b0}}} == 15'h5040   ) begin
            src_channel = 18'b000010000000000000;
            src_data[PKT_DEST_ID_H:PKT_DEST_ID_L] = 9;
    end

    // ( 0x5050 .. 0x5060 )
    if ( {address[RG:PAD7],{PAD7{1'b0}}} == 15'h5050   ) begin
            src_channel = 18'b000001000000000000;
            src_data[PKT_DEST_ID_H:PKT_DEST_ID_L] = 3;
    end

    // ( 0x5060 .. 0x5070 )
    if ( {address[RG:PAD8],{PAD8{1'b0}}} == 15'h5060   ) begin
            src_channel = 18'b000000100000000000;
            src_data[PKT_DEST_ID_H:PKT_DEST_ID_L] = 12;
    end

    // ( 0x5070 .. 0x5080 )
    if ( {address[RG:PAD9],{PAD9{1'b0}}} == 15'h5070   ) begin
            src_channel = 18'b000000010000000000;
            src_data[PKT_DEST_ID_H:PKT_DEST_ID_L] = 14;
    end

    // ( 0x5080 .. 0x5090 )
    if ( {address[RG:PAD10],{PAD10{1'b0}}} == 15'h5080   ) begin
            src_channel = 18'b000000001000000000;
            src_data[PKT_DEST_ID_H:PKT_DEST_ID_L] = 15;
    end

    // ( 0x5090 .. 0x50a0 )
    if ( {address[RG:PAD11],{PAD11{1'b0}}} == 15'h5090   ) begin
            src_channel = 18'b000000000100000000;
            src_data[PKT_DEST_ID_H:PKT_DEST_ID_L] = 13;
    end

    // ( 0x50a0 .. 0x50b0 )
    if ( {address[RG:PAD12],{PAD12{1'b0}}} == 15'h50a0   ) begin
            src_channel = 18'b000000000010000000;
            src_data[PKT_DEST_ID_H:PKT_DEST_ID_L] = 16;
    end

    // ( 0x50b0 .. 0x50c0 )
    if ( {address[RG:PAD13],{PAD13{1'b0}}} == 15'h50b0   ) begin
            src_channel = 18'b000000000001000000;
            src_data[PKT_DEST_ID_H:PKT_DEST_ID_L] = 10;
    end

    // ( 0x50c0 .. 0x50d0 )
    if ( {address[RG:PAD14],{PAD14{1'b0}}} == 15'h50c0   ) begin
            src_channel = 18'b000000000000100000;
            src_data[PKT_DEST_ID_H:PKT_DEST_ID_L] = 11;
    end

    // ( 0x50d0 .. 0x50e0 )
    if ( {address[RG:PAD15],{PAD15{1'b0}}} == 15'h50d0   ) begin
            src_channel = 18'b000000000000010000;
            src_data[PKT_DEST_ID_H:PKT_DEST_ID_L] = 8;
    end

    // ( 0x50e0 .. 0x50e8 )
    if ( {address[RG:PAD16],{PAD16{1'b0}}} == 15'h50e0   ) begin
            src_channel = 18'b000000000000001000;
            src_data[PKT_DEST_ID_H:PKT_DEST_ID_L] = 17;
    end

    // ( 0x50e8 .. 0x50f0 )
    if ( {address[RG:PAD17],{PAD17{1'b0}}} == 15'h50e8   ) begin
            src_channel = 18'b000000000000000100;
            src_data[PKT_DEST_ID_H:PKT_DEST_ID_L] = 0;
    end

end


    // --------------------------------------------------
    // Ceil(log2()) function
    // --------------------------------------------------
    function integer log2ceil;
        input reg[65:0] val;
        reg [65:0] i;

        begin
            i = 1;
            log2ceil = 0;

            while (i < val) begin
                log2ceil = log2ceil + 1;
                i = i << 1;
            end
        end
    endfunction

endmodule
