clasicus/Diplom/Controller_ASK2/db/ip/Cpu_0/Cpu_0.v

// Cpu_0.v

// Generated using ACDS version 13.0 156 at 2018.04.20.15:43:17

`timescale 1 ps / 1 ps
module Cpu_0 (
		input  wire        clk_clk,                                 //                              clk.clk
		input  wire        reset_reset_n,                           //                            reset.reset_n
		input  wire [15:0] pio_angle_external_connection_export,    //    pio_angle_external_connection.export
		output wire [7:0]  pio_lcd_data_external_connection_export, // pio_lcd_data_external_connection.export
		output wire [2:0]  pio_control_external_connection_export   //  pio_control_external_connection.export
	);

	wire         nios2_cpu_instruction_master_waitrequest;                                                           // nios2_cpu_instruction_master_translator:av_waitrequest -> nios2_cpu:i_waitrequest
	wire  [15:0] nios2_cpu_instruction_master_address;                                                               // nios2_cpu:i_address -> nios2_cpu_instruction_master_translator:av_address
	wire         nios2_cpu_instruction_master_read;                                                                  // nios2_cpu:i_read -> nios2_cpu_instruction_master_translator:av_read
	wire  [31:0] nios2_cpu_instruction_master_readdata;                                                              // nios2_cpu_instruction_master_translator:av_readdata -> nios2_cpu:i_readdata
	wire         nios2_cpu_instruction_master_readdatavalid;                                                         // nios2_cpu_instruction_master_translator:av_readdatavalid -> nios2_cpu:i_readdatavalid
	wire         nios2_cpu_data_master_waitrequest;                                                                  // nios2_cpu_data_master_translator:av_waitrequest -> nios2_cpu:d_waitrequest
	wire  [31:0] nios2_cpu_data_master_writedata;                                                                    // nios2_cpu:d_writedata -> nios2_cpu_data_master_translator:av_writedata
	wire  [15:0] nios2_cpu_data_master_address;                                                                      // nios2_cpu:d_address -> nios2_cpu_data_master_translator:av_address
	wire         nios2_cpu_data_master_write;                                                                        // nios2_cpu:d_write -> nios2_cpu_data_master_translator:av_write
	wire         nios2_cpu_data_master_read;                                                                         // nios2_cpu:d_read -> nios2_cpu_data_master_translator:av_read
	wire  [31:0] nios2_cpu_data_master_readdata;                                                                     // nios2_cpu_data_master_translator:av_readdata -> nios2_cpu:d_readdata
	wire         nios2_cpu_data_master_debugaccess;                                                                  // nios2_cpu:jtag_debug_module_debugaccess_to_roms -> nios2_cpu_data_master_translator:av_debugaccess
	wire   [3:0] nios2_cpu_data_master_byteenable;                                                                   // nios2_cpu:d_byteenable -> nios2_cpu_data_master_translator:av_byteenable
	wire         nios2_cpu_jtag_debug_module_translator_avalon_anti_slave_0_waitrequest;                             // nios2_cpu:jtag_debug_module_waitrequest -> nios2_cpu_jtag_debug_module_translator:av_waitrequest
	wire  [31:0] nios2_cpu_jtag_debug_module_translator_avalon_anti_slave_0_writedata;                               // nios2_cpu_jtag_debug_module_translator:av_writedata -> nios2_cpu:jtag_debug_module_writedata
	wire   [8:0] nios2_cpu_jtag_debug_module_translator_avalon_anti_slave_0_address;                                 // nios2_cpu_jtag_debug_module_translator:av_address -> nios2_cpu:jtag_debug_module_address
	wire         nios2_cpu_jtag_debug_module_translator_avalon_anti_slave_0_write;                                   // nios2_cpu_jtag_debug_module_translator:av_write -> nios2_cpu:jtag_debug_module_write
	wire         nios2_cpu_jtag_debug_module_translator_avalon_anti_slave_0_read;                                    // nios2_cpu_jtag_debug_module_translator:av_read -> nios2_cpu:jtag_debug_module_read
	wire  [31:0] nios2_cpu_jtag_debug_module_translator_avalon_anti_slave_0_readdata;                                // nios2_cpu:jtag_debug_module_readdata -> nios2_cpu_jtag_debug_module_translator:av_readdata
	wire         nios2_cpu_jtag_debug_module_translator_avalon_anti_slave_0_debugaccess;                             // nios2_cpu_jtag_debug_module_translator:av_debugaccess -> nios2_cpu:jtag_debug_module_debugaccess
	wire   [3:0] nios2_cpu_jtag_debug_module_translator_avalon_anti_slave_0_byteenable;                              // nios2_cpu_jtag_debug_module_translator:av_byteenable -> nios2_cpu:jtag_debug_module_byteenable
	wire  [31:0] onchip_memory2_0_s1_translator_avalon_anti_slave_0_writedata;                                       // onchip_memory2_0_s1_translator:av_writedata -> onchip_memory2_0:writedata
	wire  [11:0] onchip_memory2_0_s1_translator_avalon_anti_slave_0_address;                                         // onchip_memory2_0_s1_translator:av_address -> onchip_memory2_0:address
	wire         onchip_memory2_0_s1_translator_avalon_anti_slave_0_chipselect;                                      // onchip_memory2_0_s1_translator:av_chipselect -> onchip_memory2_0:chipselect
	wire         onchip_memory2_0_s1_translator_avalon_anti_slave_0_clken;                                           // onchip_memory2_0_s1_translator:av_clken -> onchip_memory2_0:clken
	wire         onchip_memory2_0_s1_translator_avalon_anti_slave_0_write;                                           // onchip_memory2_0_s1_translator:av_write -> onchip_memory2_0:write
	wire  [31:0] onchip_memory2_0_s1_translator_avalon_anti_slave_0_readdata;                                        // onchip_memory2_0:readdata -> onchip_memory2_0_s1_translator:av_readdata
	wire   [3:0] onchip_memory2_0_s1_translator_avalon_anti_slave_0_byteenable;                                      // onchip_memory2_0_s1_translator:av_byteenable -> onchip_memory2_0:byteenable
	wire         jtag_uart_0_avalon_jtag_slave_translator_avalon_anti_slave_0_waitrequest;                           // jtag_uart_0:av_waitrequest -> jtag_uart_0_avalon_jtag_slave_translator:av_waitrequest
	wire  [31:0] jtag_uart_0_avalon_jtag_slave_translator_avalon_anti_slave_0_writedata;                             // jtag_uart_0_avalon_jtag_slave_translator:av_writedata -> jtag_uart_0:av_writedata
	wire   [0:0] jtag_uart_0_avalon_jtag_slave_translator_avalon_anti_slave_0_address;                               // jtag_uart_0_avalon_jtag_slave_translator:av_address -> jtag_uart_0:av_address
	wire         jtag_uart_0_avalon_jtag_slave_translator_avalon_anti_slave_0_chipselect;                            // jtag_uart_0_avalon_jtag_slave_translator:av_chipselect -> jtag_uart_0:av_chipselect
	wire         jtag_uart_0_avalon_jtag_slave_translator_avalon_anti_slave_0_write;                                 // jtag_uart_0_avalon_jtag_slave_translator:av_write -> jtag_uart_0:av_write_n
	wire         jtag_uart_0_avalon_jtag_slave_translator_avalon_anti_slave_0_read;                                  // jtag_uart_0_avalon_jtag_slave_translator:av_read -> jtag_uart_0:av_read_n
	wire  [31:0] jtag_uart_0_avalon_jtag_slave_translator_avalon_anti_slave_0_readdata;                              // jtag_uart_0:av_readdata -> jtag_uart_0_avalon_jtag_slave_translator:av_readdata
	wire   [1:0] pio_angle_s1_translator_avalon_anti_slave_0_address;                                                // pio_angle_s1_translator:av_address -> pio_angle:address
	wire  [31:0] pio_angle_s1_translator_avalon_anti_slave_0_readdata;                                               // pio_angle:readdata -> pio_angle_s1_translator:av_readdata
	wire  [31:0] pio_lcd_data_s1_translator_avalon_anti_slave_0_writedata;                                           // pio_lcd_data_s1_translator:av_writedata -> pio_lcd_data:writedata
	wire   [1:0] pio_lcd_data_s1_translator_avalon_anti_slave_0_address;                                             // pio_lcd_data_s1_translator:av_address -> pio_lcd_data:address
	wire         pio_lcd_data_s1_translator_avalon_anti_slave_0_chipselect;                                          // pio_lcd_data_s1_translator:av_chipselect -> pio_lcd_data:chipselect
	wire         pio_lcd_data_s1_translator_avalon_anti_slave_0_write;                                               // pio_lcd_data_s1_translator:av_write -> pio_lcd_data:write_n
	wire  [31:0] pio_lcd_data_s1_translator_avalon_anti_slave_0_readdata;                                            // pio_lcd_data:readdata -> pio_lcd_data_s1_translator:av_readdata
	wire  [31:0] pio_control_s1_translator_avalon_anti_slave_0_writedata;                                            // pio_control_s1_translator:av_writedata -> pio_control:writedata
	wire   [1:0] pio_control_s1_translator_avalon_anti_slave_0_address;                                              // pio_control_s1_translator:av_address -> pio_control:address
	wire         pio_control_s1_translator_avalon_anti_slave_0_chipselect;                                           // pio_control_s1_translator:av_chipselect -> pio_control:chipselect
	wire         pio_control_s1_translator_avalon_anti_slave_0_write;                                                // pio_control_s1_translator:av_write -> pio_control:write_n
	wire  [31:0] pio_control_s1_translator_avalon_anti_slave_0_readdata;                                             // pio_control:readdata -> pio_control_s1_translator:av_readdata
	wire         nios2_cpu_instruction_master_translator_avalon_universal_master_0_waitrequest;                      // nios2_cpu_instruction_master_translator_avalon_universal_master_0_agent:av_waitrequest -> nios2_cpu_instruction_master_translator:uav_waitrequest
	wire   [2:0] nios2_cpu_instruction_master_translator_avalon_universal_master_0_burstcount;                       // nios2_cpu_instruction_master_translator:uav_burstcount -> nios2_cpu_instruction_master_translator_avalon_universal_master_0_agent:av_burstcount
	wire  [31:0] nios2_cpu_instruction_master_translator_avalon_universal_master_0_writedata;                        // nios2_cpu_instruction_master_translator:uav_writedata -> nios2_cpu_instruction_master_translator_avalon_universal_master_0_agent:av_writedata
	wire  [15:0] nios2_cpu_instruction_master_translator_avalon_universal_master_0_address;                          // nios2_cpu_instruction_master_translator:uav_address -> nios2_cpu_instruction_master_translator_avalon_universal_master_0_agent:av_address
	wire         nios2_cpu_instruction_master_translator_avalon_universal_master_0_lock;                             // nios2_cpu_instruction_master_translator:uav_lock -> nios2_cpu_instruction_master_translator_avalon_universal_master_0_agent:av_lock
	wire         nios2_cpu_instruction_master_translator_avalon_universal_master_0_write;                            // nios2_cpu_instruction_master_translator:uav_write -> nios2_cpu_instruction_master_translator_avalon_universal_master_0_agent:av_write
	wire         nios2_cpu_instruction_master_translator_avalon_universal_master_0_read;                             // nios2_cpu_instruction_master_translator:uav_read -> nios2_cpu_instruction_master_translator_avalon_universal_master_0_agent:av_read
	wire  [31:0] nios2_cpu_instruction_master_translator_avalon_universal_master_0_readdata;                         // nios2_cpu_instruction_master_translator_avalon_universal_master_0_agent:av_readdata -> nios2_cpu_instruction_master_translator:uav_readdata
	wire         nios2_cpu_instruction_master_translator_avalon_universal_master_0_debugaccess;                      // nios2_cpu_instruction_master_translator:uav_debugaccess -> nios2_cpu_instruction_master_translator_avalon_universal_master_0_agent:av_debugaccess
	wire   [3:0] nios2_cpu_instruction_master_translator_avalon_universal_master_0_byteenable;                       // nios2_cpu_instruction_master_translator:uav_byteenable -> nios2_cpu_instruction_master_translator_avalon_universal_master_0_agent:av_byteenable
	wire         nios2_cpu_instruction_master_translator_avalon_universal_master_0_readdatavalid;                    // nios2_cpu_instruction_master_translator_avalon_universal_master_0_agent:av_readdatavalid -> nios2_cpu_instruction_master_translator:uav_readdatavalid
	wire         nios2_cpu_data_master_translator_avalon_universal_master_0_waitrequest;                             // nios2_cpu_data_master_translator_avalon_universal_master_0_agent:av_waitrequest -> nios2_cpu_data_master_translator:uav_waitrequest
	wire   [2:0] nios2_cpu_data_master_translator_avalon_universal_master_0_burstcount;                              // nios2_cpu_data_master_translator:uav_burstcount -> nios2_cpu_data_master_translator_avalon_universal_master_0_agent:av_burstcount
	wire  [31:0] nios2_cpu_data_master_translator_avalon_universal_master_0_writedata;                               // nios2_cpu_data_master_translator:uav_writedata -> nios2_cpu_data_master_translator_avalon_universal_master_0_agent:av_writedata
	wire  [15:0] nios2_cpu_data_master_translator_avalon_universal_master_0_address;                                 // nios2_cpu_data_master_translator:uav_address -> nios2_cpu_data_master_translator_avalon_universal_master_0_agent:av_address
	wire         nios2_cpu_data_master_translator_avalon_universal_master_0_lock;                                    // nios2_cpu_data_master_translator:uav_lock -> nios2_cpu_data_master_translator_avalon_universal_master_0_agent:av_lock
	wire         nios2_cpu_data_master_translator_avalon_universal_master_0_write;                                   // nios2_cpu_data_master_translator:uav_write -> nios2_cpu_data_master_translator_avalon_universal_master_0_agent:av_write
	wire         nios2_cpu_data_master_translator_avalon_universal_master_0_read;                                    // nios2_cpu_data_master_translator:uav_read -> nios2_cpu_data_master_translator_avalon_universal_master_0_agent:av_read
	wire  [31:0] nios2_cpu_data_master_translator_avalon_universal_master_0_readdata;                                // nios2_cpu_data_master_translator_avalon_universal_master_0_agent:av_readdata -> nios2_cpu_data_master_translator:uav_readdata
	wire         nios2_cpu_data_master_translator_avalon_universal_master_0_debugaccess;                             // nios2_cpu_data_master_translator:uav_debugaccess -> nios2_cpu_data_master_translator_avalon_universal_master_0_agent:av_debugaccess
	wire   [3:0] nios2_cpu_data_master_translator_avalon_universal_master_0_byteenable;                              // nios2_cpu_data_master_translator:uav_byteenable -> nios2_cpu_data_master_translator_avalon_universal_master_0_agent:av_byteenable
	wire         nios2_cpu_data_master_translator_avalon_universal_master_0_readdatavalid;                           // nios2_cpu_data_master_translator_avalon_universal_master_0_agent:av_readdatavalid -> nios2_cpu_data_master_translator:uav_readdatavalid
	wire         nios2_cpu_jtag_debug_module_translator_avalon_universal_slave_0_agent_m0_waitrequest;               // nios2_cpu_jtag_debug_module_translator:uav_waitrequest -> nios2_cpu_jtag_debug_module_translator_avalon_universal_slave_0_agent:m0_waitrequest
	wire   [2:0] nios2_cpu_jtag_debug_module_translator_avalon_universal_slave_0_agent_m0_burstcount;                // nios2_cpu_jtag_debug_module_translator_avalon_universal_slave_0_agent:m0_burstcount -> nios2_cpu_jtag_debug_module_translator:uav_burstcount
	wire  [31:0] nios2_cpu_jtag_debug_module_translator_avalon_universal_slave_0_agent_m0_writedata;                 // nios2_cpu_jtag_debug_module_translator_avalon_universal_slave_0_agent:m0_writedata -> nios2_cpu_jtag_debug_module_translator:uav_writedata
	wire  [15:0] nios2_cpu_jtag_debug_module_translator_avalon_universal_slave_0_agent_m0_address;                   // nios2_cpu_jtag_debug_module_translator_avalon_universal_slave_0_agent:m0_address -> nios2_cpu_jtag_debug_module_translator:uav_address
	wire         nios2_cpu_jtag_debug_module_translator_avalon_universal_slave_0_agent_m0_write;                     // nios2_cpu_jtag_debug_module_translator_avalon_universal_slave_0_agent:m0_write -> nios2_cpu_jtag_debug_module_translator:uav_write
	wire         nios2_cpu_jtag_debug_module_translator_avalon_universal_slave_0_agent_m0_lock;                      // nios2_cpu_jtag_debug_module_translator_avalon_universal_slave_0_agent:m0_lock -> nios2_cpu_jtag_debug_module_translator:uav_lock
	wire         nios2_cpu_jtag_debug_module_translator_avalon_universal_slave_0_agent_m0_read;                      // nios2_cpu_jtag_debug_module_translator_avalon_universal_slave_0_agent:m0_read -> nios2_cpu_jtag_debug_module_translator:uav_read
	wire  [31:0] nios2_cpu_jtag_debug_module_translator_avalon_universal_slave_0_agent_m0_readdata;                  // nios2_cpu_jtag_debug_module_translator:uav_readdata -> nios2_cpu_jtag_debug_module_translator_avalon_universal_slave_0_agent:m0_readdata
	wire         nios2_cpu_jtag_debug_module_translator_avalon_universal_slave_0_agent_m0_readdatavalid;             // nios2_cpu_jtag_debug_module_translator:uav_readdatavalid -> nios2_cpu_jtag_debug_module_translator_avalon_universal_slave_0_agent:m0_readdatavalid
	wire         nios2_cpu_jtag_debug_module_translator_avalon_universal_slave_0_agent_m0_debugaccess;               // nios2_cpu_jtag_debug_module_translator_avalon_universal_slave_0_agent:m0_debugaccess -> nios2_cpu_jtag_debug_module_translator:uav_debugaccess
	wire   [3:0] nios2_cpu_jtag_debug_module_translator_avalon_universal_slave_0_agent_m0_byteenable;                // nios2_cpu_jtag_debug_module_translator_avalon_universal_slave_0_agent:m0_byteenable -> nios2_cpu_jtag_debug_module_translator:uav_byteenable
	wire         nios2_cpu_jtag_debug_module_translator_avalon_universal_slave_0_agent_rf_source_endofpacket;        // nios2_cpu_jtag_debug_module_translator_avalon_universal_slave_0_agent:rf_source_endofpacket -> nios2_cpu_jtag_debug_module_translator_avalon_universal_slave_0_agent_rsp_fifo:in_endofpacket
	wire         nios2_cpu_jtag_debug_module_translator_avalon_universal_slave_0_agent_rf_source_valid;              // nios2_cpu_jtag_debug_module_translator_avalon_universal_slave_0_agent:rf_source_valid -> nios2_cpu_jtag_debug_module_translator_avalon_universal_slave_0_agent_rsp_fifo:in_valid
	wire         nios2_cpu_jtag_debug_module_translator_avalon_universal_slave_0_agent_rf_source_startofpacket;      // nios2_cpu_jtag_debug_module_translator_avalon_universal_slave_0_agent:rf_source_startofpacket -> nios2_cpu_jtag_debug_module_translator_avalon_universal_slave_0_agent_rsp_fifo:in_startofpacket
	wire  [89:0] nios2_cpu_jtag_debug_module_translator_avalon_universal_slave_0_agent_rf_source_data;               // nios2_cpu_jtag_debug_module_translator_avalon_universal_slave_0_agent:rf_source_data -> nios2_cpu_jtag_debug_module_translator_avalon_universal_slave_0_agent_rsp_fifo:in_data
	wire         nios2_cpu_jtag_debug_module_translator_avalon_universal_slave_0_agent_rf_source_ready;              // nios2_cpu_jtag_debug_module_translator_avalon_universal_slave_0_agent_rsp_fifo:in_ready -> nios2_cpu_jtag_debug_module_translator_avalon_universal_slave_0_agent:rf_source_ready
	wire         nios2_cpu_jtag_debug_module_translator_avalon_universal_slave_0_agent_rsp_fifo_out_endofpacket;     // nios2_cpu_jtag_debug_module_translator_avalon_universal_slave_0_agent_rsp_fifo:out_endofpacket -> nios2_cpu_jtag_debug_module_translator_avalon_universal_slave_0_agent:rf_sink_endofpacket
	wire         nios2_cpu_jtag_debug_module_translator_avalon_universal_slave_0_agent_rsp_fifo_out_valid;           // nios2_cpu_jtag_debug_module_translator_avalon_universal_slave_0_agent_rsp_fifo:out_valid -> nios2_cpu_jtag_debug_module_translator_avalon_universal_slave_0_agent:rf_sink_valid
	wire         nios2_cpu_jtag_debug_module_translator_avalon_universal_slave_0_agent_rsp_fifo_out_startofpacket;   // nios2_cpu_jtag_debug_module_translator_avalon_universal_slave_0_agent_rsp_fifo:out_startofpacket -> nios2_cpu_jtag_debug_module_translator_avalon_universal_slave_0_agent:rf_sink_startofpacket
	wire  [89:0] nios2_cpu_jtag_debug_module_translator_avalon_universal_slave_0_agent_rsp_fifo_out_data;            // nios2_cpu_jtag_debug_module_translator_avalon_universal_slave_0_agent_rsp_fifo:out_data -> nios2_cpu_jtag_debug_module_translator_avalon_universal_slave_0_agent:rf_sink_data
	wire         nios2_cpu_jtag_debug_module_translator_avalon_universal_slave_0_agent_rsp_fifo_out_ready;           // nios2_cpu_jtag_debug_module_translator_avalon_universal_slave_0_agent:rf_sink_ready -> nios2_cpu_jtag_debug_module_translator_avalon_universal_slave_0_agent_rsp_fifo:out_ready
	wire         nios2_cpu_jtag_debug_module_translator_avalon_universal_slave_0_agent_rdata_fifo_src_valid;         // nios2_cpu_jtag_debug_module_translator_avalon_universal_slave_0_agent:rdata_fifo_src_valid -> nios2_cpu_jtag_debug_module_translator_avalon_universal_slave_0_agent:rdata_fifo_sink_valid
	wire  [33:0] nios2_cpu_jtag_debug_module_translator_avalon_universal_slave_0_agent_rdata_fifo_src_data;          // nios2_cpu_jtag_debug_module_translator_avalon_universal_slave_0_agent:rdata_fifo_src_data -> nios2_cpu_jtag_debug_module_translator_avalon_universal_slave_0_agent:rdata_fifo_sink_data
	wire         nios2_cpu_jtag_debug_module_translator_avalon_universal_slave_0_agent_rdata_fifo_src_ready;         // nios2_cpu_jtag_debug_module_translator_avalon_universal_slave_0_agent:rdata_fifo_sink_ready -> nios2_cpu_jtag_debug_module_translator_avalon_universal_slave_0_agent:rdata_fifo_src_ready
	wire         onchip_memory2_0_s1_translator_avalon_universal_slave_0_agent_m0_waitrequest;                       // onchip_memory2_0_s1_translator:uav_waitrequest -> onchip_memory2_0_s1_translator_avalon_universal_slave_0_agent:m0_waitrequest
	wire   [2:0] onchip_memory2_0_s1_translator_avalon_universal_slave_0_agent_m0_burstcount;                        // onchip_memory2_0_s1_translator_avalon_universal_slave_0_agent:m0_burstcount -> onchip_memory2_0_s1_translator:uav_burstcount
	wire  [31:0] onchip_memory2_0_s1_translator_avalon_universal_slave_0_agent_m0_writedata;                         // onchip_memory2_0_s1_translator_avalon_universal_slave_0_agent:m0_writedata -> onchip_memory2_0_s1_translator:uav_writedata
	wire  [15:0] onchip_memory2_0_s1_translator_avalon_universal_slave_0_agent_m0_address;                           // onchip_memory2_0_s1_translator_avalon_universal_slave_0_agent:m0_address -> onchip_memory2_0_s1_translator:uav_address
	wire         onchip_memory2_0_s1_translator_avalon_universal_slave_0_agent_m0_write;                             // onchip_memory2_0_s1_translator_avalon_universal_slave_0_agent:m0_write -> onchip_memory2_0_s1_translator:uav_write
	wire         onchip_memory2_0_s1_translator_avalon_universal_slave_0_agent_m0_lock;                              // onchip_memory2_0_s1_translator_avalon_universal_slave_0_agent:m0_lock -> onchip_memory2_0_s1_translator:uav_lock
	wire         onchip_memory2_0_s1_translator_avalon_universal_slave_0_agent_m0_read;                              // onchip_memory2_0_s1_translator_avalon_universal_slave_0_agent:m0_read -> onchip_memory2_0_s1_translator:uav_read
	wire  [31:0] onchip_memory2_0_s1_translator_avalon_universal_slave_0_agent_m0_readdata;                          // onchip_memory2_0_s1_translator:uav_readdata -> onchip_memory2_0_s1_translator_avalon_universal_slave_0_agent:m0_readdata
	wire         onchip_memory2_0_s1_translator_avalon_universal_slave_0_agent_m0_readdatavalid;                     // onchip_memory2_0_s1_translator:uav_readdatavalid -> onchip_memory2_0_s1_translator_avalon_universal_slave_0_agent:m0_readdatavalid
	wire         onchip_memory2_0_s1_translator_avalon_universal_slave_0_agent_m0_debugaccess;                       // onchip_memory2_0_s1_translator_avalon_universal_slave_0_agent:m0_debugaccess -> onchip_memory2_0_s1_translator:uav_debugaccess
	wire   [3:0] onchip_memory2_0_s1_translator_avalon_universal_slave_0_agent_m0_byteenable;                        // onchip_memory2_0_s1_translator_avalon_universal_slave_0_agent:m0_byteenable -> onchip_memory2_0_s1_translator:uav_byteenable
	wire         onchip_memory2_0_s1_translator_avalon_universal_slave_0_agent_rf_source_endofpacket;                // onchip_memory2_0_s1_translator_avalon_universal_slave_0_agent:rf_source_endofpacket -> onchip_memory2_0_s1_translator_avalon_universal_slave_0_agent_rsp_fifo:in_endofpacket
	wire         onchip_memory2_0_s1_translator_avalon_universal_slave_0_agent_rf_source_valid;                      // onchip_memory2_0_s1_translator_avalon_universal_slave_0_agent:rf_source_valid -> onchip_memory2_0_s1_translator_avalon_universal_slave_0_agent_rsp_fifo:in_valid
	wire         onchip_memory2_0_s1_translator_avalon_universal_slave_0_agent_rf_source_startofpacket;              // onchip_memory2_0_s1_translator_avalon_universal_slave_0_agent:rf_source_startofpacket -> onchip_memory2_0_s1_translator_avalon_universal_slave_0_agent_rsp_fifo:in_startofpacket
	wire  [89:0] onchip_memory2_0_s1_translator_avalon_universal_slave_0_agent_rf_source_data;                       // onchip_memory2_0_s1_translator_avalon_universal_slave_0_agent:rf_source_data -> onchip_memory2_0_s1_translator_avalon_universal_slave_0_agent_rsp_fifo:in_data
	wire         onchip_memory2_0_s1_translator_avalon_universal_slave_0_agent_rf_source_ready;                      // onchip_memory2_0_s1_translator_avalon_universal_slave_0_agent_rsp_fifo:in_ready -> onchip_memory2_0_s1_translator_avalon_universal_slave_0_agent:rf_source_ready
	wire         onchip_memory2_0_s1_translator_avalon_universal_slave_0_agent_rsp_fifo_out_endofpacket;             // onchip_memory2_0_s1_translator_avalon_universal_slave_0_agent_rsp_fifo:out_endofpacket -> onchip_memory2_0_s1_translator_avalon_universal_slave_0_agent:rf_sink_endofpacket
	wire         onchip_memory2_0_s1_translator_avalon_universal_slave_0_agent_rsp_fifo_out_valid;                   // onchip_memory2_0_s1_translator_avalon_universal_slave_0_agent_rsp_fifo:out_valid -> onchip_memory2_0_s1_translator_avalon_universal_slave_0_agent:rf_sink_valid
	wire         onchip_memory2_0_s1_translator_avalon_universal_slave_0_agent_rsp_fifo_out_startofpacket;           // onchip_memory2_0_s1_translator_avalon_universal_slave_0_agent_rsp_fifo:out_startofpacket -> onchip_memory2_0_s1_translator_avalon_universal_slave_0_agent:rf_sink_startofpacket
	wire  [89:0] onchip_memory2_0_s1_translator_avalon_universal_slave_0_agent_rsp_fifo_out_data;                    // onchip_memory2_0_s1_translator_avalon_universal_slave_0_agent_rsp_fifo:out_data -> onchip_memory2_0_s1_translator_avalon_universal_slave_0_agent:rf_sink_data
	wire         onchip_memory2_0_s1_translator_avalon_universal_slave_0_agent_rsp_fifo_out_ready;                   // onchip_memory2_0_s1_translator_avalon_universal_slave_0_agent:rf_sink_ready -> onchip_memory2_0_s1_translator_avalon_universal_slave_0_agent_rsp_fifo:out_ready
	wire         onchip_memory2_0_s1_translator_avalon_universal_slave_0_agent_rdata_fifo_src_valid;                 // onchip_memory2_0_s1_translator_avalon_universal_slave_0_agent:rdata_fifo_src_valid -> onchip_memory2_0_s1_translator_avalon_universal_slave_0_agent:rdata_fifo_sink_valid
	wire  [33:0] onchip_memory2_0_s1_translator_avalon_universal_slave_0_agent_rdata_fifo_src_data;                  // onchip_memory2_0_s1_translator_avalon_universal_slave_0_agent:rdata_fifo_src_data -> onchip_memory2_0_s1_translator_avalon_universal_slave_0_agent:rdata_fifo_sink_data
	wire         onchip_memory2_0_s1_translator_avalon_universal_slave_0_agent_rdata_fifo_src_ready;                 // onchip_memory2_0_s1_translator_avalon_universal_slave_0_agent:rdata_fifo_sink_ready -> onchip_memory2_0_s1_translator_avalon_universal_slave_0_agent:rdata_fifo_src_ready
	wire         jtag_uart_0_avalon_jtag_slave_translator_avalon_universal_slave_0_agent_m0_waitrequest;             // jtag_uart_0_avalon_jtag_slave_translator:uav_waitrequest -> jtag_uart_0_avalon_jtag_slave_translator_avalon_universal_slave_0_agent:m0_waitrequest
	wire   [2:0] jtag_uart_0_avalon_jtag_slave_translator_avalon_universal_slave_0_agent_m0_burstcount;              // jtag_uart_0_avalon_jtag_slave_translator_avalon_universal_slave_0_agent:m0_burstcount -> jtag_uart_0_avalon_jtag_slave_translator:uav_burstcount
	wire  [31:0] jtag_uart_0_avalon_jtag_slave_translator_avalon_universal_slave_0_agent_m0_writedata;               // jtag_uart_0_avalon_jtag_slave_translator_avalon_universal_slave_0_agent:m0_writedata -> jtag_uart_0_avalon_jtag_slave_translator:uav_writedata
	wire  [15:0] jtag_uart_0_avalon_jtag_slave_translator_avalon_universal_slave_0_agent_m0_address;                 // jtag_uart_0_avalon_jtag_slave_translator_avalon_universal_slave_0_agent:m0_address -> jtag_uart_0_avalon_jtag_slave_translator:uav_address
	wire         jtag_uart_0_avalon_jtag_slave_translator_avalon_universal_slave_0_agent_m0_write;                   // jtag_uart_0_avalon_jtag_slave_translator_avalon_universal_slave_0_agent:m0_write -> jtag_uart_0_avalon_jtag_slave_translator:uav_write
	wire         jtag_uart_0_avalon_jtag_slave_translator_avalon_universal_slave_0_agent_m0_lock;                    // jtag_uart_0_avalon_jtag_slave_translator_avalon_universal_slave_0_agent:m0_lock -> jtag_uart_0_avalon_jtag_slave_translator:uav_lock
	wire         jtag_uart_0_avalon_jtag_slave_translator_avalon_universal_slave_0_agent_m0_read;                    // jtag_uart_0_avalon_jtag_slave_translator_avalon_universal_slave_0_agent:m0_read -> jtag_uart_0_avalon_jtag_slave_translator:uav_read
	wire  [31:0] jtag_uart_0_avalon_jtag_slave_translator_avalon_universal_slave_0_agent_m0_readdata;                // jtag_uart_0_avalon_jtag_slave_translator:uav_readdata -> jtag_uart_0_avalon_jtag_slave_translator_avalon_universal_slave_0_agent:m0_readdata
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
	wire         jtag_uart_0_avalon_jtag_slave_translator_avalon_universal_slave_0_agent_rdata_fifo_src_ready;       // jtag_uart_0_avalon_jtag_slave_translator_avalon_universal_slave_0_agent:rdata_fifo_sink_ready -> jtag_uart_0_avalon_jtag_slave_translator_avalon_universal_slave_0_agent:rdata_fifo_src_ready
	wire         pio_angle_s1_translator_avalon_universal_slave_0_agent_m0_waitrequest;                              // pio_angle_s1_translator:uav_waitrequest -> pio_angle_s1_translator_avalon_universal_slave_0_agent:m0_waitrequest
	wire   [2:0] pio_angle_s1_translator_avalon_universal_slave_0_agent_m0_burstcount;                               // pio_angle_s1_translator_avalon_universal_slave_0_agent:m0_burstcount -> pio_angle_s1_translator:uav_burstcount
	wire  [31:0] pio_angle_s1_translator_avalon_universal_slave_0_agent_m0_writedata;                                // pio_angle_s1_translator_avalon_universal_slave_0_agent:m0_writedata -> pio_angle_s1_translator:uav_writedata
	wire  [15:0] pio_angle_s1_translator_avalon_universal_slave_0_agent_m0_address;                                  // pio_angle_s1_translator_avalon_universal_slave_0_agent:m0_address -> pio_angle_s1_translator:uav_address
	wire         pio_angle_s1_translator_avalon_universal_slave_0_agent_m0_write;                                    // pio_angle_s1_translator_avalon_universal_slave_0_agent:m0_write -> pio_angle_s1_translator:uav_write
	wire         pio_angle_s1_translator_avalon_universal_slave_0_agent_m0_lock;                                     // pio_angle_s1_translator_avalon_universal_slave_0_agent:m0_lock -> pio_angle_s1_translator:uav_lock
	wire         pio_angle_s1_translator_avalon_universal_slave_0_agent_m0_read;                                     // pio_angle_s1_translator_avalon_universal_slave_0_agent:m0_read -> pio_angle_s1_translator:uav_read
	wire  [31:0] pio_angle_s1_translator_avalon_universal_slave_0_agent_m0_readdata;                                 // pio_angle_s1_translator:uav_readdata -> pio_angle_s1_translator_avalon_universal_slave_0_agent:m0_readdata
	wire         pio_angle_s1_translator_avalon_universal_slave_0_agent_m0_readdatavalid;                            // pio_angle_s1_translator:uav_readdatavalid -> pio_angle_s1_translator_avalon_universal_slave_0_agent:m0_readdatavalid
	wire         pio_angle_s1_translator_avalon_universal_slave_0_agent_m0_debugaccess;                              // pio_angle_s1_translator_avalon_universal_slave_0_agent:m0_debugaccess -> pio_angle_s1_translator:uav_debugaccess
	wire   [3:0] pio_angle_s1_translator_avalon_universal_slave_0_agent_m0_byteenable;                               // pio_angle_s1_translator_avalon_universal_slave_0_agent:m0_byteenable -> pio_angle_s1_translator:uav_byteenable
	wire         pio_angle_s1_translator_avalon_universal_slave_0_agent_rf_source_endofpacket;                       // pio_angle_s1_translator_avalon_universal_slave_0_agent:rf_source_endofpacket -> pio_angle_s1_translator_avalon_universal_slave_0_agent_rsp_fifo:in_endofpacket
	wire         pio_angle_s1_translator_avalon_universal_slave_0_agent_rf_source_valid;                             // pio_angle_s1_translator_avalon_universal_slave_0_agent:rf_source_valid -> pio_angle_s1_translator_avalon_universal_slave_0_agent_rsp_fifo:in_valid
	wire         pio_angle_s1_translator_avalon_universal_slave_0_agent_rf_source_startofpacket;                     // pio_angle_s1_translator_avalon_universal_slave_0_agent:rf_source_startofpacket -> pio_angle_s1_translator_avalon_universal_slave_0_agent_rsp_fifo:in_startofpacket
	wire  [89:0] pio_angle_s1_translator_avalon_universal_slave_0_agent_rf_source_data;                              // pio_angle_s1_translator_avalon_universal_slave_0_agent:rf_source_data -> pio_angle_s1_translator_avalon_universal_slave_0_agent_rsp_fifo:in_data
	wire         pio_angle_s1_translator_avalon_universal_slave_0_agent_rf_source_ready;                             // pio_angle_s1_translator_avalon_universal_slave_0_agent_rsp_fifo:in_ready -> pio_angle_s1_translator_avalon_universal_slave_0_agent:rf_source_ready
	wire         pio_angle_s1_translator_avalon_universal_slave_0_agent_rsp_fifo_out_endofpacket;                    // pio_angle_s1_translator_avalon_universal_slave_0_agent_rsp_fifo:out_endofpacket -> pio_angle_s1_translator_avalon_universal_slave_0_agent:rf_sink_endofpacket
	wire         pio_angle_s1_translator_avalon_universal_slave_0_agent_rsp_fifo_out_valid;                          // pio_angle_s1_translator_avalon_universal_slave_0_agent_rsp_fifo:out_valid -> pio_angle_s1_translator_avalon_universal_slave_0_agent:rf_sink_valid
	wire         pio_angle_s1_translator_avalon_universal_slave_0_agent_rsp_fifo_out_startofpacket;                  // pio_angle_s1_translator_avalon_universal_slave_0_agent_rsp_fifo:out_startofpacket -> pio_angle_s1_translator_avalon_universal_slave_0_agent:rf_sink_startofpacket
	wire  [89:0] pio_angle_s1_translator_avalon_universal_slave_0_agent_rsp_fifo_out_data;                           // pio_angle_s1_translator_avalon_universal_slave_0_agent_rsp_fifo:out_data -> pio_angle_s1_translator_avalon_universal_slave_0_agent:rf_sink_data
	wire         pio_angle_s1_translator_avalon_universal_slave_0_agent_rsp_fifo_out_ready;                          // pio_angle_s1_translator_avalon_universal_slave_0_agent:rf_sink_ready -> pio_angle_s1_translator_avalon_universal_slave_0_agent_rsp_fifo:out_ready
	wire         pio_angle_s1_translator_avalon_universal_slave_0_agent_rdata_fifo_src_valid;                        // pio_angle_s1_translator_avalon_universal_slave_0_agent:rdata_fifo_src_valid -> pio_angle_s1_translator_avalon_universal_slave_0_agent:rdata_fifo_sink_valid
	wire  [33:0] pio_angle_s1_translator_avalon_universal_slave_0_agent_rdata_fifo_src_data;                         // pio_angle_s1_translator_avalon_universal_slave_0_agent:rdata_fifo_src_data -> pio_angle_s1_translator_avalon_universal_slave_0_agent:rdata_fifo_sink_data
	wire         pio_angle_s1_translator_avalon_universal_slave_0_agent_rdata_fifo_src_ready;                        // pio_angle_s1_translator_avalon_universal_slave_0_agent:rdata_fifo_sink_ready -> pio_angle_s1_translator_avalon_universal_slave_0_agent:rdata_fifo_src_ready
	wire         pio_lcd_data_s1_translator_avalon_universal_slave_0_agent_m0_waitrequest;                           // pio_lcd_data_s1_translator:uav_waitrequest -> pio_lcd_data_s1_translator_avalon_universal_slave_0_agent:m0_waitrequest
	wire   [2:0] pio_lcd_data_s1_translator_avalon_universal_slave_0_agent_m0_burstcount;                            // pio_lcd_data_s1_translator_avalon_universal_slave_0_agent:m0_burstcount -> pio_lcd_data_s1_translator:uav_burstcount
	wire  [31:0] pio_lcd_data_s1_translator_avalon_universal_slave_0_agent_m0_writedata;                             // pio_lcd_data_s1_translator_avalon_universal_slave_0_agent:m0_writedata -> pio_lcd_data_s1_translator:uav_writedata
	wire  [15:0] pio_lcd_data_s1_translator_avalon_universal_slave_0_agent_m0_address;                               // pio_lcd_data_s1_translator_avalon_universal_slave_0_agent:m0_address -> pio_lcd_data_s1_translator:uav_address
	wire         pio_lcd_data_s1_translator_avalon_universal_slave_0_agent_m0_write;                                 // pio_lcd_data_s1_translator_avalon_universal_slave_0_agent:m0_write -> pio_lcd_data_s1_translator:uav_write
	wire         pio_lcd_data_s1_translator_avalon_universal_slave_0_agent_m0_lock;                                  // pio_lcd_data_s1_translator_avalon_universal_slave_0_agent:m0_lock -> pio_lcd_data_s1_translator:uav_lock
	wire         pio_lcd_data_s1_translator_avalon_universal_slave_0_agent_m0_read;                                  // pio_lcd_data_s1_translator_avalon_universal_slave_0_agent:m0_read -> pio_lcd_data_s1_translator:uav_read
	wire  [31:0] pio_lcd_data_s1_translator_avalon_universal_slave_0_agent_m0_readdata;                              // pio_lcd_data_s1_translator:uav_readdata -> pio_lcd_data_s1_translator_avalon_universal_slave_0_agent:m0_readdata
	wire         pio_lcd_data_s1_translator_avalon_universal_slave_0_agent_m0_readdatavalid;                         // pio_lcd_data_s1_translator:uav_readdatavalid -> pio_lcd_data_s1_translator_avalon_universal_slave_0_agent:m0_readdatavalid
	wire         pio_lcd_data_s1_translator_avalon_universal_slave_0_agent_m0_debugaccess;                           // pio_lcd_data_s1_translator_avalon_universal_slave_0_agent:m0_debugaccess -> pio_lcd_data_s1_translator:uav_debugaccess
	wire   [3:0] pio_lcd_data_s1_translator_avalon_universal_slave_0_agent_m0_byteenable;                            // pio_lcd_data_s1_translator_avalon_universal_slave_0_agent:m0_byteenable -> pio_lcd_data_s1_translator:uav_byteenable
	wire         pio_lcd_data_s1_translator_avalon_universal_slave_0_agent_rf_source_endofpacket;                    // pio_lcd_data_s1_translator_avalon_universal_slave_0_agent:rf_source_endofpacket -> pio_lcd_data_s1_translator_avalon_universal_slave_0_agent_rsp_fifo:in_endofpacket
	wire         pio_lcd_data_s1_translator_avalon_universal_slave_0_agent_rf_source_valid;                          // pio_lcd_data_s1_translator_avalon_universal_slave_0_agent:rf_source_valid -> pio_lcd_data_s1_translator_avalon_universal_slave_0_agent_rsp_fifo:in_valid
	wire         pio_lcd_data_s1_translator_avalon_universal_slave_0_agent_rf_source_startofpacket;                  // pio_lcd_data_s1_translator_avalon_universal_slave_0_agent:rf_source_startofpacket -> pio_lcd_data_s1_translator_avalon_universal_slave_0_agent_rsp_fifo:in_startofpacket
	wire  [89:0] pio_lcd_data_s1_translator_avalon_universal_slave_0_agent_rf_source_data;                           // pio_lcd_data_s1_translator_avalon_universal_slave_0_agent:rf_source_data -> pio_lcd_data_s1_translator_avalon_universal_slave_0_agent_rsp_fifo:in_data
	wire         pio_lcd_data_s1_translator_avalon_universal_slave_0_agent_rf_source_ready;                          // pio_lcd_data_s1_translator_avalon_universal_slave_0_agent_rsp_fifo:in_ready -> pio_lcd_data_s1_translator_avalon_universal_slave_0_agent:rf_source_ready
	wire         pio_lcd_data_s1_translator_avalon_universal_slave_0_agent_rsp_fifo_out_endofpacket;                 // pio_lcd_data_s1_translator_avalon_universal_slave_0_agent_rsp_fifo:out_endofpacket -> pio_lcd_data_s1_translator_avalon_universal_slave_0_agent:rf_sink_endofpacket
	wire         pio_lcd_data_s1_translator_avalon_universal_slave_0_agent_rsp_fifo_out_valid;                       // pio_lcd_data_s1_translator_avalon_universal_slave_0_agent_rsp_fifo:out_valid -> pio_lcd_data_s1_translator_avalon_universal_slave_0_agent:rf_sink_valid
	wire         pio_lcd_data_s1_translator_avalon_universal_slave_0_agent_rsp_fifo_out_startofpacket;               // pio_lcd_data_s1_translator_avalon_universal_slave_0_agent_rsp_fifo:out_startofpacket -> pio_lcd_data_s1_translator_avalon_universal_slave_0_agent:rf_sink_startofpacket
	wire  [89:0] pio_lcd_data_s1_translator_avalon_universal_slave_0_agent_rsp_fifo_out_data;                        // pio_lcd_data_s1_translator_avalon_universal_slave_0_agent_rsp_fifo:out_data -> pio_lcd_data_s1_translator_avalon_universal_slave_0_agent:rf_sink_data
	wire         pio_lcd_data_s1_translator_avalon_universal_slave_0_agent_rsp_fifo_out_ready;                       // pio_lcd_data_s1_translator_avalon_universal_slave_0_agent:rf_sink_ready -> pio_lcd_data_s1_translator_avalon_universal_slave_0_agent_rsp_fifo:out_ready
	wire         pio_lcd_data_s1_translator_avalon_universal_slave_0_agent_rdata_fifo_src_valid;                     // pio_lcd_data_s1_translator_avalon_universal_slave_0_agent:rdata_fifo_src_valid -> pio_lcd_data_s1_translator_avalon_universal_slave_0_agent:rdata_fifo_sink_valid
	wire  [33:0] pio_lcd_data_s1_translator_avalon_universal_slave_0_agent_rdata_fifo_src_data;                      // pio_lcd_data_s1_translator_avalon_universal_slave_0_agent:rdata_fifo_src_data -> pio_lcd_data_s1_translator_avalon_universal_slave_0_agent:rdata_fifo_sink_data
	wire         pio_lcd_data_s1_translator_avalon_universal_slave_0_agent_rdata_fifo_src_ready;                     // pio_lcd_data_s1_translator_avalon_universal_slave_0_agent:rdata_fifo_sink_ready -> pio_lcd_data_s1_translator_avalon_universal_slave_0_agent:rdata_fifo_src_ready
	wire         pio_control_s1_translator_avalon_universal_slave_0_agent_m0_waitrequest;                            // pio_control_s1_translator:uav_waitrequest -> pio_control_s1_translator_avalon_universal_slave_0_agent:m0_waitrequest
	wire   [2:0] pio_control_s1_translator_avalon_universal_slave_0_agent_m0_burstcount;                             // pio_control_s1_translator_avalon_universal_slave_0_agent:m0_burstcount -> pio_control_s1_translator:uav_burstcount
	wire  [31:0] pio_control_s1_translator_avalon_universal_slave_0_agent_m0_writedata;                              // pio_control_s1_translator_avalon_universal_slave_0_agent:m0_writedata -> pio_control_s1_translator:uav_writedata
	wire  [15:0] pio_control_s1_translator_avalon_universal_slave_0_agent_m0_address;                                // pio_control_s1_translator_avalon_universal_slave_0_agent:m0_address -> pio_control_s1_translator:uav_address
	wire         pio_control_s1_translator_avalon_universal_slave_0_agent_m0_write;                                  // pio_control_s1_translator_avalon_universal_slave_0_agent:m0_write -> pio_control_s1_translator:uav_write
	wire         pio_control_s1_translator_avalon_universal_slave_0_agent_m0_lock;                                   // pio_control_s1_translator_avalon_universal_slave_0_agent:m0_lock -> pio_control_s1_translator:uav_lock
	wire         pio_control_s1_translator_avalon_universal_slave_0_agent_m0_read;                                   // pio_control_s1_translator_avalon_universal_slave_0_agent:m0_read -> pio_control_s1_translator:uav_read
	wire  [31:0] pio_control_s1_translator_avalon_universal_slave_0_agent_m0_readdata;                               // pio_control_s1_translator:uav_readdata -> pio_control_s1_translator_avalon_universal_slave_0_agent:m0_readdata
	wire         pio_control_s1_translator_avalon_universal_slave_0_agent_m0_readdatavalid;                          // pio_control_s1_translator:uav_readdatavalid -> pio_control_s1_translator_avalon_universal_slave_0_agent:m0_readdatavalid
	wire         pio_control_s1_translator_avalon_universal_slave_0_agent_m0_debugaccess;                            // pio_control_s1_translator_avalon_universal_slave_0_agent:m0_debugaccess -> pio_control_s1_translator:uav_debugaccess
	wire   [3:0] pio_control_s1_translator_avalon_universal_slave_0_agent_m0_byteenable;                             // pio_control_s1_translator_avalon_universal_slave_0_agent:m0_byteenable -> pio_control_s1_translator:uav_byteenable
	wire         pio_control_s1_translator_avalon_universal_slave_0_agent_rf_source_endofpacket;                     // pio_control_s1_translator_avalon_universal_slave_0_agent:rf_source_endofpacket -> pio_control_s1_translator_avalon_universal_slave_0_agent_rsp_fifo:in_endofpacket
	wire         pio_control_s1_translator_avalon_universal_slave_0_agent_rf_source_valid;                           // pio_control_s1_translator_avalon_universal_slave_0_agent:rf_source_valid -> pio_control_s1_translator_avalon_universal_slave_0_agent_rsp_fifo:in_valid
	wire         pio_control_s1_translator_avalon_universal_slave_0_agent_rf_source_startofpacket;                   // pio_control_s1_translator_avalon_universal_slave_0_agent:rf_source_startofpacket -> pio_control_s1_translator_avalon_universal_slave_0_agent_rsp_fifo:in_startofpacket
	wire  [89:0] pio_control_s1_translator_avalon_universal_slave_0_agent_rf_source_data;                            // pio_control_s1_translator_avalon_universal_slave_0_agent:rf_source_data -> pio_control_s1_translator_avalon_universal_slave_0_agent_rsp_fifo:in_data
	wire         pio_control_s1_translator_avalon_universal_slave_0_agent_rf_source_ready;                           // pio_control_s1_translator_avalon_universal_slave_0_agent_rsp_fifo:in_ready -> pio_control_s1_translator_avalon_universal_slave_0_agent:rf_source_ready
	wire         pio_control_s1_translator_avalon_universal_slave_0_agent_rsp_fifo_out_endofpacket;                  // pio_control_s1_translator_avalon_universal_slave_0_agent_rsp_fifo:out_endofpacket -> pio_control_s1_translator_avalon_universal_slave_0_agent:rf_sink_endofpacket
	wire         pio_control_s1_translator_avalon_universal_slave_0_agent_rsp_fifo_out_valid;                        // pio_control_s1_translator_avalon_universal_slave_0_agent_rsp_fifo:out_valid -> pio_control_s1_translator_avalon_universal_slave_0_agent:rf_sink_valid
	wire         pio_control_s1_translator_avalon_universal_slave_0_agent_rsp_fifo_out_startofpacket;                // pio_control_s1_translator_avalon_universal_slave_0_agent_rsp_fifo:out_startofpacket -> pio_control_s1_translator_avalon_universal_slave_0_agent:rf_sink_startofpacket
	wire  [89:0] pio_control_s1_translator_avalon_universal_slave_0_agent_rsp_fifo_out_data;                         // pio_control_s1_translator_avalon_universal_slave_0_agent_rsp_fifo:out_data -> pio_control_s1_translator_avalon_universal_slave_0_agent:rf_sink_data
	wire         pio_control_s1_translator_avalon_universal_slave_0_agent_rsp_fifo_out_ready;                        // pio_control_s1_translator_avalon_universal_slave_0_agent:rf_sink_ready -> pio_control_s1_translator_avalon_universal_slave_0_agent_rsp_fifo:out_ready
	wire         pio_control_s1_translator_avalon_universal_slave_0_agent_rdata_fifo_src_valid;                      // pio_control_s1_translator_avalon_universal_slave_0_agent:rdata_fifo_src_valid -> pio_control_s1_translator_avalon_universal_slave_0_agent:rdata_fifo_sink_valid
	wire  [33:0] pio_control_s1_translator_avalon_universal_slave_0_agent_rdata_fifo_src_data;                       // pio_control_s1_translator_avalon_universal_slave_0_agent:rdata_fifo_src_data -> pio_control_s1_translator_avalon_universal_slave_0_agent:rdata_fifo_sink_data
	wire         pio_control_s1_translator_avalon_universal_slave_0_agent_rdata_fifo_src_ready;                      // pio_control_s1_translator_avalon_universal_slave_0_agent:rdata_fifo_sink_ready -> pio_control_s1_translator_avalon_universal_slave_0_agent:rdata_fifo_src_ready
	wire         nios2_cpu_instruction_master_translator_avalon_universal_master_0_agent_cp_endofpacket;             // nios2_cpu_instruction_master_translator_avalon_universal_master_0_agent:cp_endofpacket -> addr_router:sink_endofpacket
	wire         nios2_cpu_instruction_master_translator_avalon_universal_master_0_agent_cp_valid;                   // nios2_cpu_instruction_master_translator_avalon_universal_master_0_agent:cp_valid -> addr_router:sink_valid
	wire         nios2_cpu_instruction_master_translator_avalon_universal_master_0_agent_cp_startofpacket;           // nios2_cpu_instruction_master_translator_avalon_universal_master_0_agent:cp_startofpacket -> addr_router:sink_startofpacket
	wire  [88:0] nios2_cpu_instruction_master_translator_avalon_universal_master_0_agent_cp_data;                    // nios2_cpu_instruction_master_translator_avalon_universal_master_0_agent:cp_data -> addr_router:sink_data
	wire         nios2_cpu_instruction_master_translator_avalon_universal_master_0_agent_cp_ready;                   // addr_router:sink_ready -> nios2_cpu_instruction_master_translator_avalon_universal_master_0_agent:cp_ready
	wire         nios2_cpu_data_master_translator_avalon_universal_master_0_agent_cp_endofpacket;                    // nios2_cpu_data_master_translator_avalon_universal_master_0_agent:cp_endofpacket -> addr_router_001:sink_endofpacket
	wire         nios2_cpu_data_master_translator_avalon_universal_master_0_agent_cp_valid;                          // nios2_cpu_data_master_translator_avalon_universal_master_0_agent:cp_valid -> addr_router_001:sink_valid
	wire         nios2_cpu_data_master_translator_avalon_universal_master_0_agent_cp_startofpacket;                  // nios2_cpu_data_master_translator_avalon_universal_master_0_agent:cp_startofpacket -> addr_router_001:sink_startofpacket
	wire  [88:0] nios2_cpu_data_master_translator_avalon_universal_master_0_agent_cp_data;                           // nios2_cpu_data_master_translator_avalon_universal_master_0_agent:cp_data -> addr_router_001:sink_data
	wire         nios2_cpu_data_master_translator_avalon_universal_master_0_agent_cp_ready;                          // addr_router_001:sink_ready -> nios2_cpu_data_master_translator_avalon_universal_master_0_agent:cp_ready
	wire         nios2_cpu_jtag_debug_module_translator_avalon_universal_slave_0_agent_rp_endofpacket;               // nios2_cpu_jtag_debug_module_translator_avalon_universal_slave_0_agent:rp_endofpacket -> id_router:sink_endofpacket
	wire         nios2_cpu_jtag_debug_module_translator_avalon_universal_slave_0_agent_rp_valid;                     // nios2_cpu_jtag_debug_module_translator_avalon_universal_slave_0_agent:rp_valid -> id_router:sink_valid
	wire         nios2_cpu_jtag_debug_module_translator_avalon_universal_slave_0_agent_rp_startofpacket;             // nios2_cpu_jtag_debug_module_translator_avalon_universal_slave_0_agent:rp_startofpacket -> id_router:sink_startofpacket
	wire  [88:0] nios2_cpu_jtag_debug_module_translator_avalon_universal_slave_0_agent_rp_data;                      // nios2_cpu_jtag_debug_module_translator_avalon_universal_slave_0_agent:rp_data -> id_router:sink_data
	wire         nios2_cpu_jtag_debug_module_translator_avalon_universal_slave_0_agent_rp_ready;                     // id_router:sink_ready -> nios2_cpu_jtag_debug_module_translator_avalon_universal_slave_0_agent:rp_ready
	wire         onchip_memory2_0_s1_translator_avalon_universal_slave_0_agent_rp_endofpacket;                       // onchip_memory2_0_s1_translator_avalon_universal_slave_0_agent:rp_endofpacket -> id_router_001:sink_endofpacket
	wire         onchip_memory2_0_s1_translator_avalon_universal_slave_0_agent_rp_valid;                             // onchip_memory2_0_s1_translator_avalon_universal_slave_0_agent:rp_valid -> id_router_001:sink_valid
	wire         onchip_memory2_0_s1_translator_avalon_universal_slave_0_agent_rp_startofpacket;                     // onchip_memory2_0_s1_translator_avalon_universal_slave_0_agent:rp_startofpacket -> id_router_001:sink_startofpacket
	wire  [88:0] onchip_memory2_0_s1_translator_avalon_universal_slave_0_agent_rp_data;                              // onchip_memory2_0_s1_translator_avalon_universal_slave_0_agent:rp_data -> id_router_001:sink_data
	wire         onchip_memory2_0_s1_translator_avalon_universal_slave_0_agent_rp_ready;                             // id_router_001:sink_ready -> onchip_memory2_0_s1_translator_avalon_universal_slave_0_agent:rp_ready
	wire         jtag_uart_0_avalon_jtag_slave_translator_avalon_universal_slave_0_agent_rp_endofpacket;             // jtag_uart_0_avalon_jtag_slave_translator_avalon_universal_slave_0_agent:rp_endofpacket -> id_router_002:sink_endofpacket
	wire         jtag_uart_0_avalon_jtag_slave_translator_avalon_universal_slave_0_agent_rp_valid;                   // jtag_uart_0_avalon_jtag_slave_translator_avalon_universal_slave_0_agent:rp_valid -> id_router_002:sink_valid
	wire         jtag_uart_0_avalon_jtag_slave_translator_avalon_universal_slave_0_agent_rp_startofpacket;           // jtag_uart_0_avalon_jtag_slave_translator_avalon_universal_slave_0_agent:rp_startofpacket -> id_router_002:sink_startofpacket
	wire  [88:0] jtag_uart_0_avalon_jtag_slave_translator_avalon_universal_slave_0_agent_rp_data;                    // jtag_uart_0_avalon_jtag_slave_translator_avalon_universal_slave_0_agent:rp_data -> id_router_002:sink_data
	wire         jtag_uart_0_avalon_jtag_slave_translator_avalon_universal_slave_0_agent_rp_ready;                   // id_router_002:sink_ready -> jtag_uart_0_avalon_jtag_slave_translator_avalon_universal_slave_0_agent:rp_ready
	wire         pio_angle_s1_translator_avalon_universal_slave_0_agent_rp_endofpacket;                              // pio_angle_s1_translator_avalon_universal_slave_0_agent:rp_endofpacket -> id_router_003:sink_endofpacket
	wire         pio_angle_s1_translator_avalon_universal_slave_0_agent_rp_valid;                                    // pio_angle_s1_translator_avalon_universal_slave_0_agent:rp_valid -> id_router_003:sink_valid
	wire         pio_angle_s1_translator_avalon_universal_slave_0_agent_rp_startofpacket;                            // pio_angle_s1_translator_avalon_universal_slave_0_agent:rp_startofpacket -> id_router_003:sink_startofpacket
	wire  [88:0] pio_angle_s1_translator_avalon_universal_slave_0_agent_rp_data;                                     // pio_angle_s1_translator_avalon_universal_slave_0_agent:rp_data -> id_router_003:sink_data
	wire         pio_angle_s1_translator_avalon_universal_slave_0_agent_rp_ready;                                    // id_router_003:sink_ready -> pio_angle_s1_translator_avalon_universal_slave_0_agent:rp_ready
	wire         pio_lcd_data_s1_translator_avalon_universal_slave_0_agent_rp_endofpacket;                           // pio_lcd_data_s1_translator_avalon_universal_slave_0_agent:rp_endofpacket -> id_router_004:sink_endofpacket
	wire         pio_lcd_data_s1_translator_avalon_universal_slave_0_agent_rp_valid;                                 // pio_lcd_data_s1_translator_avalon_universal_slave_0_agent:rp_valid -> id_router_004:sink_valid
	wire         pio_lcd_data_s1_translator_avalon_universal_slave_0_agent_rp_startofpacket;                         // pio_lcd_data_s1_translator_avalon_universal_slave_0_agent:rp_startofpacket -> id_router_004:sink_startofpacket
	wire  [88:0] pio_lcd_data_s1_translator_avalon_universal_slave_0_agent_rp_data;                                  // pio_lcd_data_s1_translator_avalon_universal_slave_0_agent:rp_data -> id_router_004:sink_data
	wire         pio_lcd_data_s1_translator_avalon_universal_slave_0_agent_rp_ready;                                 // id_router_004:sink_ready -> pio_lcd_data_s1_translator_avalon_universal_slave_0_agent:rp_ready
	wire         pio_control_s1_translator_avalon_universal_slave_0_agent_rp_endofpacket;                            // pio_control_s1_translator_avalon_universal_slave_0_agent:rp_endofpacket -> id_router_005:sink_endofpacket
	wire         pio_control_s1_translator_avalon_universal_slave_0_agent_rp_valid;                                  // pio_control_s1_translator_avalon_universal_slave_0_agent:rp_valid -> id_router_005:sink_valid
	wire         pio_control_s1_translator_avalon_universal_slave_0_agent_rp_startofpacket;                          // pio_control_s1_translator_avalon_universal_slave_0_agent:rp_startofpacket -> id_router_005:sink_startofpacket
	wire  [88:0] pio_control_s1_translator_avalon_universal_slave_0_agent_rp_data;                                   // pio_control_s1_translator_avalon_universal_slave_0_agent:rp_data -> id_router_005:sink_data
	wire         pio_control_s1_translator_avalon_universal_slave_0_agent_rp_ready;                                  // id_router_005:sink_ready -> pio_control_s1_translator_avalon_universal_slave_0_agent:rp_ready
	wire         addr_router_src_endofpacket;                                                                        // addr_router:src_endofpacket -> limiter:cmd_sink_endofpacket
	wire         addr_router_src_valid;                                                                              // addr_router:src_valid -> limiter:cmd_sink_valid
	wire         addr_router_src_startofpacket;                                                                      // addr_router:src_startofpacket -> limiter:cmd_sink_startofpacket
	wire  [88:0] addr_router_src_data;                                                                               // addr_router:src_data -> limiter:cmd_sink_data
	wire   [5:0] addr_router_src_channel;                                                                            // addr_router:src_channel -> limiter:cmd_sink_channel
	wire         addr_router_src_ready;                                                                              // limiter:cmd_sink_ready -> addr_router:src_ready
	wire         limiter_rsp_src_endofpacket;                                                                        // limiter:rsp_src_endofpacket -> nios2_cpu_instruction_master_translator_avalon_universal_master_0_agent:rp_endofpacket
	wire         limiter_rsp_src_valid;                                                                              // limiter:rsp_src_valid -> nios2_cpu_instruction_master_translator_avalon_universal_master_0_agent:rp_valid
	wire         limiter_rsp_src_startofpacket;                                                                      // limiter:rsp_src_startofpacket -> nios2_cpu_instruction_master_translator_avalon_universal_master_0_agent:rp_startofpacket
	wire  [88:0] limiter_rsp_src_data;                                                                               // limiter:rsp_src_data -> nios2_cpu_instruction_master_translator_avalon_universal_master_0_agent:rp_data
	wire   [5:0] limiter_rsp_src_channel;                                                                            // limiter:rsp_src_channel -> nios2_cpu_instruction_master_translator_avalon_universal_master_0_agent:rp_channel
	wire         limiter_rsp_src_ready;                                                                              // nios2_cpu_instruction_master_translator_avalon_universal_master_0_agent:rp_ready -> limiter:rsp_src_ready
	wire         rst_controller_reset_out_reset;                                                                     // rst_controller:reset_out -> [addr_router:reset, addr_router_001:reset, cmd_xbar_demux:reset, cmd_xbar_demux_001:reset, cmd_xbar_mux:reset, id_router:reset, irq_mapper:reset, limiter:reset, nios2_cpu:reset_n, nios2_cpu_data_master_translator:reset, nios2_cpu_data_master_translator_avalon_universal_master_0_agent:reset, nios2_cpu_instruction_master_translator:reset, nios2_cpu_instruction_master_translator_avalon_universal_master_0_agent:reset, nios2_cpu_jtag_debug_module_translator:reset, nios2_cpu_jtag_debug_module_translator_avalon_universal_slave_0_agent:reset, nios2_cpu_jtag_debug_module_translator_avalon_universal_slave_0_agent_rsp_fifo:reset, rsp_xbar_demux:reset, rsp_xbar_mux:reset, rsp_xbar_mux_001:reset]
	wire         nios2_cpu_jtag_debug_module_reset_reset;                                                            // nios2_cpu:jtag_debug_module_resetrequest -> rst_controller:reset_in1
	wire         rst_controller_001_reset_out_reset;                                                                 // rst_controller_001:reset_out -> [cmd_xbar_mux_001:reset, id_router_001:reset, id_router_002:reset, id_router_003:reset, id_router_004:reset, id_router_005:reset, jtag_uart_0:rst_n, jtag_uart_0_avalon_jtag_slave_translator:reset, jtag_uart_0_avalon_jtag_slave_translator_avalon_universal_slave_0_agent:reset, jtag_uart_0_avalon_jtag_slave_translator_avalon_universal_slave_0_agent_rsp_fifo:reset, onchip_memory2_0:reset, onchip_memory2_0_s1_translator:reset, onchip_memory2_0_s1_translator_avalon_universal_slave_0_agent:reset, onchip_memory2_0_s1_translator_avalon_universal_slave_0_agent_rsp_fifo:reset, pio_angle:reset_n, pio_angle_s1_translator:reset, pio_angle_s1_translator_avalon_universal_slave_0_agent:reset, pio_angle_s1_translator_avalon_universal_slave_0_agent_rsp_fifo:reset, pio_control:reset_n, pio_control_s1_translator:reset, pio_control_s1_translator_avalon_universal_slave_0_agent:reset, pio_control_s1_translator_avalon_universal_slave_0_agent_rsp_fifo:reset, pio_lcd_data:reset_n, pio_lcd_data_s1_translator:reset, pio_lcd_data_s1_translator_avalon_universal_slave_0_agent:reset, pio_lcd_data_s1_translator_avalon_universal_slave_0_agent_rsp_fifo:reset, rsp_xbar_demux_001:reset, rsp_xbar_demux_002:reset, rsp_xbar_demux_003:reset, rsp_xbar_demux_004:reset, rsp_xbar_demux_005:reset]
	wire         cmd_xbar_demux_src0_endofpacket;                                                                    // cmd_xbar_demux:src0_endofpacket -> cmd_xbar_mux:sink0_endofpacket
	wire         cmd_xbar_demux_src0_valid;                                                                          // cmd_xbar_demux:src0_valid -> cmd_xbar_mux:sink0_valid
	wire         cmd_xbar_demux_src0_startofpacket;                                                                  // cmd_xbar_demux:src0_startofpacket -> cmd_xbar_mux:sink0_startofpacket
	wire  [88:0] cmd_xbar_demux_src0_data;                                                                           // cmd_xbar_demux:src0_data -> cmd_xbar_mux:sink0_data
	wire   [5:0] cmd_xbar_demux_src0_channel;                                                                        // cmd_xbar_demux:src0_channel -> cmd_xbar_mux:sink0_channel
	wire         cmd_xbar_demux_src0_ready;                                                                          // cmd_xbar_mux:sink0_ready -> cmd_xbar_demux:src0_ready
	wire         cmd_xbar_demux_src1_endofpacket;                                                                    // cmd_xbar_demux:src1_endofpacket -> cmd_xbar_mux_001:sink0_endofpacket
	wire         cmd_xbar_demux_src1_valid;                                                                          // cmd_xbar_demux:src1_valid -> cmd_xbar_mux_001:sink0_valid
	wire         cmd_xbar_demux_src1_startofpacket;                                                                  // cmd_xbar_demux:src1_startofpacket -> cmd_xbar_mux_001:sink0_startofpacket
	wire  [88:0] cmd_xbar_demux_src1_data;                                                                           // cmd_xbar_demux:src1_data -> cmd_xbar_mux_001:sink0_data
	wire   [5:0] cmd_xbar_demux_src1_channel;                                                                        // cmd_xbar_demux:src1_channel -> cmd_xbar_mux_001:sink0_channel
	wire         cmd_xbar_demux_src1_ready;                                                                          // cmd_xbar_mux_001:sink0_ready -> cmd_xbar_demux:src1_ready
	wire         cmd_xbar_demux_001_src0_endofpacket;                                                                // cmd_xbar_demux_001:src0_endofpacket -> cmd_xbar_mux:sink1_endofpacket
	wire         cmd_xbar_demux_001_src0_valid;                                                                      // cmd_xbar_demux_001:src0_valid -> cmd_xbar_mux:sink1_valid
	wire         cmd_xbar_demux_001_src0_startofpacket;                                                              // cmd_xbar_demux_001:src0_startofpacket -> cmd_xbar_mux:sink1_startofpacket
	wire  [88:0] cmd_xbar_demux_001_src0_data;                                                                       // cmd_xbar_demux_001:src0_data -> cmd_xbar_mux:sink1_data
	wire   [5:0] cmd_xbar_demux_001_src0_channel;                                                                    // cmd_xbar_demux_001:src0_channel -> cmd_xbar_mux:sink1_channel
	wire         cmd_xbar_demux_001_src0_ready;                                                                      // cmd_xbar_mux:sink1_ready -> cmd_xbar_demux_001:src0_ready
	wire         cmd_xbar_demux_001_src1_endofpacket;                                                                // cmd_xbar_demux_001:src1_endofpacket -> cmd_xbar_mux_001:sink1_endofpacket
	wire         cmd_xbar_demux_001_src1_valid;                                                                      // cmd_xbar_demux_001:src1_valid -> cmd_xbar_mux_001:sink1_valid
	wire         cmd_xbar_demux_001_src1_startofpacket;                                                              // cmd_xbar_demux_001:src1_startofpacket -> cmd_xbar_mux_001:sink1_startofpacket
	wire  [88:0] cmd_xbar_demux_001_src1_data;                                                                       // cmd_xbar_demux_001:src1_data -> cmd_xbar_mux_001:sink1_data
	wire   [5:0] cmd_xbar_demux_001_src1_channel;                                                                    // cmd_xbar_demux_001:src1_channel -> cmd_xbar_mux_001:sink1_channel
	wire         cmd_xbar_demux_001_src1_ready;                                                                      // cmd_xbar_mux_001:sink1_ready -> cmd_xbar_demux_001:src1_ready
	wire         cmd_xbar_demux_001_src2_endofpacket;                                                                // cmd_xbar_demux_001:src2_endofpacket -> jtag_uart_0_avalon_jtag_slave_translator_avalon_universal_slave_0_agent:cp_endofpacket
	wire         cmd_xbar_demux_001_src2_valid;                                                                      // cmd_xbar_demux_001:src2_valid -> jtag_uart_0_avalon_jtag_slave_translator_avalon_universal_slave_0_agent:cp_valid
	wire         cmd_xbar_demux_001_src2_startofpacket;                                                              // cmd_xbar_demux_001:src2_startofpacket -> jtag_uart_0_avalon_jtag_slave_translator_avalon_universal_slave_0_agent:cp_startofpacket
	wire  [88:0] cmd_xbar_demux_001_src2_data;                                                                       // cmd_xbar_demux_001:src2_data -> jtag_uart_0_avalon_jtag_slave_translator_avalon_universal_slave_0_agent:cp_data
	wire   [5:0] cmd_xbar_demux_001_src2_channel;                                                                    // cmd_xbar_demux_001:src2_channel -> jtag_uart_0_avalon_jtag_slave_translator_avalon_universal_slave_0_agent:cp_channel
	wire         cmd_xbar_demux_001_src3_endofpacket;                                                                // cmd_xbar_demux_001:src3_endofpacket -> pio_angle_s1_translator_avalon_universal_slave_0_agent:cp_endofpacket
	wire         cmd_xbar_demux_001_src3_valid;                                                                      // cmd_xbar_demux_001:src3_valid -> pio_angle_s1_translator_avalon_universal_slave_0_agent:cp_valid
	wire         cmd_xbar_demux_001_src3_startofpacket;                                                              // cmd_xbar_demux_001:src3_startofpacket -> pio_angle_s1_translator_avalon_universal_slave_0_agent:cp_startofpacket
	wire  [88:0] cmd_xbar_demux_001_src3_data;                                                                       // cmd_xbar_demux_001:src3_data -> pio_angle_s1_translator_avalon_universal_slave_0_agent:cp_data
	wire   [5:0] cmd_xbar_demux_001_src3_channel;                                                                    // cmd_xbar_demux_001:src3_channel -> pio_angle_s1_translator_avalon_universal_slave_0_agent:cp_channel
	wire         cmd_xbar_demux_001_src4_endofpacket;                                                                // cmd_xbar_demux_001:src4_endofpacket -> pio_lcd_data_s1_translator_avalon_universal_slave_0_agent:cp_endofpacket
	wire         cmd_xbar_demux_001_src4_valid;                                                                      // cmd_xbar_demux_001:src4_valid -> pio_lcd_data_s1_translator_avalon_universal_slave_0_agent:cp_valid
	wire         cmd_xbar_demux_001_src4_startofpacket;                                                              // cmd_xbar_demux_001:src4_startofpacket -> pio_lcd_data_s1_translator_avalon_universal_slave_0_agent:cp_startofpacket
	wire  [88:0] cmd_xbar_demux_001_src4_data;                                                                       // cmd_xbar_demux_001:src4_data -> pio_lcd_data_s1_translator_avalon_universal_slave_0_agent:cp_data
	wire   [5:0] cmd_xbar_demux_001_src4_channel;                                                                    // cmd_xbar_demux_001:src4_channel -> pio_lcd_data_s1_translator_avalon_universal_slave_0_agent:cp_channel
	wire         cmd_xbar_demux_001_src5_endofpacket;                                                                // cmd_xbar_demux_001:src5_endofpacket -> pio_control_s1_translator_avalon_universal_slave_0_agent:cp_endofpacket
	wire         cmd_xbar_demux_001_src5_valid;                                                                      // cmd_xbar_demux_001:src5_valid -> pio_control_s1_translator_avalon_universal_slave_0_agent:cp_valid
	wire         cmd_xbar_demux_001_src5_startofpacket;                                                              // cmd_xbar_demux_001:src5_startofpacket -> pio_control_s1_translator_avalon_universal_slave_0_agent:cp_startofpacket
	wire  [88:0] cmd_xbar_demux_001_src5_data;                                                                       // cmd_xbar_demux_001:src5_data -> pio_control_s1_translator_avalon_universal_slave_0_agent:cp_data
	wire   [5:0] cmd_xbar_demux_001_src5_channel;                                                                    // cmd_xbar_demux_001:src5_channel -> pio_control_s1_translator_avalon_universal_slave_0_agent:cp_channel
	wire         rsp_xbar_demux_src0_endofpacket;                                                                    // rsp_xbar_demux:src0_endofpacket -> rsp_xbar_mux:sink0_endofpacket
	wire         rsp_xbar_demux_src0_valid;                                                                          // rsp_xbar_demux:src0_valid -> rsp_xbar_mux:sink0_valid
	wire         rsp_xbar_demux_src0_startofpacket;                                                                  // rsp_xbar_demux:src0_startofpacket -> rsp_xbar_mux:sink0_startofpacket
	wire  [88:0] rsp_xbar_demux_src0_data;                                                                           // rsp_xbar_demux:src0_data -> rsp_xbar_mux:sink0_data
	wire   [5:0] rsp_xbar_demux_src0_channel;                                                                        // rsp_xbar_demux:src0_channel -> rsp_xbar_mux:sink0_channel
	wire         rsp_xbar_demux_src0_ready;                                                                          // rsp_xbar_mux:sink0_ready -> rsp_xbar_demux:src0_ready
	wire         rsp_xbar_demux_src1_endofpacket;                                                                    // rsp_xbar_demux:src1_endofpacket -> rsp_xbar_mux_001:sink0_endofpacket
	wire         rsp_xbar_demux_src1_valid;                                                                          // rsp_xbar_demux:src1_valid -> rsp_xbar_mux_001:sink0_valid
	wire         rsp_xbar_demux_src1_startofpacket;                                                                  // rsp_xbar_demux:src1_startofpacket -> rsp_xbar_mux_001:sink0_startofpacket
	wire  [88:0] rsp_xbar_demux_src1_data;                                                                           // rsp_xbar_demux:src1_data -> rsp_xbar_mux_001:sink0_data
	wire   [5:0] rsp_xbar_demux_src1_channel;                                                                        // rsp_xbar_demux:src1_channel -> rsp_xbar_mux_001:sink0_channel
	wire         rsp_xbar_demux_src1_ready;                                                                          // rsp_xbar_mux_001:sink0_ready -> rsp_xbar_demux:src1_ready
	wire         rsp_xbar_demux_001_src0_endofpacket;                                                                // rsp_xbar_demux_001:src0_endofpacket -> rsp_xbar_mux:sink1_endofpacket
	wire         rsp_xbar_demux_001_src0_valid;                                                                      // rsp_xbar_demux_001:src0_valid -> rsp_xbar_mux:sink1_valid
	wire         rsp_xbar_demux_001_src0_startofpacket;                                                              // rsp_xbar_demux_001:src0_startofpacket -> rsp_xbar_mux:sink1_startofpacket
	wire  [88:0] rsp_xbar_demux_001_src0_data;                                                                       // rsp_xbar_demux_001:src0_data -> rsp_xbar_mux:sink1_data
	wire   [5:0] rsp_xbar_demux_001_src0_channel;                                                                    // rsp_xbar_demux_001:src0_channel -> rsp_xbar_mux:sink1_channel
	wire         rsp_xbar_demux_001_src0_ready;                                                                      // rsp_xbar_mux:sink1_ready -> rsp_xbar_demux_001:src0_ready
	wire         rsp_xbar_demux_001_src1_endofpacket;                                                                // rsp_xbar_demux_001:src1_endofpacket -> rsp_xbar_mux_001:sink1_endofpacket
	wire         rsp_xbar_demux_001_src1_valid;                                                                      // rsp_xbar_demux_001:src1_valid -> rsp_xbar_mux_001:sink1_valid
	wire         rsp_xbar_demux_001_src1_startofpacket;                                                              // rsp_xbar_demux_001:src1_startofpacket -> rsp_xbar_mux_001:sink1_startofpacket
	wire  [88:0] rsp_xbar_demux_001_src1_data;                                                                       // rsp_xbar_demux_001:src1_data -> rsp_xbar_mux_001:sink1_data
	wire   [5:0] rsp_xbar_demux_001_src1_channel;                                                                    // rsp_xbar_demux_001:src1_channel -> rsp_xbar_mux_001:sink1_channel
	wire         rsp_xbar_demux_001_src1_ready;                                                                      // rsp_xbar_mux_001:sink1_ready -> rsp_xbar_demux_001:src1_ready
	wire         rsp_xbar_demux_002_src0_endofpacket;                                                                // rsp_xbar_demux_002:src0_endofpacket -> rsp_xbar_mux_001:sink2_endofpacket
	wire         rsp_xbar_demux_002_src0_valid;                                                                      // rsp_xbar_demux_002:src0_valid -> rsp_xbar_mux_001:sink2_valid
	wire         rsp_xbar_demux_002_src0_startofpacket;                                                              // rsp_xbar_demux_002:src0_startofpacket -> rsp_xbar_mux_001:sink2_startofpacket
	wire  [88:0] rsp_xbar_demux_002_src0_data;                                                                       // rsp_xbar_demux_002:src0_data -> rsp_xbar_mux_001:sink2_data
	wire   [5:0] rsp_xbar_demux_002_src0_channel;                                                                    // rsp_xbar_demux_002:src0_channel -> rsp_xbar_mux_001:sink2_channel
	wire         rsp_xbar_demux_002_src0_ready;                                                                      // rsp_xbar_mux_001:sink2_ready -> rsp_xbar_demux_002:src0_ready
	wire         rsp_xbar_demux_003_src0_endofpacket;                                                                // rsp_xbar_demux_003:src0_endofpacket -> rsp_xbar_mux_001:sink3_endofpacket
	wire         rsp_xbar_demux_003_src0_valid;                                                                      // rsp_xbar_demux_003:src0_valid -> rsp_xbar_mux_001:sink3_valid
	wire         rsp_xbar_demux_003_src0_startofpacket;                                                              // rsp_xbar_demux_003:src0_startofpacket -> rsp_xbar_mux_001:sink3_startofpacket
	wire  [88:0] rsp_xbar_demux_003_src0_data;                                                                       // rsp_xbar_demux_003:src0_data -> rsp_xbar_mux_001:sink3_data
	wire   [5:0] rsp_xbar_demux_003_src0_channel;                                                                    // rsp_xbar_demux_003:src0_channel -> rsp_xbar_mux_001:sink3_channel
	wire         rsp_xbar_demux_003_src0_ready;                                                                      // rsp_xbar_mux_001:sink3_ready -> rsp_xbar_demux_003:src0_ready
	wire         rsp_xbar_demux_004_src0_endofpacket;                                                                // rsp_xbar_demux_004:src0_endofpacket -> rsp_xbar_mux_001:sink4_endofpacket
	wire         rsp_xbar_demux_004_src0_valid;                                                                      // rsp_xbar_demux_004:src0_valid -> rsp_xbar_mux_001:sink4_valid
	wire         rsp_xbar_demux_004_src0_startofpacket;                                                              // rsp_xbar_demux_004:src0_startofpacket -> rsp_xbar_mux_001:sink4_startofpacket
	wire  [88:0] rsp_xbar_demux_004_src0_data;                                                                       // rsp_xbar_demux_004:src0_data -> rsp_xbar_mux_001:sink4_data
	wire   [5:0] rsp_xbar_demux_004_src0_channel;                                                                    // rsp_xbar_demux_004:src0_channel -> rsp_xbar_mux_001:sink4_channel
	wire         rsp_xbar_demux_004_src0_ready;                                                                      // rsp_xbar_mux_001:sink4_ready -> rsp_xbar_demux_004:src0_ready
	wire         rsp_xbar_demux_005_src0_endofpacket;                                                                // rsp_xbar_demux_005:src0_endofpacket -> rsp_xbar_mux_001:sink5_endofpacket
	wire         rsp_xbar_demux_005_src0_valid;                                                                      // rsp_xbar_demux_005:src0_valid -> rsp_xbar_mux_001:sink5_valid
	wire         rsp_xbar_demux_005_src0_startofpacket;                                                              // rsp_xbar_demux_005:src0_startofpacket -> rsp_xbar_mux_001:sink5_startofpacket
	wire  [88:0] rsp_xbar_demux_005_src0_data;                                                                       // rsp_xbar_demux_005:src0_data -> rsp_xbar_mux_001:sink5_data
	wire   [5:0] rsp_xbar_demux_005_src0_channel;                                                                    // rsp_xbar_demux_005:src0_channel -> rsp_xbar_mux_001:sink5_channel
	wire         rsp_xbar_demux_005_src0_ready;                                                                      // rsp_xbar_mux_001:sink5_ready -> rsp_xbar_demux_005:src0_ready
	wire         limiter_cmd_src_endofpacket;                                                                        // limiter:cmd_src_endofpacket -> cmd_xbar_demux:sink_endofpacket
	wire         limiter_cmd_src_startofpacket;                                                                      // limiter:cmd_src_startofpacket -> cmd_xbar_demux:sink_startofpacket
	wire  [88:0] limiter_cmd_src_data;                                                                               // limiter:cmd_src_data -> cmd_xbar_demux:sink_data
	wire   [5:0] limiter_cmd_src_channel;                                                                            // limiter:cmd_src_channel -> cmd_xbar_demux:sink_channel
	wire         limiter_cmd_src_ready;                                                                              // cmd_xbar_demux:sink_ready -> limiter:cmd_src_ready
	wire         rsp_xbar_mux_src_endofpacket;                                                                       // rsp_xbar_mux:src_endofpacket -> limiter:rsp_sink_endofpacket
	wire         rsp_xbar_mux_src_valid;                                                                             // rsp_xbar_mux:src_valid -> limiter:rsp_sink_valid
	wire         rsp_xbar_mux_src_startofpacket;                                                                     // rsp_xbar_mux:src_startofpacket -> limiter:rsp_sink_startofpacket
	wire  [88:0] rsp_xbar_mux_src_data;                                                                              // rsp_xbar_mux:src_data -> limiter:rsp_sink_data
	wire   [5:0] rsp_xbar_mux_src_channel;                                                                           // rsp_xbar_mux:src_channel -> limiter:rsp_sink_channel
	wire         rsp_xbar_mux_src_ready;                                                                             // limiter:rsp_sink_ready -> rsp_xbar_mux:src_ready
	wire         addr_router_001_src_endofpacket;                                                                    // addr_router_001:src_endofpacket -> cmd_xbar_demux_001:sink_endofpacket
	wire         addr_router_001_src_valid;                                                                          // addr_router_001:src_valid -> cmd_xbar_demux_001:sink_valid
	wire         addr_router_001_src_startofpacket;                                                                  // addr_router_001:src_startofpacket -> cmd_xbar_demux_001:sink_startofpacket
	wire  [88:0] addr_router_001_src_data;                                                                           // addr_router_001:src_data -> cmd_xbar_demux_001:sink_data
	wire   [5:0] addr_router_001_src_channel;                                                                        // addr_router_001:src_channel -> cmd_xbar_demux_001:sink_channel
	wire         addr_router_001_src_ready;                                                                          // cmd_xbar_demux_001:sink_ready -> addr_router_001:src_ready
	wire         rsp_xbar_mux_001_src_endofpacket;                                                                   // rsp_xbar_mux_001:src_endofpacket -> nios2_cpu_data_master_translator_avalon_universal_master_0_agent:rp_endofpacket
	wire         rsp_xbar_mux_001_src_valid;                                                                         // rsp_xbar_mux_001:src_valid -> nios2_cpu_data_master_translator_avalon_universal_master_0_agent:rp_valid
	wire         rsp_xbar_mux_001_src_startofpacket;                                                                 // rsp_xbar_mux_001:src_startofpacket -> nios2_cpu_data_master_translator_avalon_universal_master_0_agent:rp_startofpacket
	wire  [88:0] rsp_xbar_mux_001_src_data;                                                                          // rsp_xbar_mux_001:src_data -> nios2_cpu_data_master_translator_avalon_universal_master_0_agent:rp_data
	wire   [5:0] rsp_xbar_mux_001_src_channel;                                                                       // rsp_xbar_mux_001:src_channel -> nios2_cpu_data_master_translator_avalon_universal_master_0_agent:rp_channel
	wire         rsp_xbar_mux_001_src_ready;                                                                         // nios2_cpu_data_master_translator_avalon_universal_master_0_agent:rp_ready -> rsp_xbar_mux_001:src_ready
	wire         cmd_xbar_mux_src_endofpacket;                                                                       // cmd_xbar_mux:src_endofpacket -> nios2_cpu_jtag_debug_module_translator_avalon_universal_slave_0_agent:cp_endofpacket
	wire         cmd_xbar_mux_src_valid;                                                                             // cmd_xbar_mux:src_valid -> nios2_cpu_jtag_debug_module_translator_avalon_universal_slave_0_agent:cp_valid
	wire         cmd_xbar_mux_src_startofpacket;                                                                     // cmd_xbar_mux:src_startofpacket -> nios2_cpu_jtag_debug_module_translator_avalon_universal_slave_0_agent:cp_startofpacket
	wire  [88:0] cmd_xbar_mux_src_data;                                                                              // cmd_xbar_mux:src_data -> nios2_cpu_jtag_debug_module_translator_avalon_universal_slave_0_agent:cp_data
	wire   [5:0] cmd_xbar_mux_src_channel;                                                                           // cmd_xbar_mux:src_channel -> nios2_cpu_jtag_debug_module_translator_avalon_universal_slave_0_agent:cp_channel
	wire         cmd_xbar_mux_src_ready;                                                                             // nios2_cpu_jtag_debug_module_translator_avalon_universal_slave_0_agent:cp_ready -> cmd_xbar_mux:src_ready
	wire         id_router_src_endofpacket;                                                                          // id_router:src_endofpacket -> rsp_xbar_demux:sink_endofpacket
	wire         id_router_src_valid;                                                                                // id_router:src_valid -> rsp_xbar_demux:sink_valid
	wire         id_router_src_startofpacket;                                                                        // id_router:src_startofpacket -> rsp_xbar_demux:sink_startofpacket
	wire  [88:0] id_router_src_data;                                                                                 // id_router:src_data -> rsp_xbar_demux:sink_data
	wire   [5:0] id_router_src_channel;                                                                              // id_router:src_channel -> rsp_xbar_demux:sink_channel
	wire         id_router_src_ready;                                                                                // rsp_xbar_demux:sink_ready -> id_router:src_ready
	wire         cmd_xbar_mux_001_src_endofpacket;                                                                   // cmd_xbar_mux_001:src_endofpacket -> onchip_memory2_0_s1_translator_avalon_universal_slave_0_agent:cp_endofpacket
	wire         cmd_xbar_mux_001_src_valid;                                                                         // cmd_xbar_mux_001:src_valid -> onchip_memory2_0_s1_translator_avalon_universal_slave_0_agent:cp_valid
	wire         cmd_xbar_mux_001_src_startofpacket;                                                                 // cmd_xbar_mux_001:src_startofpacket -> onchip_memory2_0_s1_translator_avalon_universal_slave_0_agent:cp_startofpacket
	wire  [88:0] cmd_xbar_mux_001_src_data;                                                                          // cmd_xbar_mux_001:src_data -> onchip_memory2_0_s1_translator_avalon_universal_slave_0_agent:cp_data
	wire   [5:0] cmd_xbar_mux_001_src_channel;                                                                       // cmd_xbar_mux_001:src_channel -> onchip_memory2_0_s1_translator_avalon_universal_slave_0_agent:cp_channel
	wire         cmd_xbar_mux_001_src_ready;                                                                         // onchip_memory2_0_s1_translator_avalon_universal_slave_0_agent:cp_ready -> cmd_xbar_mux_001:src_ready
	wire         id_router_001_src_endofpacket;                                                                      // id_router_001:src_endofpacket -> rsp_xbar_demux_001:sink_endofpacket
	wire         id_router_001_src_valid;                                                                            // id_router_001:src_valid -> rsp_xbar_demux_001:sink_valid
	wire         id_router_001_src_startofpacket;                                                                    // id_router_001:src_startofpacket -> rsp_xbar_demux_001:sink_startofpacket
	wire  [88:0] id_router_001_src_data;                                                                             // id_router_001:src_data -> rsp_xbar_demux_001:sink_data
	wire   [5:0] id_router_001_src_channel;                                                                          // id_router_001:src_channel -> rsp_xbar_demux_001:sink_channel
	wire         id_router_001_src_ready;                                                                            // rsp_xbar_demux_001:sink_ready -> id_router_001:src_ready
	wire         cmd_xbar_demux_001_src2_ready;                                                                      // jtag_uart_0_avalon_jtag_slave_translator_avalon_universal_slave_0_agent:cp_ready -> cmd_xbar_demux_001:src2_ready
	wire         id_router_002_src_endofpacket;                                                                      // id_router_002:src_endofpacket -> rsp_xbar_demux_002:sink_endofpacket
	wire         id_router_002_src_valid;                                                                            // id_router_002:src_valid -> rsp_xbar_demux_002:sink_valid
	wire         id_router_002_src_startofpacket;                                                                    // id_router_002:src_startofpacket -> rsp_xbar_demux_002:sink_startofpacket
	wire  [88:0] id_router_002_src_data;                                                                             // id_router_002:src_data -> rsp_xbar_demux_002:sink_data
	wire   [5:0] id_router_002_src_channel;                                                                          // id_router_002:src_channel -> rsp_xbar_demux_002:sink_channel
	wire         id_router_002_src_ready;                                                                            // rsp_xbar_demux_002:sink_ready -> id_router_002:src_ready
	wire         cmd_xbar_demux_001_src3_ready;                                                                      // pio_angle_s1_translator_avalon_universal_slave_0_agent:cp_ready -> cmd_xbar_demux_001:src3_ready
	wire         id_router_003_src_endofpacket;                                                                      // id_router_003:src_endofpacket -> rsp_xbar_demux_003:sink_endofpacket
	wire         id_router_003_src_valid;                                                                            // id_router_003:src_valid -> rsp_xbar_demux_003:sink_valid
	wire         id_router_003_src_startofpacket;                                                                    // id_router_003:src_startofpacket -> rsp_xbar_demux_003:sink_startofpacket
	wire  [88:0] id_router_003_src_data;                                                                             // id_router_003:src_data -> rsp_xbar_demux_003:sink_data
	wire   [5:0] id_router_003_src_channel;                                                                          // id_router_003:src_channel -> rsp_xbar_demux_003:sink_channel
	wire         id_router_003_src_ready;                                                                            // rsp_xbar_demux_003:sink_ready -> id_router_003:src_ready
	wire         cmd_xbar_demux_001_src4_ready;                                                                      // pio_lcd_data_s1_translator_avalon_universal_slave_0_agent:cp_ready -> cmd_xbar_demux_001:src4_ready
	wire         id_router_004_src_endofpacket;                                                                      // id_router_004:src_endofpacket -> rsp_xbar_demux_004:sink_endofpacket
	wire         id_router_004_src_valid;                                                                            // id_router_004:src_valid -> rsp_xbar_demux_004:sink_valid
	wire         id_router_004_src_startofpacket;                                                                    // id_router_004:src_startofpacket -> rsp_xbar_demux_004:sink_startofpacket
	wire  [88:0] id_router_004_src_data;                                                                             // id_router_004:src_data -> rsp_xbar_demux_004:sink_data
	wire   [5:0] id_router_004_src_channel;                                                                          // id_router_004:src_channel -> rsp_xbar_demux_004:sink_channel
	wire         id_router_004_src_ready;                                                                            // rsp_xbar_demux_004:sink_ready -> id_router_004:src_ready
	wire         cmd_xbar_demux_001_src5_ready;                                                                      // pio_control_s1_translator_avalon_universal_slave_0_agent:cp_ready -> cmd_xbar_demux_001:src5_ready
	wire         id_router_005_src_endofpacket;                                                                      // id_router_005:src_endofpacket -> rsp_xbar_demux_005:sink_endofpacket
	wire         id_router_005_src_valid;                                                                            // id_router_005:src_valid -> rsp_xbar_demux_005:sink_valid
	wire         id_router_005_src_startofpacket;                                                                    // id_router_005:src_startofpacket -> rsp_xbar_demux_005:sink_startofpacket
	wire  [88:0] id_router_005_src_data;                                                                             // id_router_005:src_data -> rsp_xbar_demux_005:sink_data
	wire   [5:0] id_router_005_src_channel;                                                                          // id_router_005:src_channel -> rsp_xbar_demux_005:sink_channel
	wire         id_router_005_src_ready;                                                                            // rsp_xbar_demux_005:sink_ready -> id_router_005:src_ready
	wire   [5:0] limiter_cmd_valid_data;                                                                             // limiter:cmd_src_valid -> cmd_xbar_demux:sink_valid
	wire         irq_mapper_receiver0_irq;                                                                           // jtag_uart_0:av_irq -> irq_mapper:receiver0_irq
	wire  [31:0] nios2_cpu_d_irq_irq;                                                                                // irq_mapper:sender_irq -> nios2_cpu:d_irq

	Cpu_0_nios2_cpu nios2_cpu (
		.clk                                   (clk_clk),                                                                //                       clk.clk
		.reset_n                               (~rst_controller_reset_out_reset),                                        //                   reset_n.reset_n
		.d_address                             (nios2_cpu_data_master_address),                                          //               data_master.address
		.d_byteenable                          (nios2_cpu_data_master_byteenable),                                       //                          .byteenable
		.d_read                                (nios2_cpu_data_master_read),                                             //                          .read
		.d_readdata                            (nios2_cpu_data_master_readdata),                                         //                          .readdata
		.d_waitrequest                         (nios2_cpu_data_master_waitrequest),                                      //                          .waitrequest
		.d_write                               (nios2_cpu_data_master_write),                                            //                          .write
		.d_writedata                           (nios2_cpu_data_master_writedata),                                        //                          .writedata
		.jtag_debug_module_debugaccess_to_roms (nios2_cpu_data_master_debugaccess),                                      //                          .debugaccess
		.i_address                             (nios2_cpu_instruction_master_address),                                   //        instruction_master.address
		.i_read                                (nios2_cpu_instruction_master_read),                                      //                          .read
		.i_readdata                            (nios2_cpu_instruction_master_readdata),                                  //                          .readdata
		.i_waitrequest                         (nios2_cpu_instruction_master_waitrequest),                               //                          .waitrequest
		.i_readdatavalid                       (nios2_cpu_instruction_master_readdatavalid),                             //                          .readdatavalid
		.d_irq                                 (nios2_cpu_d_irq_irq),                                                    //                     d_irq.irq
		.jtag_debug_module_resetrequest        (nios2_cpu_jtag_debug_module_reset_reset),                                //   jtag_debug_module_reset.reset
		.jtag_debug_module_address             (nios2_cpu_jtag_debug_module_translator_avalon_anti_slave_0_address),     //         jtag_debug_module.address
		.jtag_debug_module_byteenable          (nios2_cpu_jtag_debug_module_translator_avalon_anti_slave_0_byteenable),  //                          .byteenable
		.jtag_debug_module_debugaccess         (nios2_cpu_jtag_debug_module_translator_avalon_anti_slave_0_debugaccess), //                          .debugaccess
		.jtag_debug_module_read                (nios2_cpu_jtag_debug_module_translator_avalon_anti_slave_0_read),        //                          .read
		.jtag_debug_module_readdata            (nios2_cpu_jtag_debug_module_translator_avalon_anti_slave_0_readdata),    //                          .readdata
		.jtag_debug_module_waitrequest         (nios2_cpu_jtag_debug_module_translator_avalon_anti_slave_0_waitrequest), //                          .waitrequest
		.jtag_debug_module_write               (nios2_cpu_jtag_debug_module_translator_avalon_anti_slave_0_write),       //                          .write
		.jtag_debug_module_writedata           (nios2_cpu_jtag_debug_module_translator_avalon_anti_slave_0_writedata),   //                          .writedata
		.no_ci_readra                          ()                                                                        // custom_instruction_master.readra
	);

	Cpu_0_onchip_memory2_0 onchip_memory2_0 (
		.clk        (clk_clk),                                                       //   clk1.clk
		.address    (onchip_memory2_0_s1_translator_avalon_anti_slave_0_address),    //     s1.address
		.clken      (onchip_memory2_0_s1_translator_avalon_anti_slave_0_clken),      //       .clken
		.chipselect (onchip_memory2_0_s1_translator_avalon_anti_slave_0_chipselect), //       .chipselect
		.write      (onchip_memory2_0_s1_translator_avalon_anti_slave_0_write),      //       .write
		.readdata   (onchip_memory2_0_s1_translator_avalon_anti_slave_0_readdata),   //       .readdata
		.writedata  (onchip_memory2_0_s1_translator_avalon_anti_slave_0_writedata),  //       .writedata
		.byteenable (onchip_memory2_0_s1_translator_avalon_anti_slave_0_byteenable), //       .byteenable
		.reset      (rst_controller_001_reset_out_reset)                             // reset1.reset
	);

	Cpu_0_jtag_uart_0 jtag_uart_0 (
		.clk            (clk_clk),                                                                  //               clk.clk
		.rst_n          (~rst_controller_001_reset_out_reset),                                      //             reset.reset_n
		.av_chipselect  (jtag_uart_0_avalon_jtag_slave_translator_avalon_anti_slave_0_chipselect),  // avalon_jtag_slave.chipselect
		.av_address     (jtag_uart_0_avalon_jtag_slave_translator_avalon_anti_slave_0_address),     //                  .address
		.av_read_n      (~jtag_uart_0_avalon_jtag_slave_translator_avalon_anti_slave_0_read),       //                  .read_n
		.av_readdata    (jtag_uart_0_avalon_jtag_slave_translator_avalon_anti_slave_0_readdata),    //                  .readdata
		.av_write_n     (~jtag_uart_0_avalon_jtag_slave_translator_avalon_anti_slave_0_write),      //                  .write_n
		.av_writedata   (jtag_uart_0_avalon_jtag_slave_translator_avalon_anti_slave_0_writedata),   //                  .writedata
		.av_waitrequest (jtag_uart_0_avalon_jtag_slave_translator_avalon_anti_slave_0_waitrequest), //                  .waitrequest
		.av_irq         (irq_mapper_receiver0_irq)                                                  //               irq.irq
	);

	Cpu_0_pio_angle pio_angle (
		.clk      (clk_clk),                                              //                 clk.clk
		.reset_n  (~rst_controller_001_reset_out_reset),                  //               reset.reset_n
		.address  (pio_angle_s1_translator_avalon_anti_slave_0_address),  //                  s1.address
		.readdata (pio_angle_s1_translator_avalon_anti_slave_0_readdata), //                    .readdata
		.in_port  (pio_angle_external_connection_export)                  // external_connection.export
	);

	Cpu_0_pio_lcd_data pio_lcd_data (
		.clk        (clk_clk),                                                   //                 clk.clk
		.reset_n    (~rst_controller_001_reset_out_reset),                       //               reset.reset_n
		.address    (pio_lcd_data_s1_translator_avalon_anti_slave_0_address),    //                  s1.address
		.write_n    (~pio_lcd_data_s1_translator_avalon_anti_slave_0_write),     //                    .write_n
		.writedata  (pio_lcd_data_s1_translator_avalon_anti_slave_0_writedata),  //                    .writedata
		.chipselect (pio_lcd_data_s1_translator_avalon_anti_slave_0_chipselect), //                    .chipselect
		.readdata   (pio_lcd_data_s1_translator_avalon_anti_slave_0_readdata),   //                    .readdata
		.out_port   (pio_lcd_data_external_connection_export)                    // external_connection.export
	);

	Cpu_0_pio_control pio_control (
		.clk        (clk_clk),                                                  //                 clk.clk
		.reset_n    (~rst_controller_001_reset_out_reset),                      //               reset.reset_n
		.address    (pio_control_s1_translator_avalon_anti_slave_0_address),    //                  s1.address
		.write_n    (~pio_control_s1_translator_avalon_anti_slave_0_write),     //                    .write_n
		.writedata  (pio_control_s1_translator_avalon_anti_slave_0_writedata),  //                    .writedata
		.chipselect (pio_control_s1_translator_avalon_anti_slave_0_chipselect), //                    .chipselect
		.readdata   (pio_control_s1_translator_avalon_anti_slave_0_readdata),   //                    .readdata
		.out_port   (pio_control_external_connection_export)                    // external_connection.export
	);

	altera_merlin_master_translator #(
		.AV_ADDRESS_W                (16),
		.AV_DATA_W                   (32),
		.AV_BURSTCOUNT_W             (1),
		.AV_BYTEENABLE_W             (4),
		.UAV_ADDRESS_W               (16),
		.UAV_BURSTCOUNT_W            (3),
		.USE_READ                    (1),
		.USE_WRITE                   (0),
		.USE_BEGINBURSTTRANSFER      (0),
		.USE_BEGINTRANSFER           (0),
		.USE_CHIPSELECT              (0),
		.USE_BURSTCOUNT              (0),
		.USE_READDATAVALID           (1),
		.USE_WAITREQUEST             (1),
		.USE_READRESPONSE            (0),
		.USE_WRITERESPONSE           (0),
		.AV_SYMBOLS_PER_WORD         (4),
		.AV_ADDRESS_SYMBOLS          (1),
		.AV_BURSTCOUNT_SYMBOLS       (0),
		.AV_CONSTANT_BURST_BEHAVIOR  (0),
		.UAV_CONSTANT_BURST_BEHAVIOR (0),
		.AV_LINEWRAPBURSTS           (1),
		.AV_REGISTERINCOMINGSIGNALS  (0)
	) nios2_cpu_instruction_master_translator (
		.clk                      (clk_clk),                                                                         //                       clk.clk
		.reset                    (rst_controller_reset_out_reset),                                                  //                     reset.reset
		.uav_address              (nios2_cpu_instruction_master_translator_avalon_universal_master_0_address),       // avalon_universal_master_0.address
		.uav_burstcount           (nios2_cpu_instruction_master_translator_avalon_universal_master_0_burstcount),    //                          .burstcount
		.uav_read                 (nios2_cpu_instruction_master_translator_avalon_universal_master_0_read),          //                          .read
		.uav_write                (nios2_cpu_instruction_master_translator_avalon_universal_master_0_write),         //                          .write
		.uav_waitrequest          (nios2_cpu_instruction_master_translator_avalon_universal_master_0_waitrequest),   //                          .waitrequest
		.uav_readdatavalid        (nios2_cpu_instruction_master_translator_avalon_universal_master_0_readdatavalid), //                          .readdatavalid
		.uav_byteenable           (nios2_cpu_instruction_master_translator_avalon_universal_master_0_byteenable),    //                          .byteenable
		.uav_readdata             (nios2_cpu_instruction_master_translator_avalon_universal_master_0_readdata),      //                          .readdata
		.uav_writedata            (nios2_cpu_instruction_master_translator_avalon_universal_master_0_writedata),     //                          .writedata
		.uav_lock                 (nios2_cpu_instruction_master_translator_avalon_universal_master_0_lock),          //                          .lock
		.uav_debugaccess          (nios2_cpu_instruction_master_translator_avalon_universal_master_0_debugaccess),   //                          .debugaccess
		.av_address               (nios2_cpu_instruction_master_address),                                            //      avalon_anti_master_0.address
		.av_waitrequest           (nios2_cpu_instruction_master_waitrequest),                                        //                          .waitrequest
		.av_read                  (nios2_cpu_instruction_master_read),                                               //                          .read
		.av_readdata              (nios2_cpu_instruction_master_readdata),                                           //                          .readdata
		.av_readdatavalid         (nios2_cpu_instruction_master_readdatavalid),                                      //                          .readdatavalid
		.av_burstcount            (1'b1),                                                                            //               (terminated)
		.av_byteenable            (4'b1111),                                                                         //               (terminated)
		.av_beginbursttransfer    (1'b0),                                                                            //               (terminated)
		.av_begintransfer         (1'b0),                                                                            //               (terminated)
		.av_chipselect            (1'b0),                                                                            //               (terminated)
		.av_write                 (1'b0),                                                                            //               (terminated)
		.av_writedata             (32'b00000000000000000000000000000000),                                            //               (terminated)
		.av_lock                  (1'b0),                                                                            //               (terminated)
		.av_debugaccess           (1'b0),                                                                            //               (terminated)
		.uav_clken                (),                                                                                //               (terminated)
		.av_clken                 (1'b1),                                                                            //               (terminated)
		.uav_response             (2'b00),                                                                           //               (terminated)
		.av_response              (),                                                                                //               (terminated)
		.uav_writeresponserequest (),                                                                                //               (terminated)
		.uav_writeresponsevalid   (1'b0),                                                                            //               (terminated)
		.av_writeresponserequest  (1'b0),                                                                            //               (terminated)
		.av_writeresponsevalid    ()                                                                                 //               (terminated)
	);

	altera_merlin_master_translator #(
		.AV_ADDRESS_W                (16),
		.AV_DATA_W                   (32),
		.AV_BURSTCOUNT_W             (1),
		.AV_BYTEENABLE_W             (4),
		.UAV_ADDRESS_W               (16),
		.UAV_BURSTCOUNT_W            (3),
		.USE_READ                    (1),
		.USE_WRITE                   (1),
		.USE_BEGINBURSTTRANSFER      (0),
		.USE_BEGINTRANSFER           (0),
		.USE_CHIPSELECT              (0),
		.USE_BURSTCOUNT              (0),
		.USE_READDATAVALID           (0),
		.USE_WAITREQUEST             (1),
		.USE_READRESPONSE            (0),
		.USE_WRITERESPONSE           (0),
		.AV_SYMBOLS_PER_WORD         (4),
		.AV_ADDRESS_SYMBOLS          (1),
		.AV_BURSTCOUNT_SYMBOLS       (0),
		.AV_CONSTANT_BURST_BEHAVIOR  (0),
		.UAV_CONSTANT_BURST_BEHAVIOR (0),
		.AV_LINEWRAPBURSTS           (0),
		.AV_REGISTERINCOMINGSIGNALS  (0)
	) nios2_cpu_data_master_translator (
		.clk                      (clk_clk),                                                                  //                       clk.clk
		.reset                    (rst_controller_reset_out_reset),                                           //                     reset.reset
		.uav_address              (nios2_cpu_data_master_translator_avalon_universal_master_0_address),       // avalon_universal_master_0.address
		.uav_burstcount           (nios2_cpu_data_master_translator_avalon_universal_master_0_burstcount),    //                          .burstcount
		.uav_read                 (nios2_cpu_data_master_translator_avalon_universal_master_0_read),          //                          .read
		.uav_write                (nios2_cpu_data_master_translator_avalon_universal_master_0_write),         //                          .write
		.uav_waitrequest          (nios2_cpu_data_master_translator_avalon_universal_master_0_waitrequest),   //                          .waitrequest
		.uav_readdatavalid        (nios2_cpu_data_master_translator_avalon_universal_master_0_readdatavalid), //                          .readdatavalid
		.uav_byteenable           (nios2_cpu_data_master_translator_avalon_universal_master_0_byteenable),    //                          .byteenable
		.uav_readdata             (nios2_cpu_data_master_translator_avalon_universal_master_0_readdata),      //                          .readdata
		.uav_writedata            (nios2_cpu_data_master_translator_avalon_universal_master_0_writedata),     //                          .writedata
		.uav_lock                 (nios2_cpu_data_master_translator_avalon_universal_master_0_lock),          //                          .lock
		.uav_debugaccess          (nios2_cpu_data_master_translator_avalon_universal_master_0_debugaccess),   //                          .debugaccess
		.av_address               (nios2_cpu_data_master_address),                                            //      avalon_anti_master_0.address
		.av_waitrequest           (nios2_cpu_data_master_waitrequest),                                        //                          .waitrequest
		.av_byteenable            (nios2_cpu_data_master_byteenable),                                         //                          .byteenable
		.av_read                  (nios2_cpu_data_master_read),                                               //                          .read
		.av_readdata              (nios2_cpu_data_master_readdata),                                           //                          .readdata
		.av_write                 (nios2_cpu_data_master_write),                                              //                          .write
		.av_writedata             (nios2_cpu_data_master_writedata),                                          //                          .writedata
		.av_debugaccess           (nios2_cpu_data_master_debugaccess),                                        //                          .debugaccess
		.av_burstcount            (1'b1),                                                                     //               (terminated)
		.av_beginbursttransfer    (1'b0),                                                                     //               (terminated)
		.av_begintransfer         (1'b0),                                                                     //               (terminated)
		.av_chipselect            (1'b0),                                                                     //               (terminated)
		.av_readdatavalid         (),                                                                         //               (terminated)
		.av_lock                  (1'b0),                                                                     //               (terminated)
		.uav_clken                (),                                                                         //               (terminated)
		.av_clken                 (1'b1),                                                                     //               (terminated)
		.uav_response             (2'b00),                                                                    //               (terminated)
		.av_response              (),                                                                         //               (terminated)
		.uav_writeresponserequest (),                                                                         //               (terminated)
		.uav_writeresponsevalid   (1'b0),                                                                     //               (terminated)
		.av_writeresponserequest  (1'b0),                                                                     //               (terminated)
		.av_writeresponsevalid    ()                                                                          //               (terminated)
	);
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
