clasicus/Diplom/Controller_ASK2/Nios_cpu/cpu_ASK2/simulation/submodules/cpu_ASK2_nios2_qsys_0_test_bench.v

//Legal Notice: (C)2018 Altera Corporation. All rights reserved.  Your
//use of Altera Corporation's design tools, logic functions and other
//software and tools, and its AMPP partner logic functions, and any
//output files any of the foregoing (including device programming or
//simulation files), and any associated documentation or information are
//expressly subject to the terms and conditions of the Altera Program
//License Subscription Agreement or other applicable license agreement,
//including, without limitation, that your use is for the sole purpose
//of programming logic devices manufactured by Altera and sold by Altera
//or its authorized distributors.  Please refer to the applicable
//agreement for further details.

// synthesis translate_off
`timescale 1ns / 1ps
// synthesis translate_on

// turn off superfluous verilog processor warnings 
// altera message_level Level1 
// altera message_off 10034 10035 10036 10037 10230 10240 10030 

module cpu_ASK2_nios2_qsys_0_test_bench (
                                          // inputs:
                                           E_src1,
                                           E_src2,
                                           E_valid,
                                           M_ctrl_ld_non_io,
                                           M_en,
                                           M_valid,
                                           M_wr_data_unfiltered,
                                           M_wr_dst_reg,
                                           W_dst_regnum,
                                           W_iw,
                                           W_iw_op,
                                           W_iw_opx,
                                           W_pcb,
                                           W_valid,
                                           W_vinst,
                                           W_wr_data,
                                           W_wr_dst_reg,
                                           clk,
                                           d_address,
                                           d_byteenable,
                                           d_read,
                                           d_write,
                                           i_address,
                                           i_read,
                                           i_readdatavalid,
                                           reset_n,

                                          // outputs:
                                           E_src1_eq_src2,
                                           M_wr_data_filtered,
                                           test_has_ended
                                        )
;

  output           E_src1_eq_src2;
  output  [ 31: 0] M_wr_data_filtered;
  output           test_has_ended;
  input   [ 31: 0] E_src1;
  input   [ 31: 0] E_src2;
  input            E_valid;
  input            M_ctrl_ld_non_io;
  input            M_en;
  input            M_valid;
  input   [ 31: 0] M_wr_data_unfiltered;
  input            M_wr_dst_reg;
  input   [  4: 0] W_dst_regnum;
  input   [ 31: 0] W_iw;
  input   [  5: 0] W_iw_op;
  input   [  5: 0] W_iw_opx;
  input   [ 14: 0] W_pcb;
  input            W_valid;
  input   [ 55: 0] W_vinst;
  input   [ 31: 0] W_wr_data;
  input            W_wr_dst_reg;
  input            clk;
  input   [ 14: 0] d_address;
  input   [  3: 0] d_byteenable;
  input            d_read;
  input            d_write;
  input   [ 14: 0] i_address;
  input            i_read;
  input            i_readdatavalid;
  input            reset_n;

  wire             E_src1_eq_src2;
  wire    [ 32: 0] E_src1_src2_fast_cmp;
  reg     [ 14: 0] M_target_pcb;
  wire    [ 31: 0] M_wr_data_filtered;
  wire             M_wr_data_unfiltered_0_is_x;
  wire             M_wr_data_unfiltered_10_is_x;
  wire             M_wr_data_unfiltered_11_is_x;
  wire             M_wr_data_unfiltered_12_is_x;
  wire             M_wr_data_unfiltered_13_is_x;
  wire             M_wr_data_unfiltered_14_is_x;
  wire             M_wr_data_unfiltered_15_is_x;
  wire             M_wr_data_unfiltered_16_is_x;
  wire             M_wr_data_unfiltered_17_is_x;
  wire             M_wr_data_unfiltered_18_is_x;
  wire             M_wr_data_unfiltered_19_is_x;
  wire             M_wr_data_unfiltered_1_is_x;
  wire             M_wr_data_unfiltered_20_is_x;
  wire             M_wr_data_unfiltered_21_is_x;
  wire             M_wr_data_unfiltered_22_is_x;
  wire             M_wr_data_unfiltered_23_is_x;
  wire             M_wr_data_unfiltered_24_is_x;
  wire             M_wr_data_unfiltered_25_is_x;
  wire             M_wr_data_unfiltered_26_is_x;
  wire             M_wr_data_unfiltered_27_is_x;
  wire             M_wr_data_unfiltered_28_is_x;
  wire             M_wr_data_unfiltered_29_is_x;
  wire             M_wr_data_unfiltered_2_is_x;
  wire             M_wr_data_unfiltered_30_is_x;
  wire             M_wr_data_unfiltered_31_is_x;
  wire             M_wr_data_unfiltered_3_is_x;
  wire             M_wr_data_unfiltered_4_is_x;
  wire             M_wr_data_unfiltered_5_is_x;
  wire             M_wr_data_unfiltered_6_is_x;
  wire             M_wr_data_unfiltered_7_is_x;
  wire             M_wr_data_unfiltered_8_is_x;
  wire             M_wr_data_unfiltered_9_is_x;
  wire             W_op_add;
  wire             W_op_addi;
  wire             W_op_and;
  wire             W_op_andhi;
  wire             W_op_andi;
  wire             W_op_beq;
  wire             W_op_bge;
  wire             W_op_bgeu;
  wire             W_op_blt;
  wire             W_op_bltu;
  wire             W_op_bne;
  wire             W_op_br;
  wire             W_op_break;
  wire             W_op_bret;
  wire             W_op_call;
  wire             W_op_callr;
  wire             W_op_cmpeq;
  wire             W_op_cmpeqi;
  wire             W_op_cmpge;
  wire             W_op_cmpgei;
  wire             W_op_cmpgeu;
  wire             W_op_cmpgeui;
  wire             W_op_cmplt;
  wire             W_op_cmplti;
  wire             W_op_cmpltu;
  wire             W_op_cmpltui;
  wire             W_op_cmpne;
  wire             W_op_cmpnei;
  wire             W_op_crst;
  wire             W_op_custom;
  wire             W_op_div;
  wire             W_op_divu;
  wire             W_op_eret;
  wire             W_op_flushd;
  wire             W_op_flushda;
  wire             W_op_flushi;
  wire             W_op_flushp;
  wire             W_op_hbreak;
  wire             W_op_initd;
  wire             W_op_initda;
  wire             W_op_initi;
  wire             W_op_intr;
  wire             W_op_jmp;
  wire             W_op_jmpi;
  wire             W_op_ldb;
  wire             W_op_ldbio;
  wire             W_op_ldbu;
  wire             W_op_ldbuio;
  wire             W_op_ldh;
  wire             W_op_ldhio;
  wire             W_op_ldhu;
  wire             W_op_ldhuio;
  wire             W_op_ldl;
  wire             W_op_ldw;
  wire             W_op_ldwio;
  wire             W_op_mul;
  wire             W_op_muli;
  wire             W_op_mulxss;
  wire             W_op_mulxsu;
  wire             W_op_mulxuu;
  wire             W_op_nextpc;
  wire             W_op_nor;
  wire             W_op_opx;
  wire             W_op_or;
  wire             W_op_orhi;
  wire             W_op_ori;
  wire             W_op_rdctl;
  wire             W_op_rdprs;
  wire             W_op_ret;
  wire             W_op_rol;
  wire             W_op_roli;
  wire             W_op_ror;
  wire             W_op_rsv02;
  wire             W_op_rsv09;
  wire             W_op_rsv10;
  wire             W_op_rsv17;
  wire             W_op_rsv18;
  wire             W_op_rsv25;
  wire             W_op_rsv26;
  wire             W_op_rsv33;
  wire             W_op_rsv34;
  wire             W_op_rsv41;
  wire             W_op_rsv42;
  wire             W_op_rsv49;
  wire             W_op_rsv57;
  wire             W_op_rsv61;
  wire             W_op_rsv62;
  wire             W_op_rsv63;
  wire             W_op_rsvx00;
  wire             W_op_rsvx10;
  wire             W_op_rsvx15;
  wire             W_op_rsvx17;
  wire             W_op_rsvx21;
  wire             W_op_rsvx25;
  wire             W_op_rsvx33;
  wire             W_op_rsvx34;
  wire             W_op_rsvx35;
  wire             W_op_rsvx42;
  wire             W_op_rsvx43;
  wire             W_op_rsvx44;
  wire             W_op_rsvx47;
  wire             W_op_rsvx50;
  wire             W_op_rsvx51;
  wire             W_op_rsvx55;
  wire             W_op_rsvx56;
  wire             W_op_rsvx60;
  wire             W_op_rsvx63;
  wire             W_op_sll;
  wire             W_op_slli;
  wire             W_op_sra;
  wire             W_op_srai;
  wire             W_op_srl;
  wire             W_op_srli;
  wire             W_op_stb;
  wire             W_op_stbio;
  wire             W_op_stc;
  wire             W_op_sth;
  wire             W_op_sthio;
  wire             W_op_stw;
  wire             W_op_stwio;
  wire             W_op_sub;
  wire             W_op_sync;
  wire             W_op_trap;
  wire             W_op_wrctl;
  wire             W_op_wrprs;
  wire             W_op_xor;
  wire             W_op_xorhi;
  wire             W_op_xori;
  wire             test_has_ended;
  assign W_op_call = W_iw_op == 0;
  assign W_op_jmpi = W_iw_op == 1;
  assign W_op_ldbu = W_iw_op == 3;
  assign W_op_addi = W_iw_op == 4;
  assign W_op_stb = W_iw_op == 5;
  assign W_op_br = W_iw_op == 6;
  assign W_op_ldb = W_iw_op == 7;
  assign W_op_cmpgei = W_iw_op == 8;
  assign W_op_ldhu = W_iw_op == 11;
  assign W_op_andi = W_iw_op == 12;
  assign W_op_sth = W_iw_op == 13;
  assign W_op_bge = W_iw_op == 14;
  assign W_op_ldh = W_iw_op == 15;
  assign W_op_cmplti = W_iw_op == 16;
  assign W_op_initda = W_iw_op == 19;
  assign W_op_ori = W_iw_op == 20;
  assign W_op_stw = W_iw_op == 21;
  assign W_op_blt = W_iw_op == 22;
  assign W_op_ldw = W_iw_op == 23;
  assign W_op_cmpnei = W_iw_op == 24;
  assign W_op_flushda = W_iw_op == 27;
  assign W_op_xori = W_iw_op == 28;
  assign W_op_stc = W_iw_op == 29;
  assign W_op_bne = W_iw_op == 30;
  assign W_op_ldl = W_iw_op == 31;
  assign W_op_cmpeqi = W_iw_op == 32;
  assign W_op_ldbuio = W_iw_op == 35;
  assign W_op_muli = W_iw_op == 36;
  assign W_op_stbio = W_iw_op == 37;
  assign W_op_beq = W_iw_op == 38;
  assign W_op_ldbio = W_iw_op == 39;
  assign W_op_cmpgeui = W_iw_op == 40;
  assign W_op_ldhuio = W_iw_op == 43;
  assign W_op_andhi = W_iw_op == 44;
  assign W_op_sthio = W_iw_op == 45;
  assign W_op_bgeu = W_iw_op == 46;
  assign W_op_ldhio = W_iw_op == 47;
  assign W_op_cmpltui = W_iw_op == 48;
  assign W_op_initd = W_iw_op == 51;
  assign W_op_orhi = W_iw_op == 52;
  assign W_op_stwio = W_iw_op == 53;
  assign W_op_bltu = W_iw_op == 54;
  assign W_op_ldwio = W_iw_op == 55;
  assign W_op_rdprs = W_iw_op == 56;
  assign W_op_flushd = W_iw_op == 59;
  assign W_op_xorhi = W_iw_op == 60;
  assign W_op_rsv02 = W_iw_op == 2;
  assign W_op_rsv09 = W_iw_op == 9;
  assign W_op_rsv10 = W_iw_op == 10;
  assign W_op_rsv17 = W_iw_op == 17;
  assign W_op_rsv18 = W_iw_op == 18;
  assign W_op_rsv25 = W_iw_op == 25;
  assign W_op_rsv26 = W_iw_op == 26;
  assign W_op_rsv33 = W_iw_op == 33;
  assign W_op_rsv34 = W_iw_op == 34;
  assign W_op_rsv41 = W_iw_op == 41;
  assign W_op_rsv42 = W_iw_op == 42;
  assign W_op_rsv49 = W_iw_op == 49;
  assign W_op_rsv57 = W_iw_op == 57;
  assign W_op_rsv61 = W_iw_op == 61;
  assign W_op_rsv62 = W_iw_op == 62;
  assign W_op_rsv63 = W_iw_op == 63;
  assign W_op_eret = W_op_opx & (W_iw_opx == 1);
  assign W_op_roli = W_op_opx & (W_iw_opx == 2);
  assign W_op_rol = W_op_opx & (W_iw_opx == 3);
  assign W_op_flushp = W_op_opx & (W_iw_opx == 4);
  assign W_op_ret = W_op_opx & (W_iw_opx == 5);
  assign W_op_nor = W_op_opx & (W_iw_opx == 6);
  assign W_op_mulxuu = W_op_opx & (W_iw_opx == 7);
  assign W_op_cmpge = W_op_opx & (W_iw_opx == 8);
  assign W_op_bret = W_op_opx & (W_iw_opx == 9);
  assign W_op_ror = W_op_opx & (W_iw_opx == 11);
  assign W_op_flushi = W_op_opx & (W_iw_opx == 12);
  assign W_op_jmp = W_op_opx & (W_iw_opx == 13);
  assign W_op_and = W_op_opx & (W_iw_opx == 14);
  assign W_op_cmplt = W_op_opx & (W_iw_opx == 16);
  assign W_op_slli = W_op_opx & (W_iw_opx == 18);
  assign W_op_sll = W_op_opx & (W_iw_opx == 19);
  assign W_op_wrprs = W_op_opx & (W_iw_opx == 20);
  assign W_op_or = W_op_opx & (W_iw_opx == 22);
  assign W_op_mulxsu = W_op_opx & (W_iw_opx == 23);
  assign W_op_cmpne = W_op_opx & (W_iw_opx == 24);
  assign W_op_srli = W_op_opx & (W_iw_opx == 26);
  assign W_op_srl = W_op_opx & (W_iw_opx == 27);
  assign W_op_nextpc = W_op_opx & (W_iw_opx == 28);
  assign W_op_callr = W_op_opx & (W_iw_opx == 29);
  assign W_op_xor = W_op_opx & (W_iw_opx == 30);
  assign W_op_mulxss = W_op_opx & (W_iw_opx == 31);
  assign W_op_cmpeq = W_op_opx & (W_iw_opx == 32);
  assign W_op_divu = W_op_opx & (W_iw_opx == 36);
  assign W_op_div = W_op_opx & (W_iw_opx == 37);
  assign W_op_rdctl = W_op_opx & (W_iw_opx == 38);
  assign W_op_mul = W_op_opx & (W_iw_opx == 39);
  assign W_op_cmpgeu = W_op_opx & (W_iw_opx == 40);
  assign W_op_initi = W_op_opx & (W_iw_opx == 41);
  assign W_op_trap = W_op_opx & (W_iw_opx == 45);
  assign W_op_wrctl = W_op_opx & (W_iw_opx == 46);
  assign W_op_cmpltu = W_op_opx & (W_iw_opx == 48);
  assign W_op_add = W_op_opx & (W_iw_opx == 49);
  assign W_op_break = W_op_opx & (W_iw_opx == 52);
  assign W_op_hbreak = W_op_opx & (W_iw_opx == 53);
  assign W_op_sync = W_op_opx & (W_iw_opx == 54);
  assign W_op_sub = W_op_opx & (W_iw_opx == 57);
  assign W_op_srai = W_op_opx & (W_iw_opx == 58);
  assign W_op_sra = W_op_opx & (W_iw_opx == 59);
  assign W_op_intr = W_op_opx & (W_iw_opx == 61);
  assign W_op_crst = W_op_opx & (W_iw_opx == 62);
  assign W_op_rsvx00 = W_op_opx & (W_iw_opx == 0);
  assign W_op_rsvx10 = W_op_opx & (W_iw_opx == 10);
  assign W_op_rsvx15 = W_op_opx & (W_iw_opx == 15);
  assign W_op_rsvx17 = W_op_opx & (W_iw_opx == 17);
  assign W_op_rsvx21 = W_op_opx & (W_iw_opx == 21);
  assign W_op_rsvx25 = W_op_opx & (W_iw_opx == 25);
  assign W_op_rsvx33 = W_op_opx & (W_iw_opx == 33);
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
