clasicus/Diplom/(commit log)

2018-06-04 added all project files
    [ACK_2_Sheet6.SchDoc, ACR_2_Sheet7.SchDoc, B2B-XH-A.STEP, CONN_5747845-4.step, Controller_ASK2.smp_dump.txt, Sheet1.SchDoc, Sheet2.SchDoc, Sheet3.SchDoc]
2018-06-04 new changes
    [Sheet1.SchDoc, АСК_2.PrjPcb, АСК_2.SCHLIB, ДК41.750706.001 СК Плата. Складальне креслення.dwg]
2018-06-04 added board calculating
    [Book1.xlsx, Book1_Коляда.xlsx]
2018-06-05 Changed PZ
    [ДК41.750706.001 СК Плата. Складальне креслення.dwg, ДК41.750706.001 СК Плата.Складальне креслення.dwg]
2018-06-06 changed drawings
    [Sheet1.SchDoc, АСК_2.PrjPcb, ДК41.750706.001 СК Плата.Складальне креслення 777.dwg, ДК41.750706.001 СК Плата.Складальне креслення.dwg]
2018-06-06 changed all
    [ДК41.750706.001 СК Плата.Складальне креслення.dwg, ДК41.758726.001 Плата друкована.dwg, ДК41.758826.001 Плата друкована.dwg]
2018-06-09 finished 4 chapter, but no 100%
    [Книга1.xlsx]
2018-06-12 almost finish
    [Sheet1.SchDoc]
2018-06-13 added abstract
    [ДК41_750706_001_СК_Плата_Складальне.dwg]
2018-06-15 need to print
2018-06-15 pre norm control 2
    [ДК41.758726.001 Плата друкована1.dwg, Структурка.dwg]
2018-06-16 deleted trash
    [Book1.xlsx, Book1_Коляда.xlsx, ДК41.750706.001 СК Плата. Складальне креслення.dwg, ДК41.758726.001 Плата друкована.dwg, ДК41.758726.001 Плата друкована1.dwg, ДК41_750706_001_СК_Плата_Складальне.dwg]
2018-06-19 FINAL VERSION!
    [Книга1.xlsx]
